afxjzs/solar-logger/logs/evidence/2026-09-25/ina228-purchase-listing.png

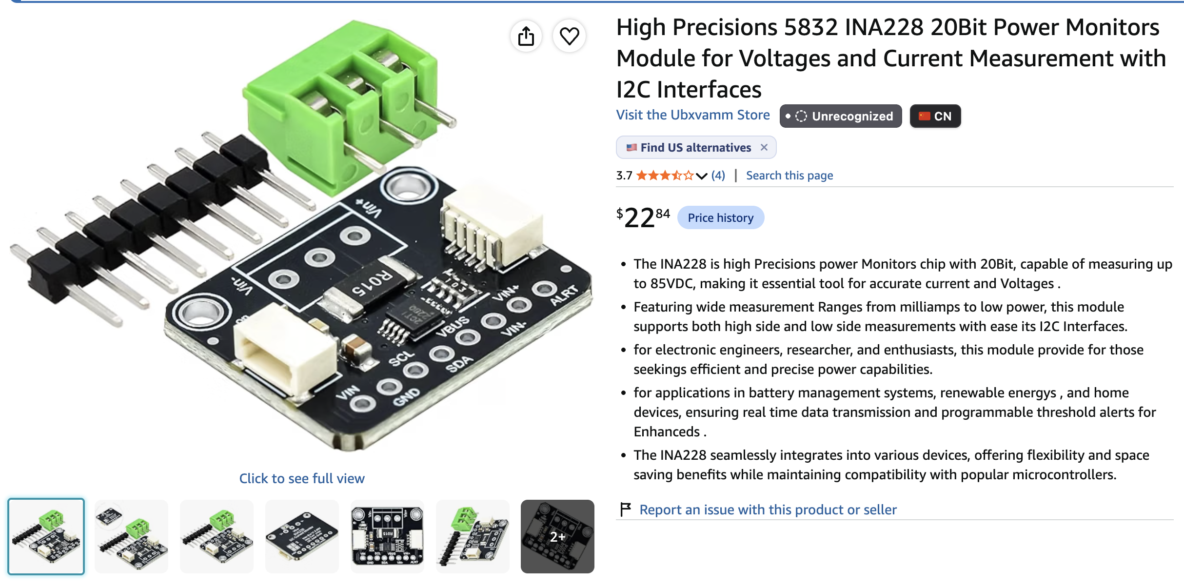
logs/evidence/2026-09-25/ina228-purchase-listing.png
