afxjzs/solar-logger/docs/DECISIONS.md

# Decisions

Entries retain the context and examples from when they were adopted. Later
amendments identify superseded behavior; current operating instructions and
firmware identity are in PROJECT, and dated hardware evidence is in LAB_NOTES.

## D-001: `data/` is live telemetry

The Python logger writes current telemetry to `data/samples.csv`, `data/intervals.csv`, and `data/events.csv`. `logs/` remains archive/legacy data. New code and documentation must use `data/` for live polling output.

## D-002: Upload owns Serial only after logger release

`tools/upload.sh` compiles before serial coordination. When the Python logger is running, the uploader uses `.upload-in-progress` with the content protocol `REQUESTED -> RELEASED`. The uploader must abort if the logger is detected but does not acknowledge release within five seconds. Uploading anyway would allow esptool and the logger to race for the same device.

When no logger process is running, the uploader skips the handshake because no logger can acknowledge it or own the port. It then discovers the current `/dev/cu.usbmodem*` device immediately before upload. The marker is cleaned on success, failure, Ctrl-C, and termination.

## D-003: Commands use a logger-owned handoff

`tools/send.sh` does not open Serial when `app/solar_logger.py` is running. It creates `.serial-command` without overwriting an existing file. The Python logger sends the newline-terminated command through its existing pyserial connection, flushes it, and removes the file.

If the logger is not running, `send.sh` may open the discovered modem directly. If `.upload-in-progress` exists, command sending is refused. These rules keep command sending, live logging, and firmware upload from creating competing Serial owners.

## D-004: Host timestamps supplement firmware time

The Python logger adds timezone-aware local Mac `captured_at` values to samples, intervals, and events. The timestamp approximates when the complete Serial line reached the host. Firmware elapsed time remains in the row because it is the experiment clock and supports relative analysis across an experiment.

## D-005: Existing CSV schemas fail closed

The logger compares an existing CSV header with the expected current header before appending. A mismatch produces an explicit error and stops startup. The logger does not silently place timestamped rows under an old header and does not automatically migrate, rewrite, or delete old data.

## D-006: Wi-Fi bench test state is separate from experiment state

`POWER TEST WIFI` stores its armed state in the separate NVS key `wifi_test_armed`. The test uses `millis()` to run explicit 30-second OFF, ON, and OFF phases without blocking the logger loop. It starts again after reboot when the flag is present.

The Wi-Fi test must not reset, increment, migrate, or rewrite the experiment checkpoint. `POWER TEST STOP` turns Wi-Fi off and clears only the Wi-Fi test flag.

Wi-Fi ON means station mode with no access-point association. That state is useful for measuring the radio subsystem without adding network credentials or network traffic.

## D-007: Host time is the plot coordinate

The live plot uses the timezone-aware host `captured_at` value rather than firmware-relative elapsed time. Firmware elapsed time can move backward after an ESP32 reboot or upload, which creates overlapping x-values. Host capture time remains monotonic across that reboot from the logger's point of view and gives useful local clock labels.

The plot uses fixed-point y-axis formatters with additive offset and scientific notation disabled. Instrumentation values must be visible directly instead of being split between tick labels and a hidden axis offset.

The logger loads only the latest experiment's recent samples at startup and keeps a 15-minute rolling display window during live operation. CSV remains the complete history; the plot window is display-only.

Startup history is loaded before Serial polling begins. Both `samples.csv` and `intervals.csv` are schema-validated, malformed rows are warned about and skipped, and the logger prints exact loaded counts and the time range. This makes a blank restart distinguishable from genuinely empty or invalid history.

## D-008: Plot interruptions are display metadata

A serial interruption inserts one guarded NaN marker into the in-memory live plot series. Matplotlib breaks its line at NaN, so the old and new segments do not receive a false connecting line. The marker is not written to any telemetry CSV.

This preserves a visible break across upload and Serial reconnect without fabricating telemetry. New experiment boundaries still clear the plot, while host logger restarts reload recent history instead of treating the restart as a new experiment.

## D-009: Cumulative charge uses interval accounting

The live plot's fourth chart uses `running_charge_mAh` from `CSV_DATA` rows and `data/intervals.csv`. It uses the host `captured_at` timestamp for its x-coordinate and updates only when a completed 60-second accounting interval arrives.

The host does not integrate the one-second sample stream again. The chart represents charge delivered through the INA228-measured solar path and is not battery state of charge. The current application does not display or claim to measure voltage-derived battery SOC. Future SOC work should consider BMW IBS integration and/or a rested-voltage model.

## D-010: Interactive plot view is user-controlled

The plot provides visible `Home`, `−`, `+`, and `Follow` buttons in addition to the native Matplotlib toolbar when available. `+` and `−` directly change the shared time window without changing Follow. Follow is an independent toggle: ON shifts the selected-width window to the newest data, while OFF preserves the inspected view. `f` toggles Follow; `h`, `z`, and `p` mirror Home, zoom in, and zoom out. Hover values use `mplcursors` and show local time plus the plotted measurement. Persistent line artists and cursors are updated in place instead of being recreated on every sample, and the redraw path does not block with a pause.

## D-011: Deep-sleep test state splits across NVS and RTC memory

`POWER TEST SLEEP` stores its armed flag in the NVS key `sleep_test_arm`, separate from both experiment state and the Wi-Fi test's `wifi_test_armed` key. That flag must survive complete power loss, because the whole point is arming the test over USB and then unplugging USB before applying AA battery power.

The per-cycle counter is stored in RTC-retained memory instead, not NVS. The test sleeps every 30 seconds, which is 2,880 write cycles per day; NVS is flash with finite erase endurance, and the counter has no meaning outside one continuous battery run. RTC slow memory has exactly the right lifetime: retained across deep sleep, lost on power loss.

RTC memory contents are undefined after a power-on reset, so a magic value guards them. Without the guard, a cold boot would read whatever bits happened to be in RAM and report a fabricated cycle number. When the firmware wakes from its own timer but finds the magic missing, it says so explicitly and restarts the counter at 0 rather than printing an invented value.

ESP32 NVS key names allow 15 usable characters. `wifi_test_armed` is exactly 15; `sleep_test_armed` would be 16 and would be rejected, which is why the key is `sleep_test_arm`.

## D-012: Interval accounting is suspended, not silently skipped, during the deep-sleep test

A 60-second accounting interval cannot stay semantically correct across repeated 30-second deep sleeps. `millis()` restarts at zero on every wake, `setup()` clears the INA228 accumulators on every boot, and the board is not awake during sleep. Emitting intervals anyway would produce wrong elapsed time, average current, and average power.

The firmware therefore gates interval accounting off explicitly through a single predicate, announces the suspension when the awake phase starts, and reports it in both `STATUS` and `POWER TEST STATUS`. Relying on the fact that a 30-second awake phase never reaches a 60-second timer would work by arithmetic accident, and nothing would say the logger had stopped accounting.

Experiment ID, interval number, running charge, and running energy are preserved unchanged throughout. `CSV_SAMPLE` and `CSV_DATA` output is suspended for the same reason: `elapsed_seconds` would sawtooth backwards on every wake under an unchanged `experiment_id`. `RESET YES` is refused while accounting is suspended, because a new experiment would be frozen from birth.

The suspension has two causes, both reported by name: the test is running, or a test ended and the INA228 accumulators could not be cleared. The second exists because "the test stopped" and "accounting is safe to resume" are different facts. On a failed accumulator reset the firmware keeps accounting suspended and preserves the cumulative state rather than folding an unaccounted window of unknown length into the next interval.

## D-013: Only one power test may be armed at a time

The Wi-Fi test and the deep-sleep test measure different things and cannot run together. Arming one while the other is armed is refused with an explicit message naming the remedy, rather than silently replacing the armed test and changing what the DMM is measuring.

The two flags live under two NVS keys, which makes one invalid combination representable: both armed. This firmware never creates that state, but if it is ever found at boot the firmware refuses to start either test, says why, and continues normal logging. Guessing which test the user meant would be worse than doing neither.

`POWER TEST STOP` is the single stop path for both tests. It clears whichever flags are set, ensures Wi-Fi is off, resumes interval accounting when it was suspended, and reports failure explicitly for each step that does not succeed.

## D-014: The deep-sleep test has two variants under one armed flag

`POWER TEST SLEEP` and `POWER TEST SLEEP INA OFF` are two variants of one test, not two independent tests. The armed flag lives in the NVS key `sleep_test_arm` and the variant selector in `sleep_ina_off`, which is only meaningful while the armed flag is true.

One armed flag plus one variant flag makes "both variants armed at once" unrepresentable. Two independent armed flags would have added a third invalid state to detect and report, on top of the Wi-Fi/sleep conflict already handled in D-013.

Both flags must be loaded at boot. A variant that silently defaulted after a power cycle would run the wrong experiment while `POWER TEST STATUS` reported the right one, and the DMM reading would be attributed to the wrong configuration. Arming one variant while the other is armed is refused rather than silently swapped, for the same reason D-013 refuses to swap tests: changing what the meter is measuring without saying so is worse than doing nothing.

## D-015: INA228 shutdown is verified against the device, never assumed

The INA-OFF variant enters shutdown through the MODE bits of `ADC_CONFIG`, per TI datasheet SLYS021A Table 7-6, which documents `0h` and `8h` as Shutdown and `Fh` as continuous bus voltage, shunt voltage and temperature. The firmware writes `0h` and accepts either encoding on readback, because the meaningful question is whether the device reports a documented shutdown mode rather than whether it echoes the chosen bit pattern.

Only the MODE field is written. The firmware verifies two conditions before sleeping: that the MODE bits read back as shutdown, and that the non-MODE bits are unchanged. A write that also disturbed VBUSCT, VSHCT, VTCT, or AVG would mean the next wake restored something other than the known-good configuration, and nothing downstream would notice.

If either check fails, the firmware prints an explicit error and does **not** enter deep sleep. A sleep-current reading taken with the INA228 in an unverified state would look exactly like a valid measurement, so the test stops instead.

Restoration is verified the same way. The normal wake path already reconfigures and reads back through `configureIna228()`; the INA-OFF path additionally re-reads `ADC_CONFIG` and confirms continuous mode from the device before printing that measurement was restored.

## D-016: Stale INA228 registers are never reported as measurements

The INA228 answers register reads while shut down, and returns values left over from before shutdown. Printing those next to an "ALL OK" would present stale data as a live measurement.

While shutdown is active, `STATUS` and the heartbeat both state that the INA228 is shut down and report no values at all, rather than reporting old ones. This is the same principle as D-005 and D-008: the system may lose data, but it must never present something plausible in place of something real.

The INA-OFF variant sacrifices solar measurement during every sleep phase by design. That loss is documented and announced when the test is armed and at the start of every awake phase; it is not inferred by the reader from missing rows.

## D-017: Experiment lifecycle is separate from storage lifecycle

An experiment is a logical measurement grouping identified by `experiment_id`. Storage is durable telemetry history ordered by a global sequence number. They are different things with different lifetimes.

`RESET YES` may increment `experiment_id` as it does today. It must never erase stored telemetry, reset the global record sequence, or reset synchronization acknowledgement state. Storage reclamation is a separate operation with its own trigger, and freeing space must never be reachable only by destroying experiment state.

The global sequence number must be monotonic across reboot and power loss. Where the two cannot both be guaranteed, **a gap is acceptable and a duplicate is not**: a gap is visible in the data and harmless, while a reused sequence number silently corrupts a host's record of what happened.

## D-018: Autonomous cadence comes from one authoritative setting

The wake, accounting, and storage cadence of the autonomous logger is governed by a single named setting, `autonomous_interval_seconds`, persisted in NVS. Sixty seconds is the development default because it makes bench testing easy. It is not an architectural commitment.

No second hard-coded cadence may exist in the autonomous path. The existing `MEASUREMENT_INTERVAL_MS` belongs to the host-tethered logger and must not be reused as the autonomous cadence.

Every durable record must store its interval duration rather than merely the configured cadence. Current duration uses commanded sleep plus measured awake time, so it inherits RTC drift and is not independent wall-clock evidence. The known overrun branch violates the intended accumulator/boundary alignment; see D-032 and the strict `xfail` in BACKLOG.

ESP32 wake cadence and INA228 conversion cadence are separate concepts. The INA228 continues converting and accumulating CHARGE and ENERGY in hardware while the ESP32 sleeps, so a longer wake interval costs temporal resolution of the voltage, current, power, and temperature snapshots without costing accuracy of integrated charge and energy.

## D-019: Wall-clock time is synchronizable state, never fabricated

The logger must always be able to create durable records using its global sequence number, whether or not absolute time is known. `seq` is the primary ordering key, it never depends on wall-clock time, and `experiment_id` is not a timestamp and must never be used as one.

Records carry an explicit **time-quality field** rather than a single valid bit, because "the clock was correct when this was written" and "the clock was set some time ago and has been drifting since" are different claims that a host must be able to tell apart:

- `UNKNOWN` — no clock has been set this session; `epoch_s` is 0
- `SYNCHRONIZED` — clock set this session, recently enough to trust
- `HOLDOVER` — clock was set this session, but long enough ago that drift is no longer bounded

When absolute time is known it is stored internally as Unix epoch seconds. `epoch_s` and the quality field always travel together, and a host must never read one without the other.

**Setting the clock is one logical operation, `SET_TIME <unix_epoch_seconds>`, with identical semantics on every transport** — USB serial from the Python logger, Wi-Fi via NTP, or a Bluetooth client. Transport may change; record semantics may not. The operation is idempotent and must never rewrite, reorder, or invalidate records already stored.

The build carries the system clock across deep-sleep wake through the RTC domain (`CONFIG_LIBC_TIME_SYSCALL_USE_RTC_HRT=y`). **Absolute time is not assumed to survive complete loss of board power**, and the design must not depend on it doing so.

A host may retrospectively anchor records written before a sync, using the session identifier and session-relative elapsed time each record carries. That is a host-side operation on the host's own store: **the device never rewrites its own records, and never writes a timestamp it did not have.** This is why there is no device-side `DERIVED` quality value — a derived timestamp and a synchronized one must stay distinguishable permanently. Anchoring works for the current power-on session only; a power cut ends the session and destroys the anchor.

Clock drift and periodic resynchronization are normal operating considerations, not failure modes. The RTC slow clock is the internal RC oscillator (`CONFIG_RTC_CLK_SRC_INT_RC=y`), calibrated at boot but not crystal-backed, and nothing in this project may describe it as precision wall-clock hardware. No absolute-time accuracy figure may be published in documentation, firmware output, or host tooling until drift on this board has been measured.

**Implementation status, 2026-09-23:** records currently use only `UNKNOWN` with `epoch_s = 0`. `SET_TIME`, clock-age tracking, synchronized/holdover transitions, and host anchoring are not implemented. The statements above define the intended contract. D-053 now selects the iPhone over BLE as the intended installed clock source; Wi-Fi/NTP remains optional and USB time-setting a possible bench aid.

No external RTC is required or added. One becomes worth considering only if a measured drift figure, or a real need for wall-clock continuity across power loss, justifies it.

## D-020: Accumulators are read before they are reset

The INA228 hardware CHARGE and ENERGY registers hold the integral of the entire period since they were last cleared, including any period during which the ESP32 was in deep sleep. Any code path that resets them without first reading them destroys that integral, and destroys it silently.

The pre-autonomous `setup()` did exactly this. Current cold-boot initialization still resets the accumulators, but a normal armed timer wake takes the early branch into `runAutonomousWakeCycle()` first: read, durable append, then reset. RTC-loss recovery deliberately discards an unknown-duration interval with diagnostics. The original hazard is not the normal autonomous wake path today.

An autonomous wake reads `DIAG_ALRT` first, then CHARGE and ENERGY, builds and durably stores the record, and only then resets the accumulators for the next interval. Reads come before writes; the 2026-09-23 extension below establishes the required order between those reads.

**Extended 2026-09-23, after those flags turned out to qualify nothing.** Reading an accumulator clears its own overflow flag. SLYS021A Table 7-16 states that ENERGYOF "Clears when the ENERGY register is read" and CHARGEOF "Clears when the CHARGE register is read". `runAutonomousWakeCycle()` read both accumulators and only then read `DIAG_ALRT`, so both bits were always zero by the time they were sampled and `AUTO_FLAG_INA_ACCUM_OF` was unreachable for a genuine overflow.

The decision this adds, and the reason it is recorded here rather than only as a fixed bug: **a flag that is destroyed by the read it qualifies must be sampled before that read, not merely in the same wake.** "Reads come before writes" was the right rule for the accumulators and is not sufficient for the flags, because a read is a write as far as these three bits are concerned. Any future code that reads CHARGE or ENERGY inherits this obligation.

`MATHOF` is exempt — a read does not clear it — and is cleared by the next conversion instead, so in continuous mode it qualifies approximately the latest conversion rather than the interval. That is an open question, not a settled part of this decision.

**Ordering fixed in source 2026-09-23 and hardware-smoke validated on `eba3b5d` (2026-09-24)**: DIAG_ALRT is read before CHARGE and ENERGY; flag logic is unchanged and regression tests pin the order. This is no longer an open ordering question. **No real accumulator overflow has been induced, and INA_ACCUM_OF has not been observed SET from one.** Pre-fix stored records are not retroactively qualified: their zero is not evidence of no overflow. `closeMeasurementInterval()` still performs no overflow check. MATHOF interval semantics and induced-overflow validation remain open in BACKLOG. See [LAB_NOTES.md](LAB_NOTES.md#2026-09-24-hardware-validation-addendum--clean-record-format-and-working-tree-recovery).

A wake must not reconfigure an INA228 that is already configured and already converting. Writing the `ADC_CONFIG` MODE bits interrupts and restarts a conversion in progress, discarding accumulation that had not yet been committed. Reconfiguration belongs on cold boot, where the device state is genuinely unknown.

## D-021: An armed autonomous logger must always offer a guaranteed management window

Measured on hardware 2026-09-11. An armed board could not be stopped over USB, because the Serial command parser runs only from `loop()` and an armed cold boot returned from `setup()` straight into deep sleep. The parser was never reached, so a correctly delivered `LOGGER TEST STOP` was never read. The only remaining recovery was reflashing.

A device that can arm itself into autonomous operation must always provide a bounded, guaranteed period in which management commands are parsed. The window may not depend on catching a short wake, on host timing, or on USB-presence detection.

On this firmware the window opens on a true cold boot, lasts `AUTONOMOUS_COLD_BOOT_MAINTENANCE_MS` (15 seconds during development), announces itself and counts down, and must be entered before any path that sleeps. Timer wakes do not open one, because awake time dominates the power budget and the recovery path already exists at every reset.

A stop that is requested but cannot be persisted must not be followed by deep sleep. Sleeping after an explicit stop request is the same failure this window exists to prevent, so the firmware refuses to sleep and states that the flag is still armed.

## D-022: A command is acknowledged only when the firmware says so

**Historical implementation below:** echo-based acknowledgement was replaced by
D-036 machine ACK/RESULT, D-041 completion semantics, and D-045 missing-ACK
handling. The logger-owned queue still cannot report device completion.

Writing bytes to a serial device proves that the host accepted them. It proves nothing about whether the firmware read, parsed, or executed them.

`tools/send.sh` previously printed `Sent` and `ALL OK` after a successful write. During the 2026-09-11 run it reported exactly that for a `LOGGER TEST STOP` the firmware never processed, and the operator had no way to tell the difference from a real success. A status line that reports intent rather than outcome converts a caught failure back into an uncaught one.

The direct-serial path now waits for the firmware's own `[COMMAND] Received: <COMMAND>` echo and reports `ALL OK` only when that echo is observed. Its exit status reflects the same fact, so a retry loop keeps retrying until the command actually lands. When no echo arrives it says the bytes were written, says the acknowledgement was not observed, and prints the firmware output it did see.

The logger-owned path still queues the command to a file and cannot observe the outcome, so it now says it queued the command and states plainly that it did not see an acknowledgement. It deliberately captures nothing: opening the port there as a second reader is the multi-owner problem the command file exists to avoid, and the logger's own console already shows the response.

Once acknowledged, the direct path keeps reading and printing firmware output, so a direct send behaves like a short one-shot serial monitor instead of proving a command ran and then hiding what it said. Capture ends when the port has been quiet for a configurable period, or at a hard cap, and **the stop reason is always printed**. A capture cut short by the cap says so on stderr and warns that output may be truncated, because output that merely stops looks identical to output that finished.

`ALL OK` continues to refer to the acknowledgement alone. It is printed when the echo is seen, and neither a truncated capture nor an empty one changes it or the exit status, since a reporting limit is not a failed command.

## D-023: The durable log is the sequence authority when it is provably intact

Sequence numbers are reserved from NVS in blocks of 64 so that a crash inside a block abandons the remainder, producing a visible gap instead of a silent reuse. That rule stands: gaps remain acceptable, duplicates remain forbidden.

The implementation applied it too aggressively. Every arm and every cold boot re-reserved unconditionally, and the next sequence was always taken as one past the NVS reservation, so each restart burned 65 numbers whether or not the previous block had been used. One eight-record run plus two cold boots moved the next sequence from 9 to 131.

Nothing but an append ever writes a record, so an intact log tail is also the authority on the highest sequence ever used, and a clean restart may continue directly from it. The NVS reservation is the floor in every other case, because then the tail cannot be trusted to show everything that was written: an empty log may have been cleared after records were synced, a partial or corrupt tail means records were lost, and out-of-order sequences mean a reuse already happened. A reservation is written only when the existing one does not already cover the sequence about to be used.

This holds only while records are never removed. Once pruning exists, a pruned log no longer carries the highest sequence ever used, and the NVS floor has to apply unconditionally again.

## D-024: A record field may only come from a source the writing path has actually initialized

The autonomous timer-wake branch runs at the top of `setup()`, before the ordinary cold-boot initialization, because the INA228 accumulators must be read before anything can reset them. That ordering is correct and stays.

The cost of it is that every global the normal path initializes later is still at its startup value on that path. `experiment_id` was read straight from the `experimentId` global, which `loadCheckpoint()` populates further down `setup()`, so 65 records were stored claiming experiment 0 while the board was running experiment 2. Nothing errored. The field was populated, well-formed, CRC-correct, and wrong.

Any field written on an optimized early path must come from a source that path has actually established: a constant, RTC-retained state guarded by its magic, a value read during that path, or a dedicated read-only load. Reusing a global because it happens to exist is not sufficient, and a field that looks populated is not evidence that it was.

Where a dedicated load is needed, it is a **small read-only helper**, not the full initialization routine. `loadCheckpoint()` cannot be reused here: it is loud enough to distort the wake timings the bench test exists to measure, and it writes four globals belonging to the host-tethered logger. A helper that duplicates part of another function's rules must say so, because the failure mode is the two disagreeing about the same board.

**No silent fallback.** When context cannot be loaded, the record is marked `EXPERIMENT_UNKNOWN`, `experiment_id` is written as `0xFFFFFFFF`, and the firmware prints an explicit error. It never writes a plausible default. The measurement itself stays valid and is still stored: only the attribution is unknown, and conflating the two would discard good data.

## D-025: Sleep policy asks whether any host is connected, never whether USB is

The autonomous state machine decides whether it may sleep by calling `anyHostConnected()`, backed by a transport bitmask of `CONNECTION_USB`, `CONNECTION_WIFI`, and `CONNECTION_BLE`. Only USB is implemented. The other two exist so a Wi-Fi or BLE client can hold the board awake later without the sleep logic learning anything new.

**Electrical presence is not a claim.** A transport becomes active only through an explicit software lease, never because a cable is plugged in. The 2026-09-11 audit settled this: `isPlugged()` is a start-of-frame watchdog whose own core source says it "is known to flap even on a healthy link", and `isConnected()` reads false whenever no terminal holds the port open even with USB attached. Neither can decide whether a board may sleep. Both are still printed as diagnostics, and nothing depends on them.

The lease is what makes this safe in both directions. It is a positive claim from software that is actually talking to the board, and it expires on its own, so a crashed host, a pulled cable, or a laptop suspending all resolve without the host's cooperation. `LOGGER SESSION RELEASE` is an optimization that returns the board immediately; it is never the only recovery path.

## D-026: A host session suspends autonomous sleep without disarming autonomous mode

`LOGGER TEST STOP` and `LOGGER SESSION HOLD` are different operations and conflating them would be expensive. STOP persistently disarms the autonomous test. HOLD keeps the board awake while a host is attached and leaves autonomous mode **armed**.

```text
autonomous armed = YES, host session held = YES
```

is a normal, valid state: a host is driving a board that resumes autonomous operation the moment the host lets go. `LOGGER SESSION RELEASE` ends the session and continues the already-armed autonomous operation.

While a session is held, interval accounting is **not** suspended. Suspension is now keyed to the autonomous state rather than to the armed flag, because a host session is ordinary awake tethered operation and the host connected in order to collect that telemetry. Autonomous records and tethered intervals still never run at the same time: records are written only on timer wakes, and a timer wake cannot happen while the board is awake.

**The transition back is the accounting-sensitive part.** When a session ends, the tethered interval that is open at that moment is closed cleanly before sleeping, recording its real elapsed length. Leaving it open would roll its charge into the first autonomous record, producing an interval made of tethered awake time plus deep-sleep time. Discarding it would be silent charge loss. Closing it is both honest and exactly the clean accumulator baseline the next autonomous interval needs. If the close fails, the firmware **refuses to sleep** and stays awake for diagnosis, because measurement integrity outranks minimizing awake time.

## D-027: Serial output may never block the state machine

`HWCDC` defaults to `tx_timeout_ms = 100` with `max_consec_timeouts = 20`, so a single blocked `Serial` write stalls for about two seconds once the 256-byte TX ring buffer fills and nothing drains it. `isPlugged()` keeps reporting true after a host closes the port, so the driver waits rather than giving up.

On 2026-09-11 that held `setup()` for roughly 74 seconds after a host claimed a rendezvous, which is why `loop()` was never reached and the 15-second host lease never expired. A logging side effect disabled a safety mechanism.

The firmware therefore sets `setTxBufferSize(4096)` before `begin()` and `setTxTimeoutMs(0)` immediately after. Output is dropped rather than waited on when nothing is draining the port.

This is a deliberate trade, not an oversight. Serial output is diagnostics, and diagnostics may never stall measurement, sleep decisions, or lease expiry. Dropping only happens when nothing is reading, which is when the text has no recipient. Unattended capture is the durable record log's job and never Serial's, so nothing that must survive depends on this path.

Any future code that must run on a deadline belongs outside a `Serial.print()` chain, and any long-running initialization must assume it can be preempted by a lease that expires while it runs.

## D-028: The tethered baseline is established when the host claims the board

A host session's measurement interval starts at `LOGGER SESSION HOLD`, not at the end of `setup()`. `HOLD` discards the rendezvous accumulation with an explicit statement, resets the INA228 accumulators once, and starts the interval timestamp. The ordinary initialization further down `setup()` then **skips** its own reset and says so.

The previous ordering reset the accumulators a second time, hundreds of lines and several seconds after the claim, discarding everything measured in between without a word. Combined with D-027 that silently lost about 74 seconds of charge and left `RELEASE` closing a 9 ms interval.

When a baseline cannot be established because the accumulator reset fails, the session is still claimed but the firmware states that the interval is **not** clean, so whatever it eventually closes is not read as a trustworthy measurement of the session.

A short final interval at release is not by itself evidence of loss: when an ordinary 60-second interval closes moments before release, the remainder legitimately is milliseconds. Release therefore reports the session length and how many ordinary intervals closed during it, so the two cases are distinguishable without inspecting the CSV.

## D-029: One host-side implementation of the device and session protocol

Three programs speak the sleeping-device protocol: `app/solar_logger.py`, `tools/send.sh`, and `tools/upload.sh`. They share one implementation in `app/device_session.py`, reached from the shell through `app/device_tool.py`. None of them may reimplement port discovery, rendezvous waiting, acknowledgement handling, or the session lease.

Protocol strings and host timing constants live in that module and nowhere else. Command text, the acknowledgement prefix, baud rate, port glob, ack timeout, keepalive cadence, and response capture windows are defined once. A magic string copied into a caller is how the three drift apart, and drift here means one tool believing it holds a session that another tool's firmware already released.

The module exposes two shapes because callers genuinely differ. `SerialDevice` owns a port for one-shot work and reads it directly. `SessionClient` owns nothing: it writes through a callback and is fed received lines by whoever does own the port. The logger needs the second, because it runs its own read loop and a second reader would steal the telemetry it exists to collect.

**The firmware remains authoritative for its own lease length.** The host mirrors 15 seconds only to reason about margin. If they ever disagree, the firmware wins and the host's keepalive cadence is what changes.

Host abstractions mirror the firmware's transport model rather than assuming USB. A session is a lease held over some transport, and USB is simply the only one implemented on either side today.

## D-030: A command echo proves parsing, not success

**Historical implementation below:** the distinction remains valid, but the
host now derives session outcomes from `CMD_RESULT`, not the listed human
lines. See D-036, D-041 and D-045.

The firmware prints `[COMMAND] Received: <COMMAND>` from `processCommand()` **before** dispatching, so it echoes a command it is about to refuse. `LOGGER SESSION HOLD` on a board that is not in autonomous mode is echoed and then rejected.

Treating the echo as success would leave the host convinced it holds a lease that was never granted, reporting a session the board does not have, and skipping the reconnect logic that should have run.

The host therefore tracks two different things. The echo means the command was **parsed**. A separate outcome line means it **succeeded or failed**: `[SESSION] Host session held: ALL OK`, `[SESSION] NOT ALL OK - HOLD refused.`, `: lease renewed for `, `[SESSION] NOT ALL OK - lease NOT renewed.`, `[SESSION] Released: ALL OK`, and `[SESSION] Host lease EXPIRED after`. Session state is keyed on the outcome, never on the echo alone.

A refused hold is not an error. It is how a board that is not in autonomous mode says no lease is needed, and the logger continues in ordinary tethered operation.

## D-031: Autonomous operation is a mode, not a test

Autonomous sleep/wake/store graduated from a bench test to the canonical operating mode on 2026-09-11, after the timer wake, USB rendezvous, host session, keepalive, and release paths were all confirmed on hardware. The commands say so:

```text
LOGGER AUTONOMOUS ON       enable it persistently
LOGGER AUTONOMOUS OFF      disable it persistently
LOGGER AUTONOMOUS STATUS   mode, cadence, storage, session state
```

`LOGGER TEST AUTONOMOUS`, `LOGGER TEST STOP`, and `LOGGER TEST STATUS` still work as aliases so existing scripts and written procedures keep running, and each prints a deprecation notice naming its replacement. A name that is quietly wrong is worse than one that complains, and silently breaking a recorded procedure is worse than both. Host code uses the canonical names only.

**`LOGGER AUTONOMOUS OFF` does not tear down a live host session.** Autonomous mode is the only thing the lease was gating: with it off the board stays awake either way, so dropping the session would break a connected host's keepalives and gain nothing. The session is kept and the new state is reported, so the host learns about it from `STATUS` rather than from its next keepalive suddenly failing. `KEEPALIVE` and `RELEASE` continue to work normally for that session.

Historical entries in [LAB_NOTES.md](LAB_NOTES.md) keep the command names that were actually typed at the time. Rewriting them to the new spelling would falsify the record of what was run.

## D-032: Autonomous cadence is a deadline, not sleep duration

`LOGGER INTERVAL <seconds>` defines the time from one autonomous interval
boundary to the next. The USB rendezvous and all other awake work are inside
that cadence, not added to it. Before deep sleep, firmware computes the target
as `interval_start + configured_interval` and sleeps only for the remaining
time. The remaining duration is measured from retained monotonic session time;
it is never a hardcoded subtraction for the rendezvous window.

If awake work reaches or passes the target, firmware prints an explicit
warning, starts the next interval at the current time, and sleeps one full
configured cadence. The record already being closed retains its actual
measured duration. This avoids both silent drift and an immediate-wake loop.

The accumulator read, durable append, and accumulator reset ordering remains
unchanged. A rendezvous claim still transitions to the ordinary host-session
path rather than changing the autonomous record cadence.

**Known exception, found 2026-09-18 and still open:** the overrun branch moves
the boundary without resetting the accumulators. The next record understates
the duration its charge covers; every unclaimed 10-second cadence reaches this
branch. The full-cadence fallback avoids an immediate-wake loop but does not
make that next record correct. BACKLOG and the strict schedule-test `xfail`
track the required correction; this decision is not proof it has been fixed.

## D-033: `session_elapsed_ms` is monotonic within `boot_id`

The stored field `session_elapsed_ms` means milliseconds since the cold boot
that established the autonomous session. It is monotonic within one
`boot_id`, subject to the normal uint32 rollover limit. A timer wake retains
the session clock in RTC state; a host session released from that wake must
continue that retained clock rather than rebasing it to `millis()`, which
starts near zero after every deep-sleep reboot.

If RTC session state is genuinely lost, firmware rebuilds from durable
storage, starts a new boot/session identity, and explicitly discards the
unknown-duration interval. It does not claim continuity it cannot verify.

**Amended by D-046 on 2026-09-18:** continuing the clock across a released
session now counts the session exactly once, and measures it with `millis()`.
The `micros()` form it used wrapped after 71.6 minutes, inside an ordinary
logger session.

## D-034: All autonomous handoffs use the shared deadline scheduler

Unclaimed rendezvous expiry, host `RELEASE`, host lease expiry, cold-boot
resume, explicit arm, and RTC-loss recovery all enter autonomous sleep through
`autonomousDeepSleepAgain()`. The scheduler uses the retained session clock for
timer-wake measurement and timer-wake host handoff paths, and `millis()` for
paths that start a new session on the current boot.

`RELEASE` and lease expiry close the open tethered interval and establish a new
autonomous interval boundary at that handoff. A full configured sleep from
that boundary is therefore intentional; the handoff overhead is before the
new boundary, not silently added to an existing autonomous interval. An
unclaimed rendezvous does not establish a new boundary and sleeps only until
the existing deadline.

**Amended by D-046 on 2026-09-18:** the code did not follow this rule for
either handoff. The scheduler added the awake time since `setup()` entry to a
clock the handoff had already advanced past it, so the first sleep after a
RELEASE or lease expiry was short by the time spent awake. The rule above is
unchanged, and the code now follows it.

## D-035: RELEASE acknowledges before autonomous teardown

`LOGGER SESSION RELEASE` intentionally destroys the USB transport it uses for
its own acknowledgement. The command therefore performs the accounting-safe
handoff preparation and prints its explicit success result, then marks sleep
pending. The main loop waits a bounded 250 ms grace period before entering
autonomous deep sleep.

The grace period is a hard deadline, not a serial timeout or an unbounded
flush. `Serial.setTxTimeoutMs(0)` remains in force, so a missing host cannot
stall lease expiry or the state machine. Lease expiry has no requesting
command to acknowledge and continues directly from safe accounting into the
shared autonomous scheduler.

## D-036: Machine command protocol is separate from diagnostics

The human-readable `[COMMAND] Received: ...` line is not a protocol
acknowledgement. With ESP32 HWCDC `setTxTimeoutMs(0)`, a write can return a
short count when the TX ring is full, and Arduino `Print` callers do not expose
that short write. The first diagnostic line can therefore be absent even when
the command was parsed and later output is visible.

Every parsed command now emits `CMD_ACK,<command>`, followed by
`CMD_RESULT,<command>,<status>` after dispatch. The firmware retries only these
small protocol lines with a 100 ms hard deadline. Ordinary diagnostics retain
the global zero TX timeout and may still be dropped; they cannot stall lease
expiry or measurement scheduling.

The host requires both machine stages for normal success. A transport loss
after a successful result is reported separately and is expected for RELEASE;
bytes-written, parsed, completed, and disconnected are never conflated.

**Amended by D-045 on 2026-09-18:** a RESULT whose ACK was lost is accepted as
the outcome, but always reported as not a clean exchange.

## D-037: Firmware build identity is source-controlled

The firmware prints `[FIRMWARE] Build: solar-logger-protocol-ack-v2` at boot
and through `STATUS`. This deterministic source-controlled identifier marks the
machine-ACK/RESULT protocol generation without depending on wall-clock compile
times or an unavailable Git repository during Arduino CLI compilation.

Superseded in scope by D-038, which keeps this identifier and adds the two
facts it was never meant to carry. The build ID still answers only "which
generation of the command protocol does this image speak".

## D-038: Firmware identity is three separate facts

"What is on this board?" is three questions, and one string cannot answer them.
`Arduino/solar-logger/firmware_version.h` holds all three and the firmware
prints them together at boot, inside `STATUS`, and on the new `VERSION`
command:

```text
[FIRMWARE] Version:  0.1.0-dev
[FIRMWARE] Revision: 063e048-dirty
[FIRMWARE] Build ID: solar-logger-protocol-ack-v2
```

- **Version** is intent, edited by hand and never derived from Git. A commit
  hash states what the source was; it cannot state what the change was for.
- **Revision** is fact: `git rev-parse --short HEAD`, with `-dirty` when the
  sketch directory differs from `HEAD`. Both a `git diff` against tracked files
  and a check for untracked files are needed, because a new `.h` in the sketch
  directory is compiled into the image and is invisible to the first.
- **Build ID** is protocol generation, deliberately coarse, unchanged from
  D-037.

The revision is injected only by `tools/upload.sh`, through
`--build-property compiler.cpp.extra_flags=-DFIRMWARE_GIT_REV="<rev>"`. That
property is empty in the ESP32 platform.txt, so setting it replaces nothing.

**Every other build leaves it undefined and the firmware says so**, printing
`UNKNOWN - not injected by this build`. IDE builds, plain `arduino-cli compile`
and the IntelliSense pass all keep working unchanged; none of them produces an
image that claims a revision it does not have. Both branches were verified in
the linked image on 2026-09-16.

**The compile timestamp is deliberately not part of this.** Two builds of one
source would carry different identities, and two builds of different source
could carry the same one, so it answers neither question correctly.

Version policy while pre-1.0 is in [PROJECT.md](PROJECT.md).

## D-039: The editor's view of the sketch is generated, and verified before it is used

An Arduino `.ino` is not a C++ translation unit. Arduino CLI concatenates the
sketch, prepends `#include <Arduino.h>`, synthesizes forward prototypes, and
compiles the generated `build/sketch/<name>.ino.cpp`. The compilation database
therefore describes a file nobody edits, and cpptools, which matches entries by
path, finds no configuration for the file that is open.

Three further facts were established on 2026-09-16 and each one alone produces
the reported symptom:

- **ESP-IDF include paths reach the compiler only through indirection.** The
  Arduino library paths arrive as plain `-I` flags; every ESP-IDF path arrives
  as `-iprefix <sdk>/include/` plus a GCC response file holding 325
  `-iwithprefixbefore` entries. That split is exactly the reported split:
  `Wire.h`, `Preferences.h`, `WiFi.h` and `LittleFS.h` resolved while
  `soc/soc_caps.h`, `freertos/FreeRTOS.h`, `esp_sleep.h` and `esp_rom_crc.h`
  did not.
- **cpptools excludes `**/.vscode` by default** (`C_Cpp.files.exclude`), and
  the database and the generated sketch mirror were both inside it.
- **cpptools defaults `C_Cpp.errorSquiggles` to `enabledIfIncludesResolve`,**
  which suppresses every other error while any include fails. A second class of
  error was therefore invisible for as long as the first one lasted.

The configuration is generated by `tools/intellisense.sh` and
`tools/intellisense.py`, which resolve all response-file and `-iprefix`
indirection into absolute `-I` flags, so the editor has nothing left to follow.
**No path under `~/Library/Arduino15` is written down anywhere**; every flag
comes from the database Arduino CLI just produced.

**The generator proves its output before it writes it.** It compiles the raw
`.ino` with `-fsyntax-only` using exactly the flags the editor is about to be
handed, and on failure prints the compiler's own diagnostics and leaves the
previous database in place. A configuration that has not been compiled is a
claim, not a fact.

The sketch's side of the bargain is that it declares its own forward
references. Eighteen functions were called above their definitions, which the
real build never noticed because Arduino CLI supplied the prototypes. They are
declared in the sketch now, so the file stands on its own as ordinary C++ and
the verification step catches the next one by name.

**Amended by D-048 on 2026-09-18:** every project module now gets an entry of
its own, found by discovery. And the database the editor reads is no longer
the file Arduino CLI writes: they were the same file, so a failed verification
left the editor with Arduino CLI's raw database while the script said the
previous one was still in place.

## D-040: Waiting for a rendezvous is the default; session-scoped commands never wait

The board's normal state is autonomous sleep, so a missing `/dev/cu.usbmodem*`
is an ordinary condition rather than a failure (D-025). `tools/send.sh` now
waits for the next USB rendezvous by default. `--no-wait` asks for immediate
failure; `--wait` still parses and is now the default.

**`LOGGER SESSION KEEPALIVE` and `LOGGER SESSION RELEASE` are excluded, and
this is the whole point of the rule.** They address a session that already
exists. A session is a lease held over one transport, so when that transport
disappears the session is over: the firmware's 15-second lease expires on its
own and the board resumes autonomous sleep with no host cooperation. Waiting
would deliver a stale command to a board that has since slept, woken, and
opened a *new* rendezvous — possibly one another process just claimed. The
firmware answers `NOT_HELD` when no session is held, so the harmless case is
covered; the harmful case is releasing somebody else's session, and it is not.

These two therefore never wait, and an explicit `--wait` on them is **refused
with exit status 2** rather than silently ignored. Silently ignoring a flag is
the deviation failure, not the safe option.

`LOGGER SESSION HOLD` is not excluded. It *creates* a session rather than
addressing one, so any rendezvous will do and waiting is exactly right.

The classification lives in `app/device_session.py` as
`requires_live_session()`, so all three host tools agree by construction
(D-029). `tools/upload.sh` passes `--no-wait` explicitly, because it runs
inside its own retry loop and owns the decision about a vanished port.

A stronger rule was considered and deliberately not built: recording the port
and time of each successful HOLD, and requiring KEEPALIVE and RELEASE to match
that record. It closes the remaining window — a command sent while a *different*
session is live on a present port — at the cost of host-side session state with
its own staleness problem. It is in [BACKLOG.md](BACKLOG.md) rather than here.

## D-041: `CMD_RESULT` reports completion, never recognition

`processCommand()` emitted `CMD_RESULT,<command>,OK` whenever the dispatcher
matched a branch. Only `SESSION HOLD`, `KEEPALIVE` and `RELEASE` reported a real
outcome. Every other command answered `OK` after refusing, after a failed NVS
write, after a failed format, and after a rejected argument.

`tools/send.sh LOGGER AUTONOMOUS OFF` therefore printed `ALL OK` and exited 0
for a board that was still armed, because `SerialDevice.send_command()` keys
completion on the literal `OK`. That is the 2026-09-11 failure D-022 was written
about, reproduced inside the machine protocol built to prevent it, and it
contradicted D-036's own "bytes-written, parsed, completed, and disconnected are
never conflated".

The contract is now explicit and the three stages stay distinct:

```text
CMD_ACK,<command>             parsed and ACCEPTED FOR EXECUTION
CMD_RESULT,<command>,OK       the command COMPLETED successfully
CMD_RESULT,<command>,ERROR    parsed, but did not complete successfully
```

The wire format is unchanged. `HOLD` keeps `REFUSED` and `RELEASE` keeps
`NOT_HELD`, because those carry information `ERROR` would discard; the host
treats anything other than `OK` as not-completed either way.

Every handler with a meaningful failure mode returns `bool` and that return
reaches the single emission site. Handlers that cannot fail stay `void`.
**A refusal counts as a failure**: a command that was declined did not do what
was asked, and a host retry loop needs to know the difference between "declined"
and "done".

Two cases are deliberately `OK` rather than `ERROR`, because they are idempotent
successes rather than no-ops: arming something already armed, and disarming
something already off. In both the requested end state holds and nothing failed.
`RESET` and `LOGGER STORAGE CLEAR` without their confirmation word are also
`OK` — explaining that confirmation is required is what those commands do.

An unrecognized command is `ERROR`, as before. It never ran, so it cannot have
completed.

The build ID moves to `solar-logger-protocol-ack-v3`, which is exactly what that
identifier exists for: a host can tell a board that reports completion from one
that reports recognition.

**`LOGGER AUTONOMOUS ON` was a second, opposite defect on the same contract.**
It ended in `esp_deep_sleep_start()`, which does not return, so on the path where
it SUCCEEDED no result was ever emitted and the host reported a failure for a
board that had armed correctly. It now uses the same bounded deferred-sleep
handshake D-035 built for `RELEASE`: emit the result, then sleep from `loop()`
after the grace period. The mechanism carries the sleep path with it rather than
assuming RELEASE.

## D-042: A record condition with no spare flag bit gets an impossible sentinel

`readSensor()` returns false without writing any field, and the autonomous wake
cycle built its record from an uninitialized `SensorReading`. A failed snapshot
therefore stored whatever was on the stack as `bus_uV`, `avg_current_uA`,
`avg_power_uW` and `temp_mC`, in a CRC-correct, correctly-sequenced record whose
flags said nothing was wrong. The interval charge and energy were read earlier
and separately and were unaffected.

The record is still stored. Discarding a valid interval integral to avoid
reporting a bad instantaneous sample would lose the more valuable half, and the
same reasoning as D-024 applies: the measurement stays valid, only part of its
context is unknown.

**All eight `flags` bits are assigned** (STORAGE_SYNC_DESIGN.md Section 5) and
the 72-byte layout is frozen, so there is no bit for a ninth condition. D-024's
pattern is flag-plus-sentinel; here only the sentinel is available.

The values are chosen to be physically impossible rather than plausible:

```text
bus_uV         UINT32_MAX = 4294.97 V   against an 85 V part maximum
avg_current_uA INT32_MIN  = -2147 A
avg_power_uW   INT32_MIN  = -2147 kW
temp_mC        INT32_MIN  = -2147483 C
```

A zero fallback was rejected for the reason D-016 gives: zero is a reading.
Reusing `ACCUM_SUSPECT` was rejected because it claims something untrue about
the accumulators, which were read successfully.

`LOGGER STORAGE DUMP` decodes the sentinel and prints `SNAPSHOT_UNREAD`, so the
condition is named rather than left as four strange numbers.

**The flag byte being full is now a constraint on the design, not an
accident.** The next condition that needs marking cannot reuse this trick — two
sentinel conventions would be worse than one schema change — so it forces a
record version bump, and that is a decision to take deliberately rather than
discover. No stored record can contain these values, so no existing record
changes meaning.

## D-043: Modularization is gated on a characterization layer that survives the move

Before any code moves out of `solar-logger.ino`, the monolith's current
behavior is frozen as tests, and every extraction stage must pass them before
its hardware check. One command runs the whole gate:

```text
tools/check.sh
```

It runs pytest, pyright, `py_compile`, a warning-free ESP32 compile, `bash -n`
on every script, and `git diff --check`, runs every step even after one fails,
and builds its summary from each step's real exit status.

Four rules came with it:

- **Source-level tests read the whole sketch, as tokens.** The firmware cannot
  run on the host yet, so policy, dispatch, accounting and record-layout rules
  are checked by reading the source. `tests/firmware_source.py` reads every file
  Arduino compiles and compares C++ tokens with comments removed. A test pinned
  to `solar-logger.ino`, or to whitespace, would fail on the very file move it
  exists to check. Verified on 2026-09-18 by moving five functions into a `.cpp`
  and reformatting every brace: the suite stayed green.
- **They prove shape, not behavior.** A source test shows the refusal comes
  before any state change; it does not show the board refusing. Hardware
  acceptance still covers behavior, and each extraction stage keeps its
  hardware check in [BACKLOG.md](BACKLOG.md).
- **No helper was extracted to make policy testable.** Extracting a helper is
  the first step of modularization, which this gate exists to precede.
  Behavioral tests of compiled firmware logic arrive with the modules.
- **A defect the gate finds is recorded as a strict `xfail`, never as expected
  behavior.** The test states the required property without choosing the fix.
  If a change makes it pass, strict mode fails the suite, so the marker comes
  off in the commit that fixes it. Freezing the defect as "current behavior"
  would make a correct fix look like a regression.

The compile uses `--clean`. Without it arduino-cli reuses cached objects for
unchanged source and prints nothing for them, so a warning fails the gate once
and then passes silently. Observed while building the script.

**Amended by D-046 on 2026-09-18:** three pure timing functions were extracted
inside `solar-logger.ino`, because the scheduler stint's brief asked for the
smallest pure helper that made the defect testable. They are compiled and run
on the host. No module boundary exists yet, and the "no helper" rule still
holds for policy code.

## D-044: RELEASE reports completion, and a pending autonomous sleep is exclusive

The characterization gate found that `LOGGER SESSION RELEASE` answered `OK`
whenever a session had been held, even when the handoff back to autonomous
sleep failed and the board stayed awake. That broke D-041. It also found that a
HOLD arriving inside the 250 ms deferred-sleep grace was granted and then slept
on.

**RELEASE completed** means all of this, and `OK` means nothing else:

1. a session was held, and it has been ended: lease dropped, USB transport
   released
2. if autonomous mode is armed, the accounting handoff was **prepared**: the
   open tethered interval closed, autonomous session state valid (rebuilt from
   the log if needed), and the next interval's baseline set
3. and the deferred sleep is **armed**, with its bounded grace (D-035)

Entering deep sleep is **not** part of it. That happens after the result, which
is the whole reason it is deferred. A host's only evidence that it happened is
the port disappearing, and a vanished port proves nothing on its own. If the
wake timer then fails to arm, the result has already been sent; the firmware
says so on the console, and the port does not disappear.

| Outcome | Answer |
| --- | --- |
| no session held | `NOT_HELD` |
| steps 1-3 done, or step 1 with autonomous mode off | `OK` |
| step 1 done, handoff not prepared | `ERROR` |

On `ERROR` the session is still over, but the board stays awake for diagnosis
with autonomous mode armed. The console names the failed stage: "closing the
open tethered interval" or "rebuilding autonomous state - storage unavailable".
Lease expiry uses the same handoff and names the stage too; it has no command,
so it answers nothing.

**A pending deferred sleep is exclusive.** `pendingAutonomousSleep` has three
writers and no others:

- `armPendingAutonomousSleep()`, used by RELEASE after a prepared handoff and by
  `LOGGER AUTONOMOUS ON` after arming
- `cancelPendingAutonomousSleep()`, used by an explicit stop and when
  autonomous mode turns out to be off
- `servicePendingAutonomousSleep()`, which enters the sleep once the grace
  expires

Arming sets `DEEP_SLEEP_PENDING`, so `autonomousOwnsBoard()` holds for the whole
grace, and tethered accounting, `POWER TEST STOP` and `RESET YES` all stand
down. RELEASE was already in that state. `LOGGER AUTONOMOUS ON` was not, which
left a 250 ms window in which a tethered interval could close over accumulators
the autonomous interval had just reset. It now enters the same state.

**HOLD during the grace is refused with `ERROR`.** `REFUSED` keeps its one
meaning, autonomous mode is off and no lease is needed, so a host does not
wrongly conclude the board is unarmed. Canceling the sleep and granting the
lease was the preferred option and was rejected. By the time the grace starts,
the RELEASE handoff has closed the tethered interval, reset the accumulators,
moved the retained session clock to the new autonomous boundary, and possibly
rebuilt RTC state and consumed a `boot_id`. Taking the board back would need all
of that undone. It would also run a second handoff in the same boot through the
scheduler defect recorded in [BACKLOG.md](BACKLOG.md) on 2026-09-18, which
double-counts awake time. A host that is refused claims the next rendezvous.

**An explicit stop cancels a pending sleep before its NVS write.** Before, the
grace only ended when the armed flag was clear, so a `LOGGER AUTONOMOUS OFF`
whose write failed let the board sleep anyway after the operator had asked for
a stop. That is D-021's failure reached through the deferred path. Arming now
also resets the tethered interval clock with the accumulators, so a canceled
arm resumes ordinary accounting from the real reset.

**Identity.** Version 0.3.0-dev: RELEASE now reports differently on a failure,
and HOLD behaves differently during the grace, which the version policy makes a
MINOR bump. The build ID stays `solar-logger-protocol-ack-v3`. The vocabulary
and its meaning are unchanged, since `ERROR` already meant "parsed, not
completed". No host needs to tell the two images apart to read a result
correctly, and no v3 image has run on hardware. This is a judgment call on the
build ID policy's wording, recorded so it is not silent.

## D-045: The machine RESULT is the host's only authority, and a missing ACK is never silent

Three rules for every host path: `tools/send.sh` through `SerialDevice`, and
`app/solar_logger.py` through `SessionClient`.

**The machine RESULT decides the outcome.** The firmware prints its human
outcome line (`[SESSION] Released: ALL OK`, `Host session held: ALL OK`, the
keepalive line) *before* its `CMD_RESULT`. In `SessionClient` that human line
used to clear the expected outcome, so the machine RESULT arriving after it was
ignored and the human line decided everything. The logger's shutdown then
printed `Board released: ALL OK` whenever the session stopped being held: after
a `NOT_HELD` answer, after a lease-expiry line, or after the human line alone.
Human lines are now display plus a session-state fallback for a dropped machine
line. They no longer consume the expectation, and no success is reported from
them.

The logger's release goes through `release_session()` in
`app/device_session.py`:

| What arrived | Reported |
| --- | --- |
| `CMD_RESULT,...,OK` with its ACK | `Board released: ALL OK` |
| `CMD_RESULT,...,OK` without its ACK | released, and "CMD_ACK was NOT observed" |
| `ERROR` | `NOT ALL OK`: session over, board stayed awake, stage in the firmware output |
| `NOT_HELD` | `NOT ALL OK`: no session was held, nothing released |
| port lost, or no result before the timeout | `NOT ALL OK`: outcome UNKNOWN |

**A RESULT whose ACK was lost is accepted, provisionally, and always flagged.**
The firmware emits a RESULT only after parsing and dispatching, so a RESULT
implies the parse. An ACK can be dropped under HWCDC backpressure (D-036). So:

- `tools/send.sh` exits by the RESULT: 0 for `OK`, 1 otherwise. For `OK` it
  prints `Firmware completed command, but CMD_ACK was NOT observed` instead of
  `... ALL OK`, plus a warning. Treating it as a failure was rejected: a retry
  loop would then re-send a command that had completed, and a completed
  `RESET YES` sent twice starts two experiments.
- `SessionClient` accepts it for session state, logs a warning, and counts it
  in `results_without_ack`.

**An ACK arriving after an accepted result proves that result stale.** The
firmware writes a command's ACK before its RESULT down one FIFO, so no ACK ever
follows its own RESULT. If this command's ACK follows a result already taken
for it, that result was left over from an earlier send of the same command, for
example one interrupted mid-response. It is discarded with a warning and the
command's own result is awaited. Before this rule, requiring the ACK first made
that case safe by construction; the rule keeps it safe while accepting lost
ACKs.

**Session commands get no stricter rule, deliberately.** The ACK line carries no
more identity than the RESULT line: both hold the same command text and no
session identifier, so a missing ACK makes session identity no more ambiguous.
What protects identity is D-040 (KEEPALIVE and RELEASE never wait for a new
rendezvous) and the port binding: a `SessionClient` lives on one open port, and
a port does not survive a sleep. Binding commands to a session id is the
unbuilt BACKLOG item, not something the ACK could supply.

## D-046: The scheduler adds only the time since the retained clock was exact

Found by reading on 2026-09-18 and fixed the same day. Compiled and tested on
the host. **At the end of that stint:** not uploaded or hardware verified.
Subsequent hardware transcripts show the corrected RELEASE sleep remainder of
59,750 ms, including clean `d017f7d`; the 2026-09-23 LAB_NOTES addendum records
that limited confirmation. Explicit lease-expiry timing remains unrecorded.

**The defect.** Two RTC-retained values carry autonomous time across deep
sleep. `rtcAutoSessionElapsedMs` is the session time at one known instant.
`rtcAutoIntervalStartMs` is the session time of the current interval's
boundary. The scheduler computed "now" as the retained value plus the time
since `setup()` entry. That is right on a timer wake, because the previous
sleep set the value for this wake's `setup()` entry. It was wrong after a host
handoff. `beginAutonomousSleepFromHostSession()` had already moved the value to
the handoff's own "now", which includes the awake time, and the scheduler then
added the awake time again.

The consequences below were computed by running the firmware's own arithmetic
on the host with the defect restored. None of those defective outcomes was observed on the board. At the time of
this source investigation, LAB_NOTES recorded no upload of the 2026-09-16
change that routed handoffs through the retained clock.

- A RELEASE 28 s after the wake's `setup()` entry commanded 31,750 ms of sleep
  instead of 59,750 ms. The next record still claimed 60,150 ms, although only
  about 32.5 s had passed.
- The session clock ran ahead of the time that really passed by the session
  length, for the rest of that `boot_id`.
- At one cadence or more, the doubled time passed the deadline. The scheduler
  printed a false overrun warning, moved the boundary, and slept a full cadence.
- Lease expiry took the same path. So did a handoff on a cold boot, such as a
  claim in the maintenance window, because `millis()` is itself the time since
  boot: a release 45 s after `setup()` entry slept 14,750 ms.

**The rule.** Session time now is the retained value plus the local time since
the instant that value was exact. Nothing else is added.

| Path | The retained value is exact at | Now |
| --- | --- | --- |
| `AUTO_SLEEP_TIMER_WAKE` | this wake's `setup()` entry | retained + time since `setup()` entry |
| `AUTO_SLEEP_HOST_RELEASE` | the handoff | retained + time since the handoff |
| `COLD_BOOT`, `ARM_COMMAND`, `RTC_LOST` | nothing retained; the session began on this boot | `millis()` |

The handoff records its instant in `hostHandoffAtMs`. That value is plain RAM,
written only by the handoff, from the same `millis()` reading it used for the
session time.

**The design is unchanged.** D-034 still holds: RELEASE and lease expiry set a
new boundary at the handoff and sleep the rest of one cadence from it. After
RELEASE that is the cadence minus the 250 ms grace, and after lease expiry the
cadence minus the handoff's own few milliseconds of output. Both go through the
same handoff and then the scheduler with `AUTO_SLEEP_HOST_RELEASE`, so they
share the corrected path. An unclaimed wake computes exactly what it did
before: `rtcAutoSessionElapsedMs + awakeMs`. The overrun branch (D-032) is
unchanged: a full cadence, never an underflow.

**Two more defects in the same expression, fixed with it.**

- The handoff measured the time since `setup()` entry with `micros()`. That is a
  32-bit count on this target (`__SIZEOF_LONG__` is 4, checked against the
  toolchain), so it wraps every 4,294.967 s, about 71.6 minutes. The logger's
  ordinary workflow holds a session for hours, and each wrap dropped
  4,294,967 ms from `session_elapsed_ms` for the rest of the boot. The handoff
  now uses `millis()`, which wraps after 49.7 days.
- Whether the handoff continues the retained clock was tested after the RTC
  rebuild had set the magic. On a timer wake whose RTC state was lost, that
  would have continued a clock the rebuild had just declared invalid, under a
  new `boot_id`. It is now decided before the rebuild. This was the BACKLOG item
  "`rtcAutoMagic` is set before the expression that tests it". No reachable case
  was known.

**Pure helpers, executed on the host.** The timing arithmetic is now three
pure functions inside `solar-logger.ino`: `autonomousHandoffElapsedMs()`,
`autonomousElapsedAtSleepMs()` and `planAutonomousSleep()`, with an
`AutoSleepPlan` result. They use fixed-width types only, because `unsigned long`
is 64 bits on the host and 32 on the ESP32-C3. `tests/test_autonomous_schedule.py`
extracts their source from the sketch and compiles it with the host's `c++`
(`-std=c++20` to match the core, `-Wall -Wextra -Werror`), then runs it. These
are the first tests in the project that execute firmware code. The composition,
meaning which clock readings the scheduler and the handoff pass in and what they
store, is still pinned by source tests. D-043 is amended to record the
exception.

**Identity at the time of this stint.** The version stayed `0.3.0-dev`. HEAD then recorded `0.2.0-dev`, and
`0.3.0-dev` exists only in the uncommitted working tree and has never been
uploaded, so this change joins it rather than bumping again. The build ID is
unchanged, because the protocol is untouched.

**Residuals, unchanged and unmeasured.** A record's `interval_ms` is shorter
than the time that really passed by a few pieces, all of which predate this
change:

- the bootloader, which session time has never included
- on the first record after a handoff, the part of `setup()` before the wake
  cycle starts its clock. On consecutive unclaimed wakes that part cancels.
- on the first record after a handoff, the work `closeMeasurementInterval()`
  does after its accumulator reset: a diagnostic read, output and the NVS
  checkpoint. A handoff that rebuilds RTC state also scans the log first.

The firmware prints the first two ("micros() at setup entry", "Wake cycle
entered at"), so the next hardware run can size them.

A defect in the overrun branch was found in the same code and **not** fixed. It
is recorded in [BACKLOG.md](BACKLOG.md) and as a strict `xfail`.

## D-047: A module exports what code outside it uses, and each stage is audited as a move

Set by the first modularization stage, the INA228 driver, on 2026-09-18.
Compiled and host-tested; **not validated on hardware** when this was written.
A hardware smoke test of that image was reported later the same day, and is
recorded, as reported, in [LAB_NOTES.md](LAB_NOTES.md). The rules apply to
every later stage in [BACKLOG.md](BACKLOG.md).

**The header is the boundary.** A module's header declares only what code
outside the module uses at the time of the move. Everything else is private:
helper functions are `static`, and constants stay in the `.cpp`, where a
namespace-scope `constexpr` already has internal linkage. `ina228.h` exports 12
functions, `SensorReading`, and the 15 constants the sketch still reads. The
other 11 functions and 18 constants are private. Nothing new can reach past the
driver into its register helpers.

**Mechanics move, policy stays.** The driver exposes read, reset, configure and
shutdown primitives. When they run stays in `solar-logger.ino`: when the
accumulators are reset, which interval owns their charge, and when a baseline is
taken (D-020, D-026, D-028). A function that judges a reading for one caller
stays with that caller, even when every line of it is a register read.
`validateInaForWake()` is that case. It prints `[AUTO]` verdicts about the
interval, and the plan puts it in `auto_orchestrator`.

**State goes with its writers.** A variable moves into a module only if that
module writes it. `inaShutdownActive` stayed in the sketch, although the plan
put it in `ina228`. The power test sets and clears it, STATUS and the heartbeat
read it, and the driver does neither. Moving it would have needed an `extern`
global or a setter, and either one would have put power-test state inside the
driver.

**What the `.ino` supplied implicitly is written down.** A `.cpp` does not get
the `#include <Arduino.h>` that Arduino CLI prepends to the sketch, so it
includes what it uses. A precondition the sketch always happened to meet is
stated in the header. For the driver, that is starting `Wire` before the first
register access.

**Each stage is audited as a move, in tokens.** Comments are stripped, so code
is compared and prose is not:

- The sketch's tokens equal the previous sketch's with runs deleted and
  `#include` lines inserted, and nothing else.
- No token of the previous sketch is missing from the new files. Every added
  token is scaffolding: `#pragma once`, includes, `static`, declarations.
- Each moved function has an identical body and parameter list. Each moved
  constant has an identical definition.

The first stage ran this as a scratch script over the tokenizer in
`tests/firmware_source.py`. No reusable version is in the repository yet.

**A size change is explained, not accepted.** Moving code across a
translation-unit boundary changes inlining, because this build has no LTO. The
stage compares per-symbol sizes of the two images and names where the bytes
went. A change that cannot be explained stops the stage.

## D-048: Every project module is configured for the editor by discovery

Decided 2026-09-18, when the first module turned out to have no editor
configuration: Arduino CLI's database names the build copy of `ina228.cpp`, and
the tooling added an entry for the `.ino` only. **Adding a module must never
require an edit to the IntelliSense tooling or to any editor setting.** The
rule applies to every later stage and every later module.

- **Discovered from the real build, cross-checked against the sketch.** The
  project's translation units are the entries Arduino CLI's database has for
  copies under `<build>/sketch/`, mapped back to the files a person edits. A
  separate scan of the sketch root and `src/`, which is where Arduino CLI looks,
  must find no C or C++ source that Arduino CLI did not compile. Nothing names
  a module.
- **One entry per file, naming the real file.** Each editor entry replaces the
  entry for the copy, with every response file and `-iprefix` resolved (D-039).
  A deleted module's entry cannot survive: Arduino CLI drops it, and an entry
  for a project file that no longer exists is refused.
- **Proven before it is written.** Every entry must resolve `Arduino.h` and the
  four ESP-IDF headers from D-039, and every project file is compiled
  `-fsyntax-only` with exactly its entry's flags. Any failure leaves the
  previous database untouched.
- **Arduino CLI never writes the file the editor reads.** It builds into
  `build/intellisense/arduino-cli/`, and the editor reads
  `build/intellisense/compile_commands.json`. Until this decision they were one
  file, so the "previous configuration is still in place" message was false.
  That was observed in a scratch copy on 2026-09-18.
- **The gate regenerates it.** `tools/check.sh` runs `tools/intellisense.sh` as
  a step rather than only checking staleness. Regeneration measured 2.6 s warm
  and 12.5 s on a new build path, and a stale database is exactly the thing
  nobody remembers to fix.

Assembler (`.S`) gets no editor entry. cpptools offers no IntelliSense for it,
so the tool prints a NOTE when it finds one rather than skipping it silently.
The sketch has none.

This decision covers the database, which is verified by compiling it. What
cpptools then displays is observed in VS Code, and was not observed when this
was decided.

## D-049: The connection module holds transport claims and nothing else

Set by the second modularization stage on 2026-09-18. Compiled and host-tested
at extraction; the supplied `8776ba0` hardware transcript later confirmed USB
claim, session status, keepalive and release. Recorded in the 2026-09-23
LAB_NOTES addendum; this is not a lease-expiry or multi-transport test.

`connection.h` / `connection.cpp` answer one question: which transport has a
host claimed? They hold the transport bitmask, claim and release, and
`anyHostConnected()`, and they print the `[CONNECTION]` lines. They do not know
what a lease is, how long it lasts, whether the board may sleep, or when
autonomous mode resumes. Session and autonomous code call down into the module,
and it calls nothing above it (D-025, D-034).

- **The bitmask is private.** `activeTransports` is `static` in
  `connection.cpp`, and only `connectionClaim()` and `connectionRelease()`
  write it. Nothing reads it from outside, so there is no `extern`. Callers ask
  `anyHostConnected()`.
- **The header exports what is used (D-047).** That is `CONNECTION_USB`,
  `anyHostConnected()`, `printActiveTransports()`, `connectionClaim()` and
  `connectionRelease()`. `CONNECTION_NONE`, `CONNECTION_WIFI` and
  `CONNECTION_BLE` stay in `connection.cpp` until something outside it uses
  one. No query or accessor nothing calls was added.
- **Presence is not connection state.** `printUsbPresence()` and the
  rendezvous's `USB plugged` and `CDC connected` lines stayed in the sketch.
  They report electrical presence, which D-025 says is never a claim, and
  keeping them out of this module keeps that line visible. This departs from
  the BACKLOG module table, which gave `connection` the "USB presence
  diagnostics"; the stage table's "1 global, 5 functions" is what was built.
- **Lease state stays with the lease.** `hostSessionHeld`, the deadlines,
  `hostClaimedRendezvous` and the deferred sleep stay for `host_session`. The
  module does not write any of them, so by D-047 they could not move with it.

`tests/test_characterization_connection.py` compiles the module's real source
on the host and runs it, and pins the call sites: HOLD is the only claim, every
way out of a session releases USB, and `LOGGER AUTONOMOUS OFF` releases it only
when no session is held (D-031).

## D-050: The NVS module owns how a value is stored, never when it changes

Set by the third modularization stage on 2026-09-23, which is stage 1 of the
order in [BACKLOG.md](BACKLOG.md). Compiled and host-tested at extraction;
checkpoint restore and write were subsequently smoke-tested on hardware
revision `d017f7d`, preserving Experiment 3. See the 2026-09-23 LAB_NOTES
addendum for observations and untested failure paths.

`nvs_persistence.h` / `.cpp` hold the single `Preferences` object, the
`solarlog` namespace, every key name, `NVS_SCHEMA_VERSION`, and the typed reads
and writes. They decide nothing about arming, disarming, closing an interval,
starting an experiment, or reserving a sequence block. Those decisions stay in
`solar-logger.ino` and call down (D-047).

**The name says NVS, not "persistence".** This board has three durable stores
and they keep different promises: NVS survives power loss, RTC-retained memory
survives deep sleep only, and the LittleFS log is the durable record history.
Only the first one moved, and the other two are later stages. A module called
`persistence` that owned one third of it would be the kind of quietly wrong name
this project treats as a defect rather than a cosmetic issue.

**A split is the right answer when one function held both.** Two did, and each
was cut at the line between the store and the decision:

- `loadAutonomousSettings()` read two keys and then checked the cadence against
  `AUTO_INTERVAL_SECONDS_MIN` and `_MAX`. The read is now
  `loadAutonomousConfig()`; the range check stayed with the constants, which are
  the cadence authority (D-018) and are also tested by the `LOGGER INTERVAL`
  handler. A persistence module does not get to decide which stored cadence is
  acceptable.
- `reserveSequenceBlock()` computed a new high-water mark, wrote it, and then
  advanced the RTC mirror. The write is now `saveSequenceHighWater()`.
  `AUTO_SEQ_BLOCK` and `rtcAutoSeqHighWater` stayed, and so did every part of
  D-023: which of the durable log tail and the NVS reservation is authoritative
  is not a question this module can see.

**The mirror still moves only after the write succeeds.** A reservation that was
not persisted must not raise the floor that makes a duplicate sequence number
impossible. That ordering survived the split and is pinned by a test.

**A hidden dependency becomes a parameter, not an `extern`.** Five functions
wrote sketch globals - the four experiment values and the three power-test
flags. They take an out parameter or a `LoggerCheckpoint` now. No global was
exported, and the experiment state itself did not move: it belongs to the
`experiment` stage, which owns when those values change.

`LoggerCheckpoint` is a plain struct of the four values, and deliberately does
**not** carry the schema. The schema belongs to the stored format, and only this
module may choose it.

**Failure keeps reaching the caller.** Every function that can fail returns
whether it did, the console keeps the same wording, and `saveCheckpoint()` still
attempts every key so that one failure does not hide the others. Two known
defects were **preserved rather than fixed**, because a behavior change must not
ride along inside a move: `loadAutonomousConfig()` reports success after a
failed open, and `loadSequenceHighWater()` returns 0 where a read failed. Both
are in [BACKLOG.md](BACKLOG.md), and both are now stated in the header where a
caller will see them.

**One semantic difference was found by the audit and guarded at compile time.**
The old early return on a failed open skipped the range check; it now returns to
the caller, which runs the check on the default. The two agree only while the
default cadence is in range, so a `static_assert` in the sketch fails the build
if it ever stops being. Everything else in the stage recomposes token for token
against `HEAD`.

## D-051: Telemetry owns how a line is spelled, never when it is emitted

Set by the fourth modularization stage on 2026-09-23, which is stage 5 of the
order in [BACKLOG.md](BACKLOG.md). Compiled and host-tested; telemetry has now
run in the smoke-validated `eba3b5d` image (2026-09-24). The supplied evidence
does not assert an exhaustive comparison of all CSV forms; see the LAB_NOTES
hardware addendum.

`telemetry.h` / `.cpp` hold the machine-readable CSV lines: `CSV_HEADER`,
`CSV_SAMPLE`, `CSV_DATA`, and the three `CSV_EVENT` shapes. They own the prefix,
the fields, their order, their precision, and the commas between them. They
decide nothing about what happened, when a line should be emitted, or which
values belong to it. Those stay in `solar-logger.ino` and call down (D-047).

The module does not know that an interval lasts sixty seconds, that a sample is
taken once a second, that a deep-sleep test suspends the sample row, or that an
experiment can be reset. It is handed finished numbers and prints them.

**The wire format is a contract, so it is pinned as bytes.** `app/solar_logger.py`
parses these lines by position and refuses a row whose field count is wrong.
`tests/test_characterization_telemetry.py` compiles the module's real source on
the host against a recording `Serial`, runs it, and asserts the exact lines —
then feeds those same lines to the host's own parsers. The golden strings were
captured from the monolith **before** the move and did not change during it.
That is the difference between a test that freezes behavior and one that
restates the new code.

**The module holds no mutable state, and that was measured rather than claimed.**
Everything printed arrives as a parameter. Global variables are unchanged at
36,332 bytes across the move, which is what "owns no state" looks like in the
link map.

**A hidden global becomes a parameter, as in D-050.** Four sketch globals were
read straight out of the sketch by the code that printed them: `printCsvRow()`
took `experimentId`, `runningCharge_mAh` and `runningEnergy_mWh`; all three
event printers took `experimentId`, and `printExperimentResumeEvent()` also took
`completedInterval`. Every one of them is passed in now. No global was exported,
and no `extern` was added.

**The row structs repeat the measurement fields instead of taking a
`SensorReading`.** Doing otherwise would make telemetry depend on the INA228
driver for four doubles it only prints, and the module table in
[BACKLOG.md](BACKLOG.md) puts `telemetry` on Arduino alone. `TelemetrySample`
and `TelemetryInterval` list their members in wire order, so the line and the
type that describes it cannot drift apart. Thirteen positional arguments, seven
of them `double`, was the alternative: a caller could transpose two and nothing
would say so.

**Three event functions rather than one `TelemetryEvent`.** The three lines are
genuinely different shapes and the host depends on that: it splits an event into
a type, an experiment id, and a tail it keeps whole. `EXPERIMENT_START` has no
tail, which is why the host's minimum is three fields. One struct with an
optional detail would have had to invent a way to say "no tail". This is the
case the brief for the stage called out: a broad abstraction is not an
improvement when the current arguments are simpler.

**`CSV_HEADER` moved with `CSV_DATA`,** because the header names the data row's
fields and the two are one fact. The blank line and the human-readable
`[CSV] Machine-readable interval logging enabled.` that have always preceded it
moved with it, so the emission at both call sites is unchanged byte for byte.

**`printLiveSample()` was split rather than moved,** the same cut D-050 made
twice. The suppression rule for the deep-sleep test (D-012), the `readSensor()`
call, and the derivation of `elapsed_seconds` from `completedInterval` and
`millis()` are all measurement policy and stayed in the sketch. Only the row
construction moved.

**The command protocol is not telemetry, and the boundary is now two files
rather than a convention.** `CMD_ACK` and `CMD_RESULT` go through the bounded
protocol writer with its own 100 ms deadline (D-036) and stay in
`solar-logger.ino`. Telemetry uses ordinary `Serial` output, which under
`Serial.setTxTimeoutMs(0)` is dropped rather than waited on when nothing is
draining the port (D-027). The two have different delivery guarantees on
purpose, and neither may acquire the other's. Nothing about either was changed
by this stage.

**Precision literals were left inline.** Naming them would have been a
readability change riding inside a move, and it would have broken the
token-for-token recomposition the audit depends on. The per-field precisions are
explained in a comment in `telemetry.cpp` and pinned by a test.

## D-052: V1 uses under-hood electrical points and a cabin enclosure; trunk topology remains open

Settled installation scope, 2026-09-23. **Planned, not installed or hardware
validated.** For the user's 2017 BMW M240i / F22, the first installed version
connects the solar/logger electrical path at the designated under-hood
charging/jump points. The logger itself initially lives in the glove box/cabin,
with wiring routed from the engine bay into the cabin.

V1 requires no IBS/LIN tap and adds no separate ignition/switched-12V wire
merely to detect vehicle-on. When IBS integration is undertaken, the logger is
expected to move to the trunk near the battery/IBS wiring. Vehicle-on/off might
then come from IBS/LIN or another signal discovered during that work; a
separate switched wire is not assumed. A convenient cabin IBS/LIN tap is not
established.

**Enclosure location is not electrical topology.** Moving to the trunk does not
settle where power, solar and measurement connections attach. Whether a
trunk-side connection can preserve the required BMW sensing/energy-management
path is an open research question, including potentially different positive
and negative connection rules. BACKLOG owns that research. Until authoritative
F22-specific evidence resolves it: V1 uses under-hood points; future trunk
wiring topology remains OPEN.

## D-053: BLE connects the logger to a phone that owns sync, clock and server bridging

Settled architecture direction, 2026-09-23; **not an implemented BLE/sync stack**.
BLE is the intended installed wireless transport. The car need never be near
home Wi-Fi. Wi-Fi and NTP are optional later capabilities, not prerequisites for
logging correctness, time synchronization or getting records to the server.

- The ESP measures, stores, maintains record sequence, exposes
  records/status/settings, accepts storage ACKs and time/configuration, and
  sleeps reliably. This is the intended responsibility boundary; ACK and time
  sync are not implemented yet.
- The native iPhone app discovers/connects over BLE, requests unsynced records,
  saves them durably, and **ACKs only after durable phone save**. It supplies
  wall-clock time, displays/graphs/configures the logger, and uploads using the
  phone's normal Internet connection.
- The self-hosted server provides long-term storage, a web UI/historical access,
  analysis, inference and higher-level processing. Server integration will
  likely be built alongside the native iOS app.

The phone is the bridge. The ESP does not know about or depend on the home
inference/web server. A device ACK attests to phone durability, not server
receipt; phone-to-server delivery is a separate responsibility. Storage
reclamation and full-storage policy remain undecided and unimplemented.

The phone is the intended wall-clock source. BLE sync can provide epoch/time
mapping through the D-019 contract, without Wi-Fi/NTP. The exact BLE encoding
and mapping are still design work. Existing UNKNOWN-time / epoch-0 records are
valid historical records and are not rewritten. USB time-setting remains a
possible bench aid, not a dependency of the installed system.

## D-054: Manual SYNC is permanent; vehicle-on wake is a future extension

Settled wake-access requirement, 2026-09-23; **planned except for the existing
autonomous timer wake**. Keep these conceptual wake reasons distinct:

1. TIMER: periodic autonomous measure/store.
2. MANUAL SYNC BUTTON: physical wake followed by BLE advertising/phone access.
   This remains permanently available as a fallback and explicit user-access
   path, even after other wake sources exist.
3. FUTURE VEHICLE-ON WAKE: investigate with IBS integration. The electrical
   signal, detection rules and any additional wiring are not chosen.

The first BLE version may use reset/manual-button-initiated awake windows. It
must not depend on remotely waking a fully sleeping Wi-Fi/BLE radio; no
“wake on LAN” mechanism is assumed. Button wiring and awake-window timing need
implementation and validation.

Vehicle-active logging—remaining awake, a higher sample cadence, richer
charging/alternator telemetry and BLE availability, then returning to parked
sleep—is a future idea only. This decision chooses no cadence or detection/
vehicle-off rule.

## D-055: Record format, storage, sequence authority, retained state and policy are separate boundaries

Planning correction, 2026-09-23. **No module extraction is performed by this
decision.** The old `auto_state` proposal grouped unrelated responsibilities
and is superseded as an implementation plan. Distinguish:

- record layout/version, units, flags, validation and CRC;
- LittleFS mount/read/append/scan/truncate mechanics and error reporting;
- sequence authority/reservation policy, using explicit log-recovery facts and
  NVS results under D-023;
- RTC-retained autonomous state, its validity and lifetime;
- autonomous scheduling/state-machine policy, measurement/storage ordering and
  sleep/awake transitions;
- session leases and transport claims, retaining the existing separation of
  `connection` bookkeeping from session and sleep policy.

Storage mechanics must report recovery outcomes; it must not silently choose
sequence authority or redefine corruption/reclamation policy during a move.
Retained state does not own files, record encoding or the scheduler. Scheduling
uses these lower-level results without making them own autonomous policy.
The planned interface direction must be checked against the code when each
extraction is scoped; the old call-graph counts are historical, not a proof of
the revised design. Exact future filenames/APIs and later extraction order
remain to be decided. At this decision's 2026-09-23 date, record format was
unextracted; D-056 below records its subsequent extraction and hardware validation.
Its 72-byte/version-1 contract and Experiment 3 golden record remain unchanged.

**Superseded in part by D-056 on 2026-09-24:** the `record_format` extraction is
now BUILT and hardware-validated on clean `eba3b5d`. The remaining boundaries
still await extraction; D-057 settles the recovery behavior to preserve.

**Superseded further by D-058, later the same day:** the LittleFS
mount/read/append/scan/truncate mechanics are now BUILT as `storage`, software
tested and not yet hardware validated. The list's second bullet is therefore
done and its third is explicitly not: sequence authority stayed in the sketch,
where `autoStorageRecover()` consumes the storage module's scan rather than the
module choosing a sequence. Retained state, scheduling, sessions and the command
protocol still await their own extractions.

**Superseded further by D-062 on 2026-10-01:** the D-023 decision is now its own
module, `sequence_authority`, committed as `16a299d` and hardware validated on
2026-10-02. Reservation and its RTC mirror stayed in the sketch for the
retained-state stage.

**Superseded further by D-063 on 2026-10-02:** the retained-state definitions
are now their own module, `autonomous_retained_state`, committed as `1801098`
and hardware validated the same day. It owns the definitions and their lifetime,
including the reservation mirror's, and no writer. Reservation policy,
scheduling, sessions and the command protocol still await their own extractions.

## D-056: Record format owns what a record is, never when one is written

Set by the fifth modularization stage on 2026-09-24, the first of the boundaries
D-055 separated. Compiled, host-tested and **HARDWARE-VALIDATED on clean
`eba3b5d`**, as recorded in the 2026-09-24 hardware addendum in LAB_NOTES. Old
records decoded and new records through 5942 validated; final dump 4,531 records,
invalid 0. The original extraction gate was 387 passed, 1 xfailed; the later
recovery gate is 429 passed, 1 xfailed.

`record_format.h` / `record_format.cpp` hold the deployed version-1 durable
record: the packed 72-byte `AutoRecord`, `AUTO_RECORD_MAGIC`,
`AUTO_RECORD_VERSION`, `AUTO_RECORD_SIZE`, the eight flag bit values, the
`AUTO_EXPERIMENT_UNKNOWN` and snapshot-unread sentinels, and `autoRecordCrc()`,
`autoRecordValid()` and `autoRecordSnapshotUnread()`. They answer WHAT a durable
record is and HOW its structural validity is checked, and nothing else.

**A bit's value is intrinsic; setting it is policy.** `AUTO_FLAG_INA_ACCUM_OF` is
`0x40` because every stored record says so, and that fact belongs in the module.
Whether a given record carries it is decided by the wake cycle, which reads
`DIAG_ALRT` and judges the interval. Every `flags |=` stayed in
`solar-logger.ino`, as did the time-quality state, and a test asserts the module
contains no `flags |=` at all. This is the line D-055 drew, applied.

**Nothing else followed the format in.** LittleFS mount, append, scan,
truncation and tail recovery; the `RTC_DATA_ATTR` retained state; sequence
reservation and the NVS high-water mark; the autonomous scheduler; host session
logic — all unchanged and still in the sketch at the time of this decision. The
LittleFS half of that list moved into `storage` later the same day under D-058,
which changed none of it; the rest is still in the sketch. The module names no `LittleFS`,
`Preferences`, `Serial`, `RTC_DATA_ATTR`, `millis` or log path, and a test
asserts each absence rather than trusting the review.

**`printAutoRecord()` deliberately did not move.** It interleaves flag
interpretation with `Serial` formatting and comma bookkeeping for the
`LOGGER STORAGE DUMP` transcript, which is an output format rather than the
record format. Moving it would have turned a structural extraction into a
formatting rewrite. It reads the moved constants through the header, which makes
it the one consumer that would notice a renumbered bit — so it is now pinned
against the real transcript line the board printed for `seq=4445`, which it had
no test at all before.

**The layout is a deployed binary contract, and the compile-time guard was
strengthened rather than moved.** `sizeof(AutoRecord) == 72` cannot see two
same-width fields swap places, a signed field turn unsigned, or a widened field
paid for by a narrowed neighbor; all three keep the size at 72 and all three make
Experiment 3's log unreadable. The header now asserts every field's `offsetof`,
width and signedness, and that `crc32` is last so the sealed range really is
bytes 0–67. Both additions were verified by construction: flipping
`avg_current_uA` to unsigned fails 3 assertions and swapping `boot_id` with
`session_elapsed_ms` fails 6, where the size assertion alone caught neither.

**Record version stays 1.** Moving code between files is not a semantic change.
No migration was written, no byte changed, and the firmware version and build ID
are unchanged.

**The module's real source is compiled and run on the host.**
`tests/test_characterization_record.py` compiles `record_format.cpp` itself, not
an extracted copy, and runs it against the deployed `seq=4445` record. One
substitution is unavoidable: `esp_rom_crc32_le()` lives in the ESP32 mask ROM.
It is supplied by the harness and asserted equal to the CRC the board actually
stored, so it cannot decay into a test of itself. The substitution leaves the
struct's layout on a real compiler, the covered range, the CRC offset, the magic
and version checks and every byte of the transcript line all genuinely executed.

**The move was audited as a mechanical one (D-047).** Deleting 132 lines from
`HEAD`'s sketch and inserting one `#include` reproduces the new sketch token for
token; all 292 tokens that left it are present in the two new files; and the
three moved definitions, the struct's members and its packed head are
token-identical to `HEAD`. One comment was edited, and is stated rather than
hidden by the token audit that cannot see comments: the note beside
`AutoLogScan` said it was declared "next to the record", which the move made
false.

**Flash fell by 2 bytes, and the 2 bytes are accounted for.** Every symbol in
the image is identical in size except `autoRecordValid()`, at 94 bytes instead of
96, and its instruction sequence is unchanged. The single difference is the call
to `autoRecordCrc()`: an 84-byte backward jump that the linker encoded as a
4-byte `jal` in the old layout and a 2-byte compressed `c.jal` in the new one.
The distance is the same in both, so this is a GNU ld RISC-V relaxation outcome
following the new section placement, not a code change. Global variables are
unchanged at 36,332 bytes, which is what "owns no state" looks like in the link
map.

## D-057: Only tail damage is repaired automatically; mid-file damage is reported and preserved

Accepted 2026-09-24. Implemented and host-tested; **normal-path hardware-smoke
validated on `eba3b5d-dirty`**, a working-tree build based on clean `eba3b5d`.
The healthy Experiment 3 log remained intact through sequence 6061, with 4,650
records read and invalid 0. Tail repairs, mid-file refusal and read-error refusal
remain host/synthetic tested only; no live corruption was injected. See [LAB_NOTES.md](LAB_NOTES.md#2026-09-24-hardware-validation-addendum--clean-record-format-and-working-tree-recovery).

Recovery distinguishes four cases (the shape of damage does not prove its physical cause):

- a **torn tail** — whole records followed by 1 to 71 leftover bytes, which is a
  write that did not finish;
- an **invalid tail** — an unbroken run of complete records at the end that fail
  magic, version or CRC, which is a write that landed wrong;
- **mid-file damage** — a bad record with valid records after it, which is not a
  trailing-write failure;
- a **read error** — the file cannot be read to its reported end, so the unread
  remainder is unknown and must not be discarded.

**Extended 2026-09-29: a scan that never happened must not be representable as
a scan that found nothing.** Fixed, committed as `44d8b27` and **hardware
validated on 2026-10-01**. A log that exists and will not open reported an error
and returned a zero-initialized scan with `readError` false, so its zeros were
read as measurements: boot recovery announced "Log tail is intact: ALL OK" and
`LOGGER STORAGE INFO` printed `Tail status: INTACT` and answered `OK`, for a log
not one byte of which had been read. The fourth case above now covers it.
`AutoLogScan.openFailed` marks it and `readError` is set with it, because
`readError` is what the refusals are keyed on and the case has to reach them;
`openFailed` carries what `readError` cannot, which is that a short read has
real partial counts and a failed open has none. Those counts are reported as
UNKNOWN rather than printed as zero, and INFO answers `ERROR` because the
command did not do what was asked (D-041). D-023 authority is unchanged: it
already required valid records, so an unopened log never was the authority.

The measured reason the refusal in `autoStorageTruncateToValid()` had to be the
thing that covered this, rather than its caller: driven directly against an
unopened log it printed "Rewriting the log to its valid prefix: 0 of 0 bytes"
and went ahead, and only its own source open failing stopped it. Had that fault
cleared in between it would have copied `keepBytes`, zero, into the temporary
file, removed the log and renamed the empty file over it. `autoStorageScanAndRepair()`
cannot reach that branch for an unopened log, which is exactly the argument
D-058 made for keeping the refusal compiled in the function rather than
inferring it from the call site.

Still unresolved on this outcome, and deliberately not changed inside a
diagnostic fix: `autoStorageRecover()` reseeds the RTC-retained running totals
from a scan that read nothing, so they silently restart at zero. Recorded in
[BACKLOG.md](BACKLOG.md).

For tail-only damage recognized on the 72-byte record grid, the trailing bad
run and partial remainder are discarded automatically. This does not solve
byte-misaligned mid-file damage; the limitation below remains open.

The third is different in kind, and the implementation used to treat it as the
same thing: `autoStorageScan()` stopped at the first record that failed
validation, called everything past it trailing, and `autoStorageRecover()`
rewrote the log to that prefix at boot. Measured on the host harness, a
four-record log damaged in its second slot went in at 288 bytes and came out at
72. The loss was counted and printed, so it was not silent — but it was
automatic, irreversible, and it happened before any human read the message.

**The rule.** When a valid record lies after an invalid one, the extent of the
damage is not known, and nothing is deleted. The firmware reports how many good
records are stranded, states plainly that nothing was discarded, and leaves the
log alone. The same applies when the log cannot be read to the end: an I/O fault
is not a torn tail. Repairing mid-file damage is an operator decision, and there
is deliberately no command for it yet — `LOGGER STORAGE CLEAR YES` erases
everything, which is not the same thing, and adding a repair command changes the
command protocol.

Detected mid-file corruption is retained until an operator can address it. `LOGGER STORAGE DUMP` already decodes every
record and names the invalid ones, so a host is never handed a corrupt record as
if it were good, and appending continues normally.

The check lives in `autoStorageTruncateToValid()` as well as in its caller,
because that function is the only code in the firmware that deletes stored
records. No amount of accurate reporting makes a deletion recoverable afterwards,
so the decision is enforced where the damage would be done rather than only
where it is decided.

**Sequence authority follows D-023.** `logIntact` now includes `!readError`.
Any invalid record anywhere also means the log is not provably intact, so the
NVS reservation floor still applies in either case. One thing improved: the log's own candidate is now one past the last
valid record in the whole file rather than the last one before the damage. The
old code returned 11 for the example above while deleting records 12 and 13;
preserving them and still issuing 11 would be the duplicate D-018 forbids.

**Not resolved.** Damage that is not a whole number of records throws every
later record out of frame, so nothing after it validates, no valid suffix is
detectable, and it is discarded as a torn tail. Recovering that needs an explicit
resynchronization policy, which is a design decision and not part of a
correctness fix. Recorded in [BACKLOG.md](BACKLOG.md).

The firmware's own scan and recovery functions are compiled and run against
synthetic damaged logs in `tests/test_characterization_storage_recovery.py`. Those synthetic tests never use the live Experiment 3 log. The separate
hardware smoke used only its healthy normal path; physical read-error testing
remains open.

## D-058: Storage owns the filesystem, never which sequence a record gets

**Fresh healthy-log storage hardware smoke passed, 2026-09-29, on clean
1980d94** (`0.3.0-dev`, `solar-logger-protocol-ack-v3`). Experiment 3 retained;
full pre/post dumps preserve all 10,659 preflight record lines exactly, and
post-upload boot 36 adds 3 records, 12073–12075. Final dump: 10,664 records,
1412–12075, board invalid 0; observed INFO scans have trailing 0 and INTACT tails
with no storage errors. [Raw evidence, checksums and limits](../logs/evidence/2026-09-29/storage-hardware/README.md).
Damaged-log branches remain host/synthetic tested only. No standalone reset,
storage clear, whole-flash erase or corruption injection was performed.

The following paragraphs retain the extraction-time software evidence.

Set by the sixth modularization stage on 2026-09-24, the second of the
boundaries D-055 separated. Compiled, host-tested and **NOT hardware validated**
at this writing: nothing was uploaded. The gate went from 429 passed / 1 xfailed
to 462 passed / 1 xfailed, the 33 new tests being the storage module boundary
and the re-homed harness.

`storage.h` / `storage.cpp` hold the durable-log mechanics: `AUTO_LOG_PATH`
(`/auto.bin`) and `AUTO_LOG_TMP_PATH` (`/auto.tmp`), the `autoStorageMounted`
flag, the three append sub-timings, `autoStorageMount()`,
`autoStorageFormat()`, `autoStorageScan()`, `autoStorageTruncateToValid()`,
`autoStorageScanAndRepair()`, `autoStorageAppend()`,
`autoStorageLogExists()`, `autoStorageOpenLogForRead()`,
`autoStorageLastAppendTiming()`, `autoStorageTotalBytes()` and
`autoStorageUsedBytes()`, plus `struct AutoLogScan` and `struct
AutoAppendTiming`. No file outside the module names `LittleFS` or either path,
and a test asserts that rather than trusting the review.

**The sequence decision did not follow the filesystem in.** `autoStorageRecover()`
was split at the seam D-055 draws. The file half — scan, report every damage
case by name, repair only a tail — is `autoStorageScanAndRepair()` in the
module, and it returns the scan. The sequence half keeps the name
`autoStorageRecover()` and stays in `solar-logger.ino`, because it reads the NVS
high-water mark, applies the D-023 reconciliation of an intact log tail against
the reservation floor, and reseeds `rtcAutoRunChargeUAh` and
`rtcAutoRunEnergyUWh`. Rejoining the two halves reproduces the pre-move function
token for token.

**D-057 is unchanged, and one linkage decision exists to keep it that way.**
`autoStorageTruncateToValid()` is declared in the header although
`autoStorageScanAndRepair()` is its only caller, which departs from D-047's
"export only what is used outside". The reason is measured. Given `static` and
that single call site, GCC inlined it, proved from the caller's `else if` chain
that `validAfterInvalidRecords > 0 || readError` could not hold there, and
deleted the refusal and its message from the image: the firmware stopped
containing a check the source says it contains. Comparing the two images'
message strings is what found it, not review. The refusal is a property of the
function under D-057, so it keeps external linkage, and
`test_the_rewrite_keeps_external_linkage_so_its_refusal_is_compiled` pins the
reason next to the code.

**Four commands deliberately stayed in the sketch.** `printStorageInfo()`,
`dumpStorage()`, `clearStorage()` and `printAutoRecord()` each mix
operator-facing formatting, or the autonomous test's own state, with the file
access they need: INFO projects capacity from `autonomousIntervalSeconds`, DUMP
formats every record through `printAutoRecord()`, and CLEAR refuses while the
test is armed and zeroes the RTC totals afterwards. Moving any of them would
have carried scheduler or presentation concerns into the module, so only the
file access moved, as `autoStorageTotalBytes()`, `autoStorageUsedBytes()`,
`autoStorageLogExists()`, `autoStorageOpenLogForRead()` and
`autoStorageFormat()`. Six filesystem-space call sites collapsed onto two
accessors; that is the only place where a token left the sketch without
reappearing in the module.

**State went with its writer, and the header exports none of it.** The three
append sub-timings were globals the sketch read and only the append wrote, so
they are now `static` in `storage.cpp` and the wake cycle reads them through
`autoStorageLastAppendTiming()`. `autoStorageMounted` is private outright.
`storage.h` declares no `extern`.

**No format, protocol or version changed.** Record version stays 1, the firmware
version stays `0.3.0-dev` and the build ID stays
`solar-logger-protocol-ack-v3`. Storage-full policy, `SYNC FROM`, storage ACKs
and reclamation remain unimplemented; none was invented to fill a gap in the
new module, and the unresolved non-record-sized resynchronization case in D-057
is unchanged.

**The move was audited as a mechanical one (D-047).** 1,585 tokens left the
sketch and 30 entered it, every one of the 30 being the new module's API names,
the `#include`, and one local for the timing struct. The four definitions moved
whole — `autoStorageMount()`, `autoStorageScan()`,
`autoStorageTruncateToValid()`, `autoStorageAppend()` — and `struct AutoLogScan`
are token-identical to `HEAD`, and all four compile to identical RISC-V
instruction sequences in the linked image. One comment was edited and is stated
rather than hidden by a token audit that cannot see comments: the note beside
`AutoLogScan` explained why it was declared early in the sketch, which the move
made false.

**Flash rose 318 bytes and every byte is accounted for.** `.flash.text` grew
134 bytes across 23 named symbols, the largest being the new
`autoStorageScanAndRepair()` at 610 against the 572 its body cost inside
`autoStorageRecover()`, and five previously-inlined filesystem calls becoming
real functions. `.eh_frame` grew 188 bytes for exactly 7 new FDEs, which is the
11 functions `storage.cpp` defines less the 4 that left the sketch.
`.flash.rodata` fell 4 bytes with all 4,053 of its text strings byte-identical
between the two images, so that is string-pool alignment and not a lost message.
Two symbols changed by 2 bytes each, `setup()` and the core's
`fs::LittleFSFS::begin()`, and both have identical instruction sequences: GNU ld
RISC-V relaxation following the new section placement, the same outcome recorded
in D-056. Global variables are unchanged at 36,332 bytes.

## D-059: A captured state and a timed transition are different evidence

Implemented 2026-09-28 in `tools/charger-transitions.py`, an offline
characterization tool, not firmware policy. Initial state and newly confirmed
state after missing capture cannot be presented as precisely observed edges.
Same-state observations on both sides of a gap do not establish continuity
inside it. The report names every segment boundary and resets both candidate
persistence and confirmed state across gaps, experiment changes and repeated or
backward host timestamps. It never sorts the evidence to conceal those breaks.

An `OBSERVED CONTIGUOUS TRANSITION` requires adjacent opposite-state runs,
each meeting the selected persistence criterion, within a single capture
segment. UNKNOWN/TRANSITION rows interrupt persistence. If an opposite state
confirms without that preceding evidence, report `STATE CHANGE WITH UNCERTAIN
EDGE`; do not invent a narrow transition bracket from stale confirmed state.
First supporting sample, confirmation time and host-sample bracket are distinct;
none is the exact physical controller switching instant.

Use **2 s inclusive maximum adjacent spacing** and **five classified samples**
as configurable, printed analysis defaults. The nominal sample period is 1 s;
the inspected September 28 CSV has median positive spacing 1.000138 s. Two
periods allow limited capture jitter, not proof of uninterrupted sensing.
Five samples do not necessarily span five seconds when serial receipt is bunched.
No new numeric production thresholds, smoothing, cause classifier or firmware
state inference is selected by this decision. Voltage/current thresholds remain
provisional and unchanged. Preserve offsets and file order; malformed input
fails explicitly, nonfinite sensor readings remain UNKNOWN, and empty or
unconfirmed captures say so.

The report includes capture endpoints and separate transition/state/gap counts,
with context clipped to a segment. Tests execute synthetic gaps, partial
persistence, same-state reacquisition, experiment/time-order boundaries,
ambiguous samples and contiguous ON/OFF edges. Full software gate: 486 passed,
1 existing xfailed, all steps green. No board command or upload was performed.

## D-060: Running totals are reseeded only from a log that was read to its end

Decided 2026-09-29 by the orchestrator; implemented, host-tested, reviewed and
committed as **`58a4e09`** the same day. **Not uploaded, not hardware
validated.** Evidence and gate scope: the newest [LAB_NOTES.md](LAB_NOTES.md)
entry.

`autoStorageRecover()` used to end by copying `scan.lastRunChargeUAh` and
`scan.lastRunEnergyUWh` into `rtcAutoRunChargeUAh` / `rtcAutoRunEnergyUWh`
unconditionally. After a failed open those fields are zero because nothing was
read. After a short read they hold whichever record the scan happened to reach
last, which is not provably the last one written. The retained totals took
either without a word, so the next record's `Qsum`/`Esum` continued from a
number nothing had established.

**The rule.** When `scan.openFailed || scan.readError`, the retained totals are
not assigned, and recovery prints that they could not be recovered, why, and
the exact values being carried instead. Both halves are required: refusing to
reseed without saying what is carried would trade one silent deviation for
another. Every other outcome reseeds exactly as before, including mid-file
damage and a repaired tail, where the whole file was read and the last valid
record is known.

**What "carried" means on each path.** All four call sites set `rtcAutoMagic`
immediately before recovery. `RTC_DATA_ATTR` places the totals in `.rtc.data`
(ESP32 core 3.3.11, `esp_attr.h`), and ESP-IDF's bootloader reloads RTC
segments from the image on every reset that is not a deep-sleep wake
(`should_load()` in `esp_image_format.c`). So after a power-on or other reset
the carried value is expected to be the initializer, zero, which D-011's
"undefined after power-on" states more conservatively than the bootloader is
believed to behave.

**The version behind that claim does not match the toolchain, and the gap is
not closed.** The `should_load()` source that was read is ESP-IDF **v5.4**. The
installed core 3.3.11 bundles **v5.5.5**, pinned on 2026-09-29 from
`~/Library/Arduino15/packages/esp32/tools/esp32c3-libs/3.3.11/include/esp_common/include/esp_idf_version.h`
(`ESP_IDF_VERSION_MAJOR 5`, `MINOR 5`, `PATCH 5`). Nobody has read v5.5.5's
`should_load()`; only headers and prebuilt libraries are installed locally, not
that source. Treat the zero-after-reset behavior as EXPECTED, not measured, on
the toolchain actually in use. It has never been observed on this board.

**This decision does not rest on that claim being right**, because the firmware
prints the carried value rather than asserting it was recovered. But the
related BACKLOG item on retained-state validity does bear on it: see "Recovery
cannot see whether the retained totals it carries were ever valid". After an in-session `LOGGER AUTONOMOUS OFF` (which sets the
magic to 0 and leaves the totals alone) followed by a re-arm, or on a timer wake
that finds the magic invalid, the carried value is whatever the previous
session left. The firmware cannot tell those apart inside `autoStorageRecover()`,
which is why it prints the value rather than characterizing it. The message
says the value was not checked against the log.

These are the test-local totals D-017 keeps separate from experiment state.
Stored records, the record format (version 1, 72 bytes), the CRC, D-023
sequence authority and the NVS reservation floor are unchanged. Software
failure injection in the host harness does not show what a physical LittleFS
read fault does.

**Superseded in part by D-061 (2026-10-01):** an unreadable log now carries the
retained totals only when the retained state was valid, and zeroes them
otherwise. The ESP-IDF expectation above no longer bears on any decision.

## D-061: Recovery carries the retained totals only when retained state was valid

Decided 2026-10-01 by the orchestrator; implemented and host-tested in the
working tree the same day. **Not committed, not uploaded, not hardware
validated.** Evidence and gate scope: the newest [LAB_NOTES.md](LAB_NOTES.md)
entry.

D-060 kept the retained running totals whenever the scan could not read the
log. Whether keeping them is right depends on whether they were valid, and
`rtcAutoMagic` is the firmware's own answer to that (D-011). Recovery could not
read it, because every call site sets the magic immediately before calling.

**The rule.** When `scan.openFailed || scan.readError`, recovery carries the
retained totals and says so if the retained state was valid **before the call
site set the magic**. Otherwise it sets them to zero and says so. Both halves
print, because a silent zero would trade one silent deviation for another. A
log that was read reseeds from its last record whatever the validity.

**The seam.** `autoStorageRecover(bool retainedStateValid)`. Each call site
captures `rtcAutoMagic == AUTO_RTC_MAGIC` into a local immediately before it
sets the magic, and passes that local. A parameter, rather than reordering the
assignment and reading the global inside recovery, makes every caller state the
fact and keeps the ordering in one visible line per site. A source test pins
capture, then set, then call, at all four sites.

**What it removes.** D-060's account of the carried value rested on the
bootloader reloading `.rtc.data` on every non-deep-sleep reset. That was read
from ESP-IDF v5.4 while the installed core bundles v5.5.5. The firmware now
asks its own guard instead, so that reading is not load-bearing. It is still
unverified for v5.5.5 and still has never been observed on this board.

**A consequence to know.** `LOGGER AUTONOMOUS OFF` clears the magic, so a
re-arm whose log cannot be read now starts the totals at zero. Under D-060 it
carried the previous session's values. The guard has declared those values
invalid, and this rule follows the guard.

Record format (version 1, 72 bytes), CRC, D-023 sequence authority and the NVS
floor are unchanged.

## D-062: Sequence authority decides the next sequence from facts it is handed

Set by the seventh modularization stage on 2026-10-01, the third of the
boundaries D-055 separated. The boundary was chosen by the user from the options
the CODE stage put to them. Committed as **`16a299d`** and **hardware validated
on 2026-10-02**.

**The decision has been observed on hardware making a choice that could have
gone wrong.** During the 2026-10-02 cadence change, `LOGGER AUTONOMOUS ON` ran
recovery with the port open and printed:

```text
[STORAGE] Next sequence from log: 16439, from NVS reservation: 16453, using: 16439
[STORAGE] Log tail is provably intact, so it is the authority and the NVS
          reservation floor was not applied.
```

The two inputs disagreed by 14. The module took the log, as D-023 requires for a
provably intact tail; applying the floor would have skipped to 16454 and burned
14 sequence numbers. The acceptance smoke earlier the same day could only show
that the sequence stayed contiguous across the upload's reset, which does not
reveal whether the floor was ever in contention. This does.

Arming prints the transcript because it runs recovery while tethered. The
cold-boot path runs the same code where no capture reaches it, which is why
`tools/check-totals-continuity.py` asserts the consequence at the reset boundary
rather than looking for these lines.

`sequence_authority.h` / `.cpp` hold one function,
`sequenceAuthorityNext(const AutoLogScan &scan, uint32_t reservedHighWater)`.
It is the D-023 reconciliation moved out of `autoStorageRecover()`: `logIntact`,
`fromLog`, `fromNvs` one past the reservation, the choice of `next`, and the
three `[STORAGE]` lines that say which one was used. It reads neither fact
itself. The scan comes from `storage`, and the reservation is passed by value.
The module names no NVS, LittleFS, `RTC_DATA_ATTR` or sketch global, calls
nothing but `Serial`, and declares no `extern`, so it adds no upward call and
not the project's first `extern`. A test pins each of those names out of it.

**`autoStorageRecover()` was split, not moved.** It did two jobs for two owners.
Sequence authority moved. Reseeding the RTC running totals (D-060, D-061) and
the `retainedStateValid` parameter belong to retained state and stayed, so all
four call sites and the test that pins "capture, then set, then call" are
unchanged. What remains in the sketch composes the stages: scan, read the
reservation into the mirror, decide, reseed.

**Reservation did not move, and that is a measured limit.**
`reserveSequenceBlock()` writes the RTC mirror `rtcAutoSeqHighWater` after the
NVS write succeeds, and `tests/test_characterization_nvs.py` pins that
assignment token for token. There were two ways to move it. The module could
own the mirror as a private `static RTC_DATA_ATTR`, which puts the first
retained variable in a module ahead of the stage that owns retained lifetime
(BACKLOG counts all ten `rtcAuto*` as retained state). Or it could take the
mirror by reference, which changes a characterization test. Each is a real
choice, and neither belonged inside a structural move. `AUTO_SEQ_BLOCK`,
`reserveSequenceBlock()`, `ensureSequenceReservation()`, the mirror and
`rtcAutoSeqHighWater = loadSequenceHighWater()` stay in the sketch until the
retained-state stage decides who owns the mirror. Calling
`ensureSequenceReservation()` after recovery stays the caller's job.

**Audited as a move (D-047).** The moved body matches the removed tokens except
for one rename: `rtcAutoSeqHighWater` became the parameter `reservedHighWater`
in `fromNvs`. `logIntact` and `fromLog` are now computed after
`loadSequenceHighWater()` instead of before it. Both are pure functions of the
local scan, and the load prints nothing, so the transcript order is unchanged.
Flash rose 78 bytes. Of that, 34 are `.flash.text`, which is the new function's
244 bytes less the 210 that left `autoStorageRecover()` (522 to 312); no other
symbol changed size. The other 44 are `.eh_frame`, which has exactly one new
FDE (6,356 to 6,357). The 1,757 human-readable rodata strings are identical
between the two images. Global variables are unchanged at 36,332 bytes.

**One existing test's title no longer described the code, and was corrected in
review.** `test_the_sequence_decision_stayed_in_the_sketch` still passed, because
its assertions are about the NVS read and the reseed, which did stay. But the
decision itself no longer lives in the sketch. The implementing stage left it
unedited as its brief required and reported it; the orchestrator then renamed it
to `test_recovery_composition_stayed_in_the_sketch` and rewrote its docstring.

**No assertion changed.** That distinction is the rule, not a technicality.
Editing what a characterization test ASSERTS so that a move passes destroys the
contract the move is supposed to be checked against. Correcting a test's NAME so
it stops misdescribing what it checks is required by the no-silent-deviation
rule, because a test whose title is false misleads every later reader who greps
for it. The same review corrected a comment in `storage.cpp` that attributed the
rewrite refusal to `autoStorageRecover()`; the refusal has always been
`autoStorageTruncateToValid()`'s own guard (D-057, D-058).

Record format (version 1, 72 bytes), CRC, D-023, D-057, D-060 and D-061
semantics, firmware identity and the command vocabulary are unchanged.

## D-063: Retained autonomous state owns one definition of each value, and no transition

Set by the eighth modularization stage on 2026-10-02, the fourth of the
boundaries D-055 separated. The boundary was chosen by the user from three
options the CODE stage put to them. Committed as **`1801098`** and **HARDWARE
VALIDATED 2026-10-02** on image `8faa0e3`. Evidence, criteria-before-result and
limits: [logs/evidence/2026-10-02/retained-state-1801098/](../logs/evidence/2026-10-02/retained-state-1801098/acceptance-result.md).

**Nine of the ten relocated variables are directly evidenced on hardware**, and
the sharpest is `rtcAutoCycleCount`: `FIRST_AFTER_BOOT` appears on exactly one
record out of six consecutive unclaimed wakes. That flag is set when the counter
reads 0, so a definition duplicated across translation units — the hazard this
module exists to make impossible — would have set it on every wake. One flag in
six is positive proof of a single retained definition surviving five deep
sleeps. `rtcAutoSeqHighWater` is evidenced in both directions: the reservation
floor was declined twice in favor of an intact log, and a new 64-block was later
persisted with the mirror advancing after the write succeeded.

**`rtcAutoCommandedSleepMs` is not directly evidenced, and cannot be by this
transport.** Its value is printed only in the wake report, emitted before the
rendezvous opens, when no USB device exists; `Serial.setTxTimeoutMs(0)` (D-027)
drops that output rather than buffering it. A host attaching at the rendezvous
is structurally too late, so neither `tools/send.sh` nor `app/solar_logger.py`
can receive the line. Its correctness is evidenced only indirectly, by the
commanded sleeps producing the right durations.

`autonomous_retained_state.h` / `.cpp` hold the ten `rtcAuto*` values and
`AUTO_RTC_MAGIC`. The `.cpp` holds the only definition of each, with
`RTC_DATA_ATTR` and its zero initializer. The header declares all ten `extern`
and defines the magic. The module defines no function.

**What it owns.** Exactly one definition per variable, in exactly one
translation unit. BACKLOG calls that the single highest-risk detail in the
whole modularization plan, and it was not testable while the definitions were
ordinary lines in the sketch. It is now pinned by a test. It is also the
precondition for every later stage: the scheduler extraction can include this
header instead of making the project's first upward reach into sketch globals.
A module with no behavior in it is justified by owning that invariant.

**What it does not own.** Any transition. Nine functions write these values,
and all of them stay in `solar-logger.ino`: the scheduler, arm and stop, the
host handoff, the wake cycle, `setup()`, boot recovery, `clearStorage()` and
`reserveSequenceBlock()`. Those are autonomous-scheduling, recovery and
reservation policy, and each has its own later stage. Power-test RTC state stays
out too: `rtcSleepTestMagic` and `rtcSleepTestCycle` are under their own magic
(D-011), and `stopAutonomousTest()` clearing `rtcAutoMagic` must never sit next
to them.

**Who owns `rtcAutoSeqHighWater`.** D-062 deferred this to this stage, and it is
answered here so the next stage inherits it. Retained state owns the mirror's
definition and lifetime: it is valid only under the magic, because every
recovery reloads it from NVS immediately after the magic is set. Reservation
policy owns its writes. `AUTO_SEQ_BLOCK`, `reserveSequenceBlock()` and
`ensureSequenceReservation()` stay in the sketch until a reservation stage.
That stage's module can include this header rather than needing an `extern` of
its own.

**The `extern` is a measured departure from D-047, and it is named.** The header
exports all ten because the sketch uses all ten, so D-047's "a header declares
only what code outside the module uses" is satisfied, not bent. D-047's other
rule, "a variable moves into a module only if that module writes it", is
broken, because this module writes none of them. This is the project's first
`extern`. D-049, D-058 and D-062 each avoided one, and the direction is what
separates their cases from this one:

- Those modules refused to reach **up** into the sketch's globals. Here the
  sketch reaches **down** into a module, the same direction as every function
  call it makes. No module gains an upward dependency.
- D-058 refused to export state a module **writes** when an accessor would do.
  An accessor would not do here. The invariants that matter are ordering rules
  across several variables at the call sites: capture the validity, then set
  the magic, then recover (D-061); set the magic only after the rest is valid;
  keep `session_elapsed_ms` monotonic within `boot_id` (D-033). A per-variable
  setter cannot enforce any of them. Accessors would also have rewritten 85
  references in 11 functions and ten pinned characterization tests, so the
  stage could not have been a move.

The cost is real. Anything that includes the header can now write retained
state. The compensating control is
`test_only_the_known_functions_write_retained_state`: one test that pins every
writer of all ten, counting assignment, compound assignment, increments and
taking the address. That follows D-058's precedent for
`autoStorageTruncateToValid()`, which kept external linkage against D-047 as a
stated, tested departure.

**That control is location-independent, and it was measured rather than
reasoned about.** It collects writers by function name across every file Arduino
compiles, so a later stage that relocates a writer under the same name does not
disturb it. Verified on 2026-10-02 by performing the move: in a scratch copy of
the sketch directory, `reserveSequenceBlock()` was cut out of
`solar-logger.ino` verbatim into a new `sequence_reservation.cpp` and the tree
re-read through `firmware_source`. The mirror's writer set stayed
`{autoStorageRecover, reserveSequenceBlock}` and the test passed. The same
experiment confirmed it still fails when a write genuinely changes hands: adding
a new writer reported the extra name, and renaming the writer reported the new
set. The orchestrator had asserted the opposite — that the reservation stage
would be forced to update this test — and the CODE stage's reading was correct.

The consequence for the reservation stage is in BACKLOG: **this test going red is
not available as evidence that that move happened**, so that stage needs its own
positive test, the way D-063's single-definition and `extern`-only-header tests
were its real red evidence.

**`AUTO_RTC_MAGIC` is in the header** because `printAutonomousStatus()` and the
four validity capture sites read it. A namespace-scope `constexpr` has internal
linkage, so each translation unit gets its own copy of a constant. That is
harmless, and it is not the hazard of a `static` variable in a header.

**Named for what it holds.** Every module name is a noun, and this one uses the
phrase D-055 and BACKLOG already use, "RTC-retained autonomous state". The
shorter `retained_state` was rejected for D-050's reason: power-test state is
retained too, and a module named for all of it that holds only part of it would
be a defect, not a cosmetic issue.

**Audited as a move (D-047).** The sketch is HEAD's sketch with one 66-token run
removed (the magic and the ten definitions) and one `#include` inserted, and
nothing else. The magic's definition is verbatim in the header, and the ten
definitions are verbatim and in order in the `.cpp`. Function bodies: zero
tokens changed. The linked image is identical. All ten allocated `PROGBITS`
sections keep their address and size, and across all of them **exactly four
bytes differ**: the core's compile-time stamp in its "Software Info" string
inside `.flash.rodata`. The two symbol tables are identical — sorted
`riscv32-esp-elf-nm -S` output diffs empty across all 9,927 entries, so every
symbol keeps its name, address, size and type. Flash stays 1,106,273 B, globals
stay 36,332 B, and no forward declaration was removed because none of the moved
items was a function.

**Compare ELFs, not `.bin` files, when auditing a move.** The two `.bin` images
differ in 69 bytes, not four, and the extra 65 are not code: esptool injects a
32-byte `app_elf_sha256` into the application descriptor and appends a 32-byte
image SHA-256 plus a checksum byte. Both are hashes *of* the ELF, so neither can
be in it, and both necessarily change when the build stamp does. A future audit
that diffs `.bin` files will see 69 bytes and should not go looking for 65 bytes
of code.

**RTC layout unchanged, and a reorder would not have mattered.** All twelve
project RTC symbols appear exactly once, in `.rtc.data`, at their old addresses
and sizes (`0x50000018`–`0x5000004F`, `rtcSleepTest*` last, the `int64_t` pair at
`…20` and `…28`). A reorder could not have created a new hazard. For stale RTC
memory to read as valid, the word at the magic's new address would have to
equal `0xA07011E5`, and the only word that ever holds it is the old magic. So a
false valid needs the new address to coincide with the old one, which is the
deployed layout. Any other reorder makes the magic read invalid, which is the
handled path D-061 relies on. The same holds for `rtcSleepTestMagic` under
D-011. Whether ESP-IDF v5.5.5's `should_load()` reloads `.rtc.data` on a
non-deep-sleep reset stays open (D-060). D-061 removed the firmware's dependence
on it, and this stage did not try to close it.

Record format (version 1, 72 bytes), CRC, D-023, D-057, D-060, D-061 and D-062
semantics, firmware identity and the command vocabulary are unchanged.

## Project practice

These documents are living engineering records. Record substantive changes, measurements, discovered bugs, mistakes and corrections, architecture decisions, and open questions here as part of the same work. Chat history is not the authoritative project record.
