afxjzs/solar-logger/docs/LAB_NOTES.md

# Lab Notes

## Bench setup

The measured system is on a desk, not in a car. A jump-and-carry jump pack's battery, removed from its case, stands in for the BMW 12 V battery. The solar panel is in a window.

Every measurement in this file was taken against that arrangement. Irradiance is whatever the window gave at that time of day, so absolute solar numbers are not comparable across sessions and are not a model of the panel on a car. Current draw measurements of the XIAO and INA228 themselves are unaffected by this.

## 2026-10-02: Retained-state extraction ACCEPTED on hardware (D-063)

Full acceptance of `1801098` on image `8faa0e3`, run by the orchestrator the same
day the module was built. **PASSED on every criterion.** Evidence, criteria
written before any result, and limits:
[logs/evidence/2026-10-02/retained-state-1801098/](../logs/evidence/2026-10-02/retained-state-1801098/acceptance-result.md).

Experiment 3 was not reset, cleared, erased or corrupted at any point.

| Fact | Value |
| --- | --- |
| Records, post | 15,106, sequences 1412–16517 |
| Sequence gaps | **none, across the whole history** |
| Board invalid | 0 |
| Preflight lines reproduced byte-identically | **15,091 of 15,091** |
| `validate-dump.py --compare` | exit 0 |
| `check-totals-continuity.py --compare` | exit 0, boundary **identified** from the preflight dump |
| Forbidden strings | all ten absent from all 20 captures |

**The sharpest result: `FIRST_AFTER_BOOT` on exactly one record out of six
consecutive unclaimed wakes.** That flag is set when `rtcAutoCycleCount` reads 0.
A retained definition duplicated across translation units — the hazard BACKLOG
calls the single highest-risk detail in the modularization plan — would have set
it on every wake. One in six is positive proof of a single definition surviving
five deep sleeps. Nine of the ten relocated variables are directly evidenced;
`rtcAutoCommandedSleepMs` cannot be, for the structural reason D-063 records.

**Two results beyond the stage under test:**

- **The project's first hardware lease-expiry trace**, outstanding since
  2026-09-11 in both PROJECT and this file: `Host lease EXPIRED after 15000 ms
  without keepalive`, the firmware releasing the USB transport itself, the open
  tethered interval closing (D-026), and a return to autonomous sleep.
- **D-046's handoff asymmetry, side by side for the first time.** `RELEASE` slept
  299,750 ms, one cadence minus the 250 ms result grace; lease expiry slept
  300,000 ms, a full cadence, having no result to deliver. At 60 seconds these
  were 59,750 and 60,000; the move to 300 made them unmistakable.

**Three findings the acceptance itself produced, all recorded in BACKLOG:**

- `tools/storage-smoke.py` hardcoded a 150-second wait timeout written for the
  60-second cadence. At 300 it would fail a stage roughly half the time, and a
  timed-out capture looks exactly like a board that did not answer. Raised to
  400 with the reasoning beside the constant.
- `send.sh`'s default 600 ms idle threshold ends a capture before a later event.
  The first lease-expiry capture **exited 0 having never observed the expiry** —
  exit status answered "did HOLD work", not "did we see it". Retried under a new
  label with `--idle-seconds 8`; the failed attempt is kept.
- The four acceptance tools are mode 644 while their own usage text shows bare
  invocation, which fails. They have no shebang, so the usage text was corrected
  to `uv run python` rather than the files being made executable.

**Step 4 of the 2026-09-17 sequence was deliberately not run.** `LOGGER INTERVAL
60` would have reverted the cadence decision and cut storage headroom from about
16 days to about 3. `LOGGER INTERVAL 5` was sent while armed instead: refused,
`ERROR`, exit 1, cadence unchanged at 300 at both ends of the run.

## 2026-10-02: RTC-retained autonomous state extracted as the eighth module (D-063) — the build and software gate

CODE stage, run against HEAD `65f55d1` plus the uncommitted capture-gap work.
Software only: no upload, no serial port and no device command. Experiment 3 was
not touched. The boundary was chosen by the user from three options: move the
ten definitions and the magic, export them by `extern`, and leave every writer
and all of reservation in the sketch. See D-063.

**Files.** New: `Arduino/solar-logger/autonomous_retained_state.h`, `.cpp` and
`tests/test_characterization_autonomous_retained_state.py`. Changed:
`solar-logger.ino` (the definitions replaced by an `#include`, and three
comments that named the old location) and a comment-only edit in
`sequence_authority.h`. **No existing test file changed.**

**Red, then green.** The new file has 34 tests. Before the module existed, 32
failed and 2 passed:

- Real red evidence came from a second run, with the module files in place and
  the sketch's definitions not yet deleted. Three tests then failed by name:
  `solar-logger.ino defines rtcAutoMagic a second time`, `solar-logger.ino
  defines AUTO_RTC_MAGIC a second time`, and the writer-set test's
  `rtcAutoMagic is written outside a function body other than at its
  definition`.
- The 30 parametrized boundary guards are absence guards. They failed first
  only because the files did not exist, and they would pass against an empty
  module.
- `test_the_module_defines_no_function` and
  `test_only_the_known_functions_write_retained_state` passed before the move.
  The second is the compensating control for the `extern`, not evidence that
  the move happened.

| Gate | Result |
| --- | --- |
| Baseline `tools/check.sh` at `65f55d1` plus the capture-gap work | `ALL OK`, exit 0, **529 passed / 1 xfailed**, flash 1,106,273 B, globals 36,332 B, IntelliSense 8/8 |
| After the move, same tree | `ALL OK`, exit 0, **563 passed / 1 xfailed**, flash **1,106,273 B (unchanged)**, globals 36,332 B (unchanged), IntelliSense **9/9** |

The 34 added passes are the new file. Both gates ran on the combined working
tree; no isolated gate was run. The strict short-cadence overrun `xfail` is
still xfailed.

**Token audit (D-047).** The new sketch equals HEAD's sketch with one 66-token
run removed and `# include "autonomous_retained_state.h"` inserted, checked by
reconstruction rather than by a diff. The run's magic definition is verbatim in
the header, and its ten definitions are verbatim and in order in the `.cpp`.
`sequence_authority.h` is token-identical to HEAD. Sketch: 6,680 lines before,
6,670 after.

**Image comparison.** Both images are `--clean` builds, without the uploader's
revision injection; ELF copies were kept in session scratchpads, not in the
repository. All ten allocated `PROGBITS` sections keep their address and size,
and **exactly four bytes differ across all of them**: the core's compile-time
stamp in its "Software Info" string inside `.flash.rodata`. The two symbol
tables are identical — sorted `riscv32-esp-elf-nm -S` output diffs empty across
all 9,927 entries. **Measured, not predicted:** before the move the CODE stage
predicted a few bytes of flash change from cross-unit address loads. That was
wrong; the change is zero.

Verified independently by the orchestrator on 2026-10-02 from its own pair of
`--clean` builds, whose stamps were `11:19:42` against `13:10:27`. The CODE
stage reported `11:05:36` against `13:01:12` from its own builds, and reported
the symbol count as 7,900, which does not reproduce from `nm -S` (9,927 entries)
or from a defined code/data filter (7,603). The conclusion reproduces exactly;
only that one count did not, and it is corrected above.

**Audit ELFs, not `.bin` files.** The two `.bin` images differ in 69 bytes, in
three clusters, and only four of them are the ELF difference above. The other
65 are esptool's: a 32-byte `app_elf_sha256` patched into the application
descriptor, and a 32-byte image SHA-256 plus a checksum byte appended at the
tail. Both are hashes of the ELF, so neither can be inside it, and both change
whenever the stamp does. Recorded because a future audit diffing `.bin` files
will see 69 and should not hunt for 65 bytes of code.

**RTC layout.** All twelve project RTC symbols appear exactly once, in
`.rtc.data` (section 3), at the same addresses and sizes before and after:
`0x50000018`–`0x5000004F`, `rtcSleepTest*` last, the `int64_t` totals at
`0x50000020` and `0x50000028`, both 8-byte aligned. The open ESP-IDF v5.5.5
`should_load()` question (D-060) was not pursued.

**Kickoff correction.** The kickoff's writer table missed two writers:
`runAutonomousWakeCycle()` also writes `rtcAutoNextSeq` and `rtcAutoCycleCount`
by `++`. The orchestrator verified the correction. There are still nine writer
functions in total.

**Two orchestrator claims corrected by the CODE stage, both checked.**

- The `nm` symbol count of 7,900 *is* reproducible; the fault was not naming the
  command. It is `riscv32-esp-elf-nm -S --size-sort | wc -l`, which lists only
  symbols carrying a size, against 9,927 for plain `nm -S`. Confirmed on both
  ELFs. The record above keeps the identical-symbol-tables form because it
  states its own command.
- **The writer-set test survives a relocation, and the orchestrator was wrong to
  say the reservation stage would have to update it.** Settled by experiment
  rather than by reading, on the CODE stage's own suggestion: in a scratch copy
  of the sketch directory, `reserveSequenceBlock()` was cut verbatim out of
  `solar-logger.ino` into a new `sequence_reservation.cpp`, and the tree was
  re-read through `firmware_source`. The function was found at its new location,
  the mirror's writer set stayed `{autoStorageRecover, reserveSequenceBlock}`,
  and the file-scope-write check held, so the test passes unedited. Two negative
  cases confirm it is still a guard rather than vacuous: adding
  `sneakyExtraWriter()` produced a three-name set, and renaming the writer to
  `reserveSequenceBlockV2` produced the renamed set. Both correctly fail. The
  consequence is recorded in BACKLOG — the reservation stage gets no red test
  from this and needs its own positive evidence.

**Not changed, deliberately.** `stopAutonomousTest()` still leaves the running
totals alone (BACKLOG). One test docstring is now out of date and was left for
the orchestrator: `tests/test_characterization_sequence_authority.py` says the
mirror `rtcAutoSeqHighWater` itself was left in the sketch. Its assertions are
still true; only the mirror's definition moved.

**Hardware acceptance needed, not performed.** Retained state needs the full
2026-09-17 acceptance sequence, not only the extraction smoke (BACKLOG). The
image is byte-identical apart from the build stamp, so this checks the build and
upload, not new code paths. The transcript lines that would show the move kept
retained state working:

- **Retained lifetime across the wake boundary.** Step 8: five consecutive
  unclaimed timer wakes with the same `boot_id`, `[AUTO] Cycle:` increasing by
  one per wake, and record sequences contiguous. A broken retained definition
  would show up as `[AUTO] WARNING: Timer wake with no valid RTC session
  state.` on every wake, a new `boot_id` each time, and cycle 0 every time.
- **Session-clock continuity.** Step 8: `session_elapsed_ms` never decreases
  while `boot_id` is unchanged (D-033), each `interval_ms` is near the 300 s
  cadence, and `[AUTO] Commanded sleep for that interval:` is consistent with
  that cadence. Step 6's RELEASE on a timer wake and step 7's lease expiry
  must each be followed by a record that continues `session_elapsed_ms` rather
  than restarting near zero.
- **Power-test RTC state separate.** Shown at build level, not by the sequence:
  `rtcSleepTestMagic` and `rtcSleepTestCycle` keep their addresses, stay in the
  sketch and are absent from the module, which a test pins. Step 10 (`POWER TEST
  STOP` refused during a rendezvous, next record unaffected) shows only that the
  power-test path still leaves autonomous state alone. Nothing in the sequence
  arms a deep-sleep power test. `LOGGER AUTONOMOUS STATUS` on a rendezvous
  should print `[AUTO] RTC state valid: YES` and a `Cycles this power-on:` count
  that kept rising since the upload's cold boot.
- **Refusals.** Steps 9 and 10, as written.

## 2026-10-01: Sequence authority extracted as the seventh module (D-062) — NOT committed, uploaded or hardware validated

CODE stage, run against HEAD `6192c2d`. Software only: no upload, no serial
port and no device command. Experiment 3 was not touched. The boundary was
chosen by the user: move only the D-023 decision, and leave reservation and the
RTC mirror in the sketch. See D-062 for the reasoning.

**Files.** New: `Arduino/solar-logger/sequence_authority.h`, `.cpp` and
`tests/test_characterization_sequence_authority.py`. Changed:
`solar-logger.ino` (the decision replaced by a call, plus the include and
comments), comment-only edits in `storage.h` and `storage.cpp` that named the
old location, and one harness line in
`tests/test_characterization_storage_recovery.py`. That line adds
`sequenceAuthorityNext` to `EXTRACTED`, so the host build of
`autoStorageRecover()` links it; the docstring's function list gained a line
too. No assertion in an existing test changed.

**Red, then green.** Before the code existed, the new test file failed 30 of 30.
Only two of those are real red evidence: the decision was "defined 0 times",
and it had no caller. The other 28 are absence guards, and they failed only
because the module files did not exist yet. They pass on an empty module too,
which is why the two positive tests exist.

| Gate | Result |
| --- | --- |
| Baseline `tools/check.sh` at `6192c2d` plus others' uncommitted work | `ALL OK`, **499 passed / 1 xfailed**, flash 1,106,195 B, globals 36,332 B, IntelliSense 7/7 |
| After the move, same tree | `ALL OK`, **529 passed / 1 xfailed**, flash **1,106,273 B (+78)**, globals 36,332 B (unchanged), IntelliSense **8/8** |

The 30 added passes are the new file. Both gates ran on the combined working
tree. No isolated gate (`6192c2d` plus only this stage's files) was run.

**Image comparison.** Both images were built with `--clean` into a scratch
directory, without the uploader's revision injection. `.flash.text` +34 B:
`sequenceAuthorityNext` 244 B is new, and `autoStorageRecover(bool)` went from
522 to 312 B. No other symbol changed size. `.eh_frame` +44 B, with exactly one
new FDE (6,356 to 6,357). The 1,757 human-readable rodata strings are identical.
The raw rodata bytes differ only in address-valued bytes and one time-of-build
string, 13:11:53 versus 13:14:45. That string does not come from the project
sources, which contain no `__TIME__`.

**Token audit (D-047).** Five runs, 163 tokens, left the sketch. What came in
is the `#include`, the function name and its arguments `scan ,
rtcAutoSeqHighWater`. The module body matches the removed tokens except that
`rtcAutoSeqHighWater + 1` became `reservedHighWater + 1`, plus `return next`.
`logIntact` and `fromLog` are now computed after the silent
`loadSequenceHighWater()` instead of before it, which cannot change their
values or the output.

**Sketch:** 6,735 lines before, 6,680 after.

**Hardware acceptance needed, not performed.** This stage needs the normal
smoke after an extraction (BACKLOG "Hardware smoke test after an extraction
group"). The INFO path does not run this code. The cold-boot and arm paths do,
so check the boot transcript's `[STORAGE] Next sequence from log: …, from NVS
reservation: …, using: …` and the provably-intact line, and confirm the next
record continues the log with no gap. Damaged-log branches stay host-tested
only.

## 2026-10-01: Recovery is told whether the retained totals were valid (D-061) — NOT committed, uploaded or hardware validated

CODE stage. Software only: no upload, no serial port, no reset, clear, erase or
corruption injection. Experiment 3 untouched. Two files changed in the working
tree: `solar-logger.ino` (`autoStorageRecover()` and its four call sites) and
`tests/test_characterization_storage_recovery.py`. The kickoff reports that the
board runs `58a4e09` after a passed healthy-log acceptance today. That
acceptance is not recorded in these docs yet; this stage did not check it.

### The change

`autoStorageRecover()` now takes `bool retainedStateValid`. Each call site
captures `rtcAutoMagic == AUTO_RTC_MAGIC` into a local immediately before it
sets the magic, and passes that local in. When the scan could not read the log
(`openFailed || readError`):

- valid: the totals are carried, as under D-060, and a new line says the
  retained state was valid
- not valid: the totals are set to 0, and two lines say the retained state was
  not valid and that the totals restart at zero

Every readable log reseeds from its last record exactly as before. Policy: D-061.

**Why a parameter.** The validity exists only at the call site, for one
statement, before the magic is set. A parameter makes each of the four callers
state it, and the compiler rejects a caller that does not. Moving the magic
assignment after the call and reading the global inside recovery would have
worked too, but it would hide an ordering rule in four places. BACKLOG calls
that kind of latent ordering dependency the worst thing to carry across a file
split. The harness also needs no model of `rtcAutoMagic`: it passes the bool
from a new eighth argument, which defaults to invalid, as after a power-on
reset. The return type is still `uint32_t`, so the slice-by-name assertion is
unchanged.

### Is the cold-boot resume reachable with valid retained state? Yes, in two ways

Read from the source, not observed. The resume site in `setup()` is the
`else` branch after `autonomousColdBootMaintenanceWindow()`.

1. **A reset that is not a deep-sleep wake**, if RTC memory survives it. That
   is exactly the ESP-IDF `should_load()` question D-060 could not close. The
   firmware no longer needs the answer: valid carries and says so, invalid
   zeroes and says so.
2. **A timer wake whose first NVS load reads "not armed"**. `setup()` loads the
   armed flag twice, once in the timer-wake branch and again during ordinary
   initialization. `loadAutonomousConfig()` turns a namespace that will not
   open into "not armed" with no signal (BACKLOG, "NVS load failures become
   plausible defaults with no signal"). If the first load fails and the second
   succeeds, the timer branch is skipped with the magic still valid, and the
   resume runs. That needs a transient NVS failure and has never been seen.

It is reached with **invalid** state by a timer wake that lost RTC state and
then failed its storage mount, which falls through on purpose.

A timer wake claimed by a host does **not** reach the resume. The claim sets the
USB transport bit, `anyHostConnected()` reads only that bit, and only
`connectionRelease()` clears it. Nothing between the rendezvous return and the
resume calls `connectionRelease()`, so the "host session is held" branch is
taken. A wake disarmed during its rendezvous does not reach it either, because
`autonomousTestArmed` is false. A failed sleep (`esp_sleep_enable_timer_wakeup`
or `esp_deep_sleep_start` returning) returns from `setup()` before the resume.

### Behavior that changes from 58a4e09

Only when the log cannot be read. A healthy, repaired-tail or mid-file-damaged
log reseeds as before, and no new line is printed.

- **Timer-wake RTC-loss rebuild and handoff rebuild:** both sit inside
  `rtcAutoMagic != AUTO_RTC_MAGIC`, so they now zero instead of carrying. This is
  the case the kickoff named.
- **Arm (`LOGGER AUTONOMOUS ON`):** the magic is ordinarily 0 here, because
  `stopAutonomousTest()` clears it and so does the image initializer. A re-arm
  after an in-session `LOGGER AUTONOMOUS OFF` used to carry the previous
  session's totals under D-060. It now zeroes them and says so. The values are
  still in RTC memory, but the firmware's own guard has declared them invalid,
  and this stage follows the guard.
- **Cold-boot resume:** follows whatever the magic was, as above.

Sequence selection, D-023 and the NVS floor are unaffected. The next sequence
was identical in each valid/invalid pair below.

### Tests first, and the red-check

Written before the firmware change. They replace D-060's two retained-totals
tests:

- `test_an_unread_log_carries_valid_retained_totals_and_says_so`,
  parametrized `open-failure` / `short-read`
- `test_an_unread_log_zeroes_invalid_retained_totals_and_says_so`, same
  parametrization
- `test_a_readable_log_still_replaces_whatever_the_totals_held`, now seeded
  VALID, so an implementation that preferred valid retained totals over a
  readable log would fail it
- `test_every_recovery_call_is_told_whether_retained_state_was_valid`, a source
  test. The harness runs recovery, not its callers, and validity read after the
  magic is set is always true. So it pins capture, then set, then call, at each
  of exactly four sites.

Red-check: the new driver calls `autoStorageRecover(retainedValid)`, which
`58a4e09` cannot compile, and erroring is not failing. Staged in a detached
worktree at `58a4e09`: the new test file copied in, and only the definition
widened to an **unnamed** `bool`. An unnamed parameter cannot be read, so the
body under test is exactly `58a4e09`'s. The call sites were left unchanged; the
harness does not compile them. The firmware itself was unedited at the time
(`git diff HEAD -- Arduino/` empty). Result: **5 failed, 1 passed**.

- invalid, both cases: `(5555, 6666) == (0, 0)` failed. The defect.
- valid, both cases: failed only on the new validity line. The values were
  already carried, which is D-060's half that stays.
- source-order test: failed, because no call passes validity.
- healthy log: passed, as it must.

After the fix the storage file runs **88 passed** (85, minus the 3 replaced,
plus 6). The script was a scratch copy of the September 29 `redcheck.sh`
technique. It is not preserved in `logs/evidence/`, which this stage did not
touch.

Serial from the fixed harness, disposable fixtures, retained seeded 5555/6666:

```text
[STORAGE] Running totals could NOT be recovered: the log could not be opened, so none of it was read.
[STORAGE] Retained RTC state was valid before recovery, so its totals are the best figure available.
[STORAGE] Carrying the retained totals instead: Qsum_uAh=5555 Esum_uWh=6666. These were NOT checked against the log.
```

```text
[STORAGE] Running totals could NOT be recovered: a short read stopped the scan before the end of the log.
[STORAGE] Retained RTC state was NOT valid before recovery, so there are no totals to carry.
[STORAGE] Restarting the running totals at Qsum_uAh=0 Esum_uWh=0. The next record does NOT continue the log's totals.
```

The other two combinations print the same lines with the other reason.

### Gate

`tools/check.sh`, each `ALL OK`, exit 0, all seven steps PASS:

| Scope | pytest | Flash / globals |
| --- | --- | --- |
| Isolated baseline: detached worktree at clean `58a4e09` | 472 passed, 1 xfailed | 1,105,707 B / 36,332 B |
| Isolated fix: that worktree plus only the two changed files | **475 passed, 1 xfailed** | **1,106,195 B** / 36,332 B |
| Combined working tree before the change | 496 passed, 1 xfailed | 1,105,707 B / 36,332 B |
| Combined working tree after the change, including other stages' uncommitted work | 499 passed, 1 xfailed | 1,106,195 B / 36,332 B |

Flash rose 488 bytes, which covers the new branch and its three strings. It was
not broken down by symbol. Globals are unchanged. Pyright 0/0/0, IntelliSense
7/7. The worktree was removed afterwards.

### Hardware acceptance still needed

A healthy-log smoke only. After upload, boot recovery must still reseed the
totals from the last record and print neither "could NOT be recovered" nor
"Retained RTC state". New records' Qsum/Esum must continue from the preceding
record. Both unreadable branches are host-injected only, which does not show
what a physical LittleFS open or read fault does. One must not be produced by
damaging the Experiment 3 log.

## 2026-09-29: D-060 reviewed and committed as 58a4e09 — one OPEN issue found, one citation corrected

Orchestrator review and close of the D-060 CODE stage recorded in the entry
below. No board was touched. The board still runs `1980d94` and has now not run
two commits, `44d8b27` and `58a4e09`.

### Gate re-run on the working tree

`tools/check.sh` exit 0, `ALL OK`, all seven steps PASS. pytest **496 passed,
1 xfailed** in 55.87 s; pyright 0/0/0; warning-free `--clean` compile;
IntelliSense 7/7. Flash **1,105,707 B** (84%), globals **36,332 B** (11%). Every
figure the CODE stage reported reproduces here, including the **+434** flash
delta over `44d8b27`.

### Verified against the source, not the report

- **`Print` really does take `long long`.** The new message casts the totals to
  `long long`, and a warning-free compile would not distinguish an integer
  overload from a silent promotion to `double`. Core 3.3.11's `Print.h` declares
  `size_t print(long long, int = DEC)` at line 91, so the integer overload is
  what binds. Checked in the installed header, not from memory.
- **The CODE stage's caveat about the cold-boot resume is correct.** Line 6337
  sets `rtcAutoMagic = AUTO_RTC_MAGIC` unconditionally and then calls recovery,
  with no prior test of the magic. The kickoff had asserted that all four sites
  setting the magic meant recovery only ran when retained state was invalid.
  That inference does not follow and was wrong in the kickoff; the CODE stage
  caught it.

### Citation corrected: the ESP-IDF version does not match the toolchain

D-060 cited `should_load()` "read from the v5.4 source". The installed core
3.3.11 bundles **ESP-IDF v5.5.5**, pinned from
`~/Library/Arduino15/packages/esp32/tools/esp32c3-libs/3.3.11/include/esp_common/include/esp_idf_version.h`
(MAJOR 5, MINOR 5, PATCH 5). Only headers and prebuilt libraries are installed
locally, so v5.5.5's `should_load()` has not been read by anyone. D-060 now
names the gap instead of implying the versions match. The zero-after-reset
behavior is EXPECTED, not measured, and has never been observed on this board.

### OPEN issue found in review

`rtcAutoMagic` is the firmware's own answer to "is retained state valid", which
D-011 introduced because RTC memory is undefined after a power-on reset.
Recovery cannot read it: all four call sites overwrite it immediately before
calling. Two of them reach recovery *because* it was invalid, and one says in
its own comment not to guess the running totals on that path — which is exactly
what `58a4e09` now carries there when the log is unreadable.

Bounded, not silent: the new message prints the carried value and says it was
not checked against the log. Filed as its own BACKLOG item rather than absorbed
into this stage, together with the unproven reachability of the line 6337 site.

### Commit

`58a4e09`, two files, +102/-4, on main, **not pushed**. Documentation remains
uncommitted, still interleaved with other stages' prose.

### Still outstanding

The healthy-log hardware smoke, now covering two unvalidated commits rather than
one.

## 2026-09-29: Running totals are no longer reseeded from an unread log (D-060) — NOT committed, uploaded or hardware validated

CODE stage. Software only: no upload, no serial port, no reset, clear, erase or
corruption injection. Experiment 3 untouched; the board still runs `1980d94`.
Two files changed in the working tree: `solar-logger.ino`
(`autoStorageRecover()` only) and `tests/test_characterization_storage_recovery.py`.

### The change

When `scan.openFailed || scan.readError`, `autoStorageRecover()` no longer
assigns `rtcAutoRunChargeUAh` / `rtcAutoRunEnergyUWh`. It prints why and what it
carries instead. Every other outcome reseeds as before. Policy: D-060.

### Tests first, and the red-check

Three tests, written before the firmware change. The harness gained one optional
argument pair that seeds the retained totals before recovery. Without it the
failed-open case cannot be tested on values, because "left alone" and
"overwritten with the scan's zero" both give 0/0 from a zero start. It also
gained a `print(long long)` overload on the recording Serial, matching the
sketch's `Serial.print(static_cast<long long>(...))` idiom.

- `test_an_unread_log_leaves_the_retained_running_totals_alone_and_says_so`,
  parametrized `open-failure` (`deny_log_open`) and `short-read`
  (`phantomBytes=72`); retained seeded to 5555/6666, log records 100/200 then
  300/400.
- `test_a_readable_log_still_replaces_whatever_the_totals_held`: the same log,
  read cleanly, still reseeds 300/400 over the seeded value and prints no
  recovery-failure line.

Red-check: no struct member was added, so the new tests compile against the
unmodified `44d8b27` sketch directly and no staging was needed. Run in the main
tree before the sketch was edited (`git diff HEAD -- Arduino/` empty): **both
failure-mode cases FAILED**, `(0, 0) == (5555, 6666)` for the failed open and
`(300, 400) == (5555, 6666)` for the short read, the stale last-reached record.
The healthy-log test and the two existing reseed tests
(`test_a_valid_log_reseeds_the_running_totals_from_its_last_record`,
`test_running_totals_are_reseeded_past_the_damage`) passed, and are unedited.
After the fix the storage file runs **85 passed** (82 before plus 3).

Serial from the fixed harness, disposable fixture:

```text
[STORAGE] Running totals could NOT be recovered: the log could not be opened, so none of it was read.
[STORAGE] Carrying the retained totals instead: Qsum_uAh=5555 Esum_uWh=6666. These were NOT checked against the log.
```

```text
[STORAGE] Running totals could NOT be recovered: a short read stopped the scan before the end of the log.
[STORAGE] Carrying the retained totals instead: Qsum_uAh=5555 Esum_uWh=6666. These were NOT checked against the log.
```

The healthy log's recovery serial has no new line.

### Which deployed paths actually change

All four call sites (`beginAutonomousSleepFromHostSession` rebuild, arm, the
timer-wake RTC-loss rebuild and the cold-boot resume) set `rtcAutoMagic`
immediately before calling recovery. The first and third are inside an explicit
`rtcAutoMagic != AUTO_RTC_MAGIC` test. The arm path runs with the magic 0 (set
by `stopAutonomousTest()` or the image initializer). **The cold-boot resume
does not test the magic.** A timer wake reaches it after an earlier error. I
did not prove it unreachable with valid retained state; if it is reachable, the
new behavior carries live totals there rather than overwriting them.

- Any reset that is not a deep-sleep wake: the totals are the image initializer,
  0. That is verified against the bootloader source (D-060). Open failure: the
  value is unchanged at 0, and the two lines are new. Short read: the value
  changes from the stale last-reached record to 0, plus the two lines.
- Re-arm after an in-session `LOGGER AUTONOMOUS OFF`, or a timer wake with an
  invalid magic: the previous session's totals are carried and printed, instead
  of 0 or a stale partial value.
- A healthy, repaired-tail or mid-file-damaged log: unchanged.

Nothing here reached the records' format, the CRC, D-023 sequence authority or
the NVS floor, and the firmware identity is unchanged.

### Gate

`tools/check.sh`, three scopes, each `ALL OK`, exit 0, every step green:

| Scope | pytest | Flash / globals |
| --- | --- | --- |
| Isolated baseline: detached worktree at clean `44d8b27` | 469 passed, 1 xfailed | 1,105,273 B / 36,332 B |
| Isolated fix: that worktree plus only the two changed files | **472 passed, 1 xfailed** | **1,105,707 B** / 36,332 B |
| Combined working tree after the change, including other stages' uncommitted work | 496 passed, 1 xfailed | 1,105,707 B / 36,332 B |

Flash rose 434 bytes. That covers the new branch and its three message strings;
it was not broken down by symbol. Globals are unchanged. IntelliSense 7/7,
pyright 0 errors, 0 warnings, 0 informations. A working-tree gate also ran
before the change and exited 0 with pytest 493 passed / 1 xfailed. Its later
steps overlapped the start of these edits, so only its pytest count is a clean
pre-change figure, and the isolated baseline above is the clean one. Both
worktrees were removed afterwards.

### Hardware acceptance still needed

A healthy-log smoke only: after upload, boot recovery must still reseed the
totals from the last record and print no "could NOT be recovered" line, and new
records' Qsum/Esum must continue from the preceding record. The failure branches
are host-injected only. That does not show what a physical LittleFS open or
read fault does, and one must not be produced by damaging the Experiment 3 log.

## 2026-09-29: Scan-open fix reviewed, red-checked and committed as 44d8b27 — still NOT hardware validated

Orchestrator close of the CODE stage recorded in the entry below. No board was
touched: no upload, no serial port, no reset or storage clear. Experiment 3 is
untouched, and the uploaded image is still `1980d94`, which HAS the defect.

### Gate re-run on the working tree

`tools/check.sh` exit 0, `ALL OK`. pytest **493 passed, 1 xfailed** in 51.58 s;
pyright 0 errors, 0 warnings, 0 informations; py_compile; warning-free `--clean`
compile; IntelliSense **7/7**; shell syntax; whitespace. Flash **1,105,273 B**
(84%), globals **36,332 B** (11%). Every figure reproduces the CODE session's,
so what that report listed as predicted is now observed.

The IntelliSense step printed two stale-directory notices, for
`.vscode/arduino-build` and the old-layout contents of `build/intellisense`.
Both are dead, neither is a failure, and no cleanup was performed.

### Red-check — the CODE report's form of it does not reproduce

That report claimed 5 of the 7 new tests fail against pre-fix code, without
saying how it was staged. **Run directly, it does not compile**: `reportScan()`
reads `scan.openFailed`, which `1980d94`'s `AutoLogScan` has no member for, so
all seven ERROR at fixture setup instead of failing.

Staged instead in a detached worktree at `1980d94` with the new test file copied
in and **only the `openFailed` field declared** in `storage.h` and never set, so
the behavior under test stays pre-fix. `AutoLogScan scan = {}` value-initializes
it to false, so the staging is deterministic. Result: **5 failed, 2 passed**.
The 2 that pass are the conservative half the entry below already recorded —
the file is untouched and the NVS floor is applied.

The second defect reproduced verbatim on that pre-fix tree, which is the
measured form of the argument made in the entry below:

```text
[STORAGE] ERROR: Could not open the log for scanning.
[STORAGE] Rewriting the log to its valid prefix: 0 of 0 bytes.
[STORAGE] ERROR: Could not open the log for recovery.
```

`autoStorageTruncateToValid()` announced the rewrite and proceeded; only its own
source open failing, for the same reason the scan's had, stopped it.

The worktree was removed afterwards and the working tree verified unchanged.

### Review

Every consumer of `readError` was enumerated, because setting it on an open
failure changes each one. The rewrite's own guard in `storage.cpp`
(`scan.validAfterInvalidRecords > 0 || scan.readError`) now refuses; `logIntact`
in `autoStorageRecover()` drops to the NVS floor, which the `nextSeq == 5001`
test pins; `autoStorageScanAndRepair()`'s `else if (scan.readError)` is ordered
behind the new `openFailed` branch; and `printStorageInfo()`'s `readError`
branch is unreachable for this case because of the early return above it. Those
are all of them in the firmware.

### Commit

`44d8b27`, four files, +296/-17, on main, **not pushed**. The documentation
describing the fix was deliberately left out, because it is interleaved with the
capture-gap stage's prose in the same files, and it remains uncommitted.

### Still outstanding

The healthy-log hardware smoke, which is the only check that matters for this
change: it must not have moved the path it does not touch. The open-failure
branch needs a real filesystem fault and must not be obtained by damaging the
Experiment 3 log.

## 2026-09-29: An unread log no longer reports an intact tail — NOT hardware validated

A bounded correctness fix to the open-for-scan diagnostic recorded in BACKLOG
on September 29. Nothing was uploaded, no serial port was opened and no board
was touched. Experiment 3 was not reset, cleared or read. Every failure in this
work is staged in a pytest temporary directory.

**This is not a hardware result.** The image was compiled and the host tests
were run. A physical open failure has never been observed on this board, and
the harness produces one by refusing the read-open while leaving the file
untouched — software failure injection, which does not establish what a real
LittleFS fault does.

### The defect, as the code had it

`autoStorageScan()` printed `[STORAGE] ERROR: Could not open the log for
scanning.` and returned the zero-initialized `AutoLogScan` with `readError`
still false. Every count in it was zero because nothing had been read, and both
callers read those zeros as measurements:

| Caller | What it said about a log it had never opened |
| --- | --- |
| `autoStorageScanAndRepair()` | `File bytes: 0`, `Valid records: 0`, then `Log tail is intact: ALL OK` |
| `printStorageInfo()` | `Log bytes: 0`, `Valid records: 0`, `Trailing bytes: 0`, `Tail status: INTACT`, and `CMD_RESULT,LOGGER STORAGE INFO,OK` |

A readable empty log produces exactly those numbers and that tail status, and
truthfully. The two were indistinguishable to a caller and to an operator.

The conservative half was real and is unchanged: `logIntact` already required
`validRecords > 0`, so the NVS reservation floor applied, and `trailingBytes`
being zero meant `autoStorageScanAndRepair()` never entered its repair branch.
No log bytes were at risk through the normal path.

### A second defect, found by the regression test rather than by reading

Driven **directly** against an unopened log — which is what the `force-truncate`
harness command exists to do — `autoStorageTruncateToValid()` printed

```text
[STORAGE] Rewriting the log to its valid prefix: 0 of 0 bytes.
[STORAGE] ERROR: Could not open the log for recovery.
```

It announced the rewrite and proceeded. The only thing that stopped it was its
own source open failing for the same reason the scan's had. Had the fault
cleared in between, it would have copied `keepBytes` — zero — into the temporary
file, removed the log and renamed the empty file over it, destroying every
record on the strength of a scan that read nothing.

`autoStorageScanAndRepair()` cannot reach that branch for an unopened log,
because `else if (scan.trailingBytes > 0)` is false. That is the caller's
`else if` chain, not this function's own guarantee, and it is precisely the
argument D-058 made for keeping the refusal compiled in the function instead of
letting the compiler infer it from the one call site.

### What changed

`AutoLogScan` gains one field, `openFailed`, and a failed read-open sets it
together with `readError`.

- **`readError` is what carries the case into the existing refusals.** The
  rewrite's guard is `validAfterInvalidRecords > 0 || scan.readError`, and
  `logIntact` includes `!readError`. Setting it is what makes those cover an
  unopened log without either of them learning a new condition.
- **`openFailed` carries what `readError` cannot.** A short read has real
  partial counts; a failed open has none. The distinction decides whether a
  number may be printed at all.
- `autoStorageScanAndRepair()` reports the size, record count and sequence range
  as UNKNOWN rather than zero, and names the tail **UNREAD** — neither intact
  nor damaged — before the read-error branch, whose "could not be read to the
  end" understates this and whose advice to run `LOGGER STORAGE DUMP` would open
  the same file and fail the same way.
- `printStorageInfo()` prints `Tail status: UNREADABLE`, prints no figure it did
  not measure, and **returns false**, so the command answers
  `CMD_RESULT,...,ERROR`. Under D-041 a command that did not do what was asked
  does not report `OK`, and the mount failure directly above it already reported
  itself that way.
- D-023 authority, the healthy-log path and the record format are untouched.

What an operator now sees for a log that will not open:

```text
[STORAGE] ERROR: Could not open the log for scanning. The log exists and none of it was read, so nothing is known about its contents and nothing will be repaired automatically.
[STORAGE] Scanning durable log...
[STORAGE] The log exists but could not be opened. Its size, record count and sequence range are UNKNOWN, not zero.
[STORAGE] The log was never read, so its tail is neither intact nor damaged: it is UNREAD. NOTHING WAS DISCARDED, and nothing will be repaired automatically while this persists.
[STORAGE] Appending continues normally, and the NVS reservation floor decides the next sequence because the log proved nothing.
[STORAGE] Next sequence from log: 1, from NVS reservation: 5001, using: 5001
[STORAGE] Log tail is NOT provably intact, so the NVS reservation floor applies.
```

### Tests

Seven added to `tests/test_characterization_storage_recovery.py`, all executing
the firmware's own compiled functions. **No existing test was changed**; the
harness gained one staging control beside the existing phantom-bytes one, which
fails read-opens of the log and leaves the file alone, so a test can prove the
bytes were never touched.

**Five of the seven fail against the code they replace**, and the two that pass
are the conservative half above — the log is left alone, and the NVS floor
applies — which is exactly what the BACKLOG finding said was already true and is
worth pinning so a later change cannot quietly lose it.

| Test | Pre-fix |
| --- | --- |
| the scan reports it unreadable, not scanned | FAIL |
| it is never called intact | FAIL |
| it is left exactly as it was | pass |
| it keeps the NVS reservation floor | pass |
| INFO reports UNREADABLE and answers ERROR | FAIL |
| absent, empty and unopenable are three answers | FAIL |
| the rewrite refuses it even when called directly | FAIL |

### Gates

Both run in full, with their scopes stated rather than mixed:

| Gate | Scope | Result |
| --- | --- | --- |
| Before, working tree | the tree as found, including the uncommitted host capture-gap work | `ALL OK` — **486 passed, 1 xfailed** |
| After, working tree | the same tree plus this change | `ALL OK` — **493 passed, 1 xfailed** |
| After, isolated snapshot | `1980d94` plus only the four files this change touches, with the host tool, its tests and the pandas dependency excluded | `ALL OK` — **469 passed, 1 xfailed** |

469 is 462 plus these seven, against the September 29 isolated storage baseline.
493 is 486 plus the same seven. pyright, py_compile, the warning-free clean
Arduino compile, IntelliSense 7/7, shell syntax and tracked whitespace passed in
both. The strict `xfail` is the unrelated short-cadence autonomous overrun
defect; it was not touched. No dependency or tooling change was made.

### Flash, accounted for rather than accepted (D-047)

Program storage **1,104,313 → 1,105,273 bytes, +960**. Global variables
**36,332, unchanged**. Both images were rebuilt clean into separate output
directories and the baseline reproduced `HEAD` exactly.

| Section | Before | After | Delta | What it is |
| --- | ---: | ---: | ---: | --- |
| `.flash.text` | 826,966 | 827,082 | **+116** | three symbols, and only three |
| `.flash.rodata` | 168,508 | 169,348 | **+840** | the new messages |
| `.eh_frame` | 30,316 | 30,320 | **+4** | one existing FDE |
| | | | **+960** | |

Every other section is byte-identical, including all four `.dram0`/`.noinit`
sections that make up the globals figure.

**The 116 code bytes are the three functions this change edits, and nothing
else.** A per-symbol comparison of the two ELFs finds exactly three that changed
size: `printStorageInfo()` +58, `autoStorageScanAndRepair()` +52,
`autoStorageScan()` +6. No symbol was added or removed, which the identical FDE
count of **6,356** confirms independently, so the `.eh_frame` +4 is one existing
FDE whose CFI grew with the body it describes.

`autoStorageTruncateToValid()` is **0x266 = 614 bytes and type `T` in both
images**, the same figure D-058 recorded. Its refusal is still compiled, which
is measured here rather than reviewed, as D-058 requires.

**The 840 rodata bytes are message text.** Comparing the two images'
NUL-terminated string tables as multisets: 908 bytes of strings arrived, 74 left,
net **834**. The remaining 6 are packing in the merged string pool. Of the
arrivals, 9 bytes are the core's build timestamp and not this change's. One
departure needs saying: the bare `"UNREADABLE"` literal disappears from the
table because the linker now stores it as the suffix of
`"[STORAGE] Tail status:      UNREADABLE"`. It still occurs exactly once as
`UNREADABLE\0` in both images, so the short-read branch that prints it did not
lose its string.

### Found and not fixed

`autoStorageRecover()` still ends with
`rtcAutoRunChargeUAh = scan.lastRunChargeUAh` and its energy equivalent. On this
outcome those are zero, so the RTC-retained running totals silently restart at
zero for a log nothing read, and nothing says so. It is a silent deviation
rather than a false report, and the same thing happens on the pre-existing
short-read path where at least a prefix was read. Changing it alters deployed,
characterized accounting behavior on both paths, so it is recorded in BACKLOG as
its own stage rather than carried inside a diagnostic fix. These are the
test-local totals D-017 keeps separate from experiment state; no stored record
is affected.

Two smaller observations, neither changed: `autoStorageScan()`'s error line
prints **before** `autoStorageScanAndRepair()`'s "Scanning durable log..."
banner, because the scan runs before the banner; and `dumpStorage()` still
returns true after breaking on a short read mid-dump, having printed the error.
The first is cosmetic ordering, the second is a separate completion-semantics
question from the one fixed here.

### Ownership and what was left alone

Firmware, tests and the four files above are this stage's. The uncommitted host
capture-gap work (`tools/charger-transitions.py`,
`tests/test_charger_transitions.py`) and the pandas dependency changes were not
touched, and the isolated gate deliberately excludes them so the firmware figure
is not a mixed snapshot. The sealed September 29 hardware evidence was not
altered. Nothing was committed, staged or pushed. Firmware identity is unchanged
at `0.3.0-dev` / `solar-logger-protocol-ack-v3`; the record format stays version
1 at 72 bytes.

**Hardware acceptance, PENDING — nothing below has been run.** The healthy-log
path is the check this change most needs, because it is the path it must not
have moved: upload, then confirm `LOGGER STORAGE INFO` still reports the
Experiment 3 log with `Tail status: INTACT`, zero trailing bytes and at least as
many records as before, and that `LOGGER STORAGE DUMP` still decodes them with
invalid 0. The open-failure branch cannot be exercised without a real filesystem
fault, and **must not** be exercised by damaging the Experiment 3 log. If an
unexpected `UNREADABLE` or any storage error appears during that smoke, stop
acceptance and diagnose rather than continuing.

## 2026-09-29: Storage 1980d94 passes healthy-log hardware smoke

This session performed the deliberate hardware stage, following the startup
handoff and canonical docs. Git stayed on main at **1980d94**, empty index,
clean firmware/tools; source hashes remained unchanged. Existing host analysis,
dependencies and older docs/evidence remain uncommitted. App inventory found no
other active BMW chat, but process inspection found two Claude Code processes
with this repo as cwd; the user explicitly confirmed those CODE sessions idle.
No host logger or pending serial/upload marker was present. Initial sandboxed
process inspection was denied; the permitted escalated read established ownership.

**Fresh healthy-log storage hardware smoke passed, 2026-09-29, on clean
1980d94** (`0.3.0-dev`, `solar-logger-protocol-ack-v3`). Experiment 3 retained;
full pre/post dumps preserve all 10,659 preflight record lines exactly, and
post-upload boot 36 adds 3 records, 12073–12075. Final dump: 10,664 records,
1412–12075, board invalid 0; observed INFO scans have trailing 0 and INTACT tails
with no storage errors. [Raw evidence, checksums and limits](../logs/evidence/2026-09-29/storage-hardware/README.md).
Damaged-log branches remain host/synthetic tested only. No standalone reset,
storage clear, whole-flash erase or corruption injection was performed.

### Preflight and upload

Read-only VERSION reported **eba3b5d-dirty / 0.3.0-dev /
solar-logger-protocol-ack-v3**. NVS-backed autonomous status reported Experiment 3,
boot 35, armed YES, cadence 60 s. INFO at 09:00 PDT: 10,650 valid records,
766,800 bytes, 1412–12061, record size 72, trailing 0, INTACT. The complete
09:09 dump held 10,659 records through 12070; all exp=3, consecutive, invalid 0.
All 5,756 September 25 record lines matched exactly. BEGIN/END, count summary,
ACK and matching RESULT OK were verified before upload. The port disappeared
only after completion and normal unclaimed-rendezvous sleep. The sender's generic
“expected for RELEASE” stop text also appears for this DUMP; no RELEASE was sent
in preflight. Decoded output is preserved byte-for-byte, not a binary flash image.

Canonical `tools/upload.sh` ran only after that evidence was sealed. It compiled
clean revision 1980d94 and uploaded successfully on attempt 1 at 09:11 PDT.
Post-upload VERSION independently reported **1980d94**, with the unchanged version
and build ID. The injected build used 1,104,265 flash bytes and 36,332 global
bytes; this is distinct from the prior uninjected check build's 1,104,313 bytes.
Uploader performed its normal bootloader reset, targeted firmware-region erase/
program and restart; no separate reset, NVS/LittleFS erase or whole-flash erase
was requested. The upload log records all programmed addresses.

### Retention, session handoff and autonomous growth

| Observation | Valid/read count | Newest sequence | Notes |
| --- | ---: | ---: | --- |
| Preflight dump | 10,659 | 12070 | all exp=3, invalid 0 |
| Post-upload INFO | 10,661 | 12072 | 767,592 B; 72-byte records; trailing 0; INTACT |
| After session RELEASE, next autonomous wake INFO | 10,663 | 12074 | 767,736 B; trailing 0; INTACT |
| Final complete dump | 10,664 | 12075 | all exp=3; invalid 0; exact preflight prefix |

The old image added 12071/12072 before upload. New boot **36** starts at
**12073**, flags **0x4 FIRST_AFTER_BOOT**, then advances through **12075** with
flags **0x0**. All 3 new-boot records have interval_ms 60004. Counts describe
successive captures, not loss or contradictory summaries. Sequence numbers are
unique/consecutive here; this does not remove D-023's permitted reservation gaps.
Record version 1/72-byte contract is unchanged in the clean source; hardware INFO
reports 72 and DUMP validates records. Binary CRCs were not recomputed from rounded
text; invalid 0 is the board validator's report.

HOLD, KEEPALIVE, STATUS, SESSION STATUS and RELEASE each returned matching ACK and
RESULT OK. HOLD restored **Experiment 3, interval 479**, charge 86.901199 mAh,
energy 1248.362325 mWh; held STATUS agreed. RELEASE closed a **3.788 s** tethered
interval, saved checkpoint **480**, and resumed armed autonomous sleep with
**59,750 ms** remaining. New autonomous records appeared after that release.
The final dump ended after RESULT OK and the normal autonomous return to sleep.
No Python logger was started; no held lease remains from this test.

### Diagnostics and evidence limits

- **General STATUS during an unclaimed timer wake reported zeros**, including
  Experiment ID 0. Source confirms `printStatus()` reads experiment globals before
  the later `loadCheckpoint()` path restores them; NVS-backed AUTONOMOUS STATUS
  and every record say exp=3. Held STATUS correctly reports 3. This is a pre-existing
  diagnostic defect, not lost experiment state or an extraction regression; track
  a separate correction in BACKLOG. Do not rely on generic STATUS at that phase.
- Immediate post-upload AUTONOMOUS STATUS ran in the cold-boot maintenance window:
  armed YES but running NO, boot/next seq 0, RTC invalid. Later boot-36 records
  establish initialization and actual autonomous progress; those early zeros do
  not identify a failed recovery.
- HOLD and RELEASE each printed accumulator-reset readback **ENERGY=0 CHARGE=-1**.
  The existing sensor code warns on nonzero readback and returns success after
  readable registers; continuous conversion is a possible explanation, not a
  measured cause. These are retained sensor observations, not storage errors or
  induced-overflow/accumulator-reset proof.
- No storage error, invalid record, tail repair or corruption was observed.
  Torn/invalid-tail repair, mid-file/read-error refusal, the known open-for-scan
  diagnostic defect, storage-full behavior and crash/lease-expiry paths were
  not exercised by this healthy-log smoke. No physical fault was injected.
- All dumped epochs remain 0/time UNKNOWN. Retained elapsed values are not exact
  wall-clock coverage. The canonical sender normalizes serial lines and may
  discard pre-ACK chatter; this is not a complete raw serial/boot recording.

No firmware/source/test/dependency edit, commit or push was made. Documentation
and dated evidence were updated; no unnecessary unit tests/full software gate
were rerun for prose. Prior isolated 462/1 and combined 486/1 gates remain valid
within their recorded scopes. Fresh checks here: hardware protocol/completeness,
full decoded-prefix comparison, source hashes, checksum manifests and whitespace.

## 2026-09-29: Storage extraction reviewed and committed separately — hardware pending

The storage-only change was reviewed against **43c3baf** and committed separately
from capture-gap analysis, its pandas dependency changes, and older documentation/
evidence work. No firmware behavior was edited during this review. D-058 records
the boundary; this entry and D-058 accompany the four storage source/test files
in the commit. The other working-tree changes remain uncommitted and unpushed.

**Fresh move audit:** the bodies of autoStorageMount, autoStorageScan,
autoStorageTruncateToValid and autoStorageAppend, and the AutoLogScan layout, are
token-identical to the parent. Recombining autoStorageScanAndRepair with the
remaining autoStorageRecover body reproduces the original recovery logic exactly.
All 72 other old function bodies outside the five adapted callers are unchanged
(including moved functions). Expanding the new filesystem/timing accessors in
INFO, DUMP, CLEAR and the wake cycle also reproduces their original bodies.
Sequence authority, RTC state, scheduler, record bytes/CRC and command policy
remain in their prior owners. No newly introduced behavioral regression was found.

**Fresh isolated gate:** a temporary snapshot of parent 43c3baf plus only the
four storage source/test files ran the complete tools/check.sh: **exit 0, ALL OK;
462 passed, 1 xfailed**, pyright/py_compile clean, warning-free clean firmware
compile, IntelliSense **7/7**, shell syntax and whitespace passing. Flash is
**1,104,313 bytes**, globals **36,332 bytes**. The snapshot excludes the 24 host
analysis tests and pandas additions, so 462/1 is the isolated storage result;
486/1 remains the September 28 combined-working-tree gate. Its code bytes were
checked against the staged candidate. The known short-cadence overrun xfail
remains open. No extra tests or dependency changes were introduced in this review.

**Pre-existing diagnostic finding, not an extraction regression:** when the log
exists but open-for-scan fails, autoStorageScan prints an error and returns
without setting readError. Zero-initialized trailingBytes then lets recovery/
INFO print an INTACT tail despite the failed scan. The same body exists in
43c3baf. Sequence recovery still applies the NVS floor because validRecords is
zero, and no automatic tail repair runs on this outcome. Track explicit unreadable
scan status and an open-failure fixture as a separate correctness stage; do not
interpret an INTACT line as sufficient if any storage error was printed.

[Move audit and isolated gate](../logs/evidence/2026-09-29/README.md). No upload or serial
command was run. Experiment 3 was not reset or cleared. Storage hardware smoke
is deliberately the next session's bounded task: capture current VERSION and
healthy storage/experiment evidence before upload, use canonical tools/upload.sh,
and verify historical decoding plus new autonomous records afterward. Do not
inject corruption or begin another firmware extraction during that smoke.

## 2026-09-28: Capture-gap and initial-state reporting completed — host only

The user authorized continuation after the pending CODE-agent ownership question.
Fresh Git/source checks still showed main at **43c3baf**, nothing staged, and the
original positional-index fix only. Source/docs matched the September 25 baseline
apart from this task's checkpoint addendum; telemetry had grown. The previously
tested scratch draft was reviewed, applied to `tools/charger-transitions.py`
and tested in the canonical repo with `tests/test_charger_transitions.py`.
Storage/firmware/dependencies were preserved byte-for-byte against that baseline.
Nothing was committed, uploaded, reset or cleared; no serial command was issued.

The tool now reports initial state, post-gap state and contiguous edges separately
(D-059). Every capture segment is printed; gaps, experiment changes and repeated/
backward host timestamps restart persistence. Five classified samples per state
and a configurable 2 s inclusive maximum spacing are provisional analysis defaults.
Ambiguous rows break persistence; stale confirmed state cannot qualify a timed
edge. First supporting sample and fifth-sample confirmation are reported
separately, as is the adjacent host-sample bracket for a contiguous edge.
Input errors fail explicitly; context is clipped to the capture segment.

**Fresh CSV analysis:** 26,674 rows, all exp=3, from September 16
10:07:44.231779 to September 27 22:21:22.306909 (UTC-07:00). At defaults:
**81 segments / 80 gaps**, **2 contiguous transitions**, and **39 state
observations without a timed edge** (one initial, 38 after gaps). There are
46 UNKNOWN and 1,131 TRANSITION samples. Positive timestamp-spacing median is
1.000138 s. These counts describe captured evidence under the selected rule,
not physical charging-state truth or uninterrupted measurement coverage.

| Edge | Last preceding host sample | First supporting host sample | Confirmed at |
| --- | --- | --- | --- |
| ON-like | Sep 24 14:09:49.468777, -0.628 mA | 14:09:50.468071, +178.692 mA | 14:09:54.468872 |
| OFF-like | Sep 24 14:48:16.097899, +62.708 mA | 14:48:17.099301, -0.624 mA | 14:48:21.103139 |

These preserve the previously documented two contiguous edges; they do not add
LED correlation or identify causes. The old five-entry report conflated one
initial and two post-gap observations with those two edges. The corrected
report also exposes capture gaps where the observed state did not change.

**New capture since the earlier audit:** 77 morning rows on September 25,
08:27:12.636615–08:28:28.636627, follow a 49,337.521779 s gap. A further 165
rows on September 27, 22:18:38.306874–22:21:22.306909, follow a 222,609.670247 s
gap. Later capture does not establish overnight/weekend continuity or alter the
user's earlier statement that the host logger was stopped overnight.

**Validation actually run:** fresh `tools/check.sh` exit 0, **ALL OK** —
**486 passed, 1 xfailed**, pyright and py_compile clean, warning-free clean
Arduino compile, IntelliSense **7/7**, shell syntax and tracked whitespace pass.
The 24 new tests cover the reporting behavior with synthetic data and no device.
The existing short-cadence overrun is still the strict xfail. Flash is
**1,104,313 bytes**, globals **36,332 bytes**; storage is still unuploaded and
not hardware validated. The clean compile is not new board evidence.

Failures were not omitted: the first gate could not find `uv`/`uvx` on this
session's PATH (three Python steps exited 127; other steps passed). The installed
`/Users/afxjzs/.local/bin` was added for the rerun. A targeted type check then
found a nullable candidate-state annotation and an invariant list annotation in
the new test helper; using the current classified string and a read-only Sequence
resolved both before the final full gate. No dependency/tooling changes were made.

[Preserved report, final gate and input fingerprint](../logs/evidence/2026-09-28/README.md).
Next bounded stage: review/commit the existing storage extraction separately
from this host-analysis change, then a deliberate preservation-safe hardware
smoke. Exact board VERSION must be established then; Experiment 3 remains active.

## 2026-09-25: Full dump preserved; hardware identity and session continuity repaired

The user supplied the completed storage dump and the INA228 purchase-listing
screenshot. Originals are now preserved under
[evidence/2026-09-25/](../logs/evidence/2026-09-25/README.md), with SHA-256 checksums.
Temporary attachment paths are no longer the only source. This was documentation
and offline text validation only: no upload, serial command, code change, reset,
storage clear or physical hardware modification was performed by this session.

**Dump completeness:** 5,756 decoded record lines; indices 0–5755; sequences
**1412–7167**, consecutive and unique; **all Experiment 3**. The board reports
**Records read: 5756, invalid: 0**, followed by machine RESULT OK and a complete
END DUMP marker. Capture ended on quiet, not the 120-second cap. The observed
count is 156 more than the earlier morning INFO (5,600 / 7011), and 1,106 more
than the previous historical dump (4,650 / 6061). These are successive captures.
CRC validity is board-reported; this audit did not recompute binary CRCs from
rounded printed measurements. The text contains no firmware VERSION identity.

**Latest boot, 34:** 1,101 records, sequences **6067–7167**, all exp=3,
interval_ms=60004, epoch=0/time=UNKNOWN. Current snapshots range
**−0.671 to −0.559 mA**, voltage **13.071289–13.220507 V**, and every stored
interval charge is **−10 µAh**. FIRST_AFTER_BOOT is set for 6067 and clear for
the following 1,100 records, whose flags are zero. None of those snapshots
shows positive charging current. These observations do not prove why the
controller was off or that no brief charging occurred between snapshots.

Boot 34's first/last elapsed_ms are 78,678 / 78,441,614, a reported span of
about 21.77 hours. That is not an independently measured wall-clock duration
or uninterrupted autonomous coverage: the largest adjacent elapsed jump is
10,553,359 ms between sequences 6113 and 6114. Session/timing history must be
examined before interpreting gaps. Boot 34 also postdates the recorded boot-33
recovery smoke; no new firmware identity is inferred from the boot number.

**Hardware identity omission corrected:** the screenshot identifies the
**Ubxvamm storefront** and title containing **“5832 INA228.”** It does not
establish the actual PCB manufacturer or revision, and “5832” must not be
promoted to a revision. HARDWARE_WIRING now has a sourced hardware identity
register that distinguishes these facts. Existing Adafruit links are examples,
not verified documentation for the purchased board. The nominal R015 shunt in
the listing remains distinct from the project's 15.62 mΩ calibration.

**Session continuity:** root AGENTS.md now records operating rules and requires
maintenance of docs/CURRENT_STATE.md. INDEX links that compact current checkpoint;
the checkpoint links detailed canonical history and raw evidence. At every
meaningful handoff, record completed work, next action, ownership, validation
scope, unresolved questions and exact evidence paths. Refresh live Git state at
startup; do not treat the checkpoint's dated snapshot as a permanent fact.
The handoff does not waive the user's canonical-document read order.

## 2026-09-25: Supplied morning storage INFO — log advanced and tail intact

The user supplied a `tools/send.sh --wait LOGGER STORAGE INFO` transcript,
with terminal time approximately 08:28. The Python logger was not running.
The sender waited through at least 45 seconds of absent USB, caught
`/dev/cu.usbmodem1101`, and observed both machine ACK and RESULT OK. The
response completed on the 600 ms quiet threshold, not the capture cap.

| Reported field | Value |
| --- | ---: |
| Filesystem total | 1,441,792 bytes |
| Used / free | 413,696 / 1,028,096 bytes |
| Record size / log bytes | 72 / 403,200 bytes |
| Valid records | 5,600 |
| Oldest / newest sequence | 1412 / 7011 |
| Trailing bytes | 0 |
| Tail status | INTACT |
| Reported arithmetic capacity estimate | 14,279 more records / 9 days at 60 s |

The count and newest sequence are both **950 greater** than the last documented
4,650-record dump through sequence 6061. This establishes that the durable log
advanced while host CSV was absent for part of the elapsed time. INFO alone does
not identify every overnight record's experiment, duration, flags or readings,
or establish exact wall-clock coverage; a decoded dump is the next inspection.
The count equals 7011 − 1412 + 1, consistent with the reported sequence span.
The capacity estimate is filesystem free-space arithmetic, not a tested fill
limit. Reclamation/storage-full policy remains unimplemented.

The board was in its autonomous rendezvous and reported no host claim. The
transcript does not include VERSION, so no new firmware identity or validation
of the unuploaded storage extraction is inferred. No upload, reset, storage
clear or new hardware modification was performed in this documentation work.

## 2026-09-25: Transition report audit — overnight CSV coverage missing

The user reports leaving the setup running overnight and supplied a five-entry
`charger-transitions.py` report. Read-only inspection of the canonical repo's
CSV found **26,432 samples**, ending **2026-09-24 18:44:55.114836 −07:00**.
There are **no September 25 samples** in this file at this inspection. The
report lists state changes, not the capture end, so the report alone cannot
establish overnight coverage. **User clarification:** only the board stayed powered overnight; the Python
logger did not stay running. The missing overnight host CSV is therefore
expected, not evidence of a capture-tool failure. If autonomous mode remained
armed and writes succeeded, LittleFS records may cover time absent from host
CSV; no board query was made, so that coverage is not claimed. Experiment 3 was
not reset or cleared.

The five printed entries have different evidence:

| Reported time (UTC−07:00) | Evidence category |
| --- | --- |
| Sep 16 10:14:47 | First confirmed state in the tool's run; no confirmed preceding opposite state |
| Sep 23 09:55:29 | State after a capture gap from Sep 16; transition instant unknown |
| Sep 23 12:21:10 | State after a capture gap from 09:56:44; transition instant unknown |
| Sep 24 14:09:50 | Contiguous ON-like current edge, previously recorded |
| Sep 24 14:48:17 | Contiguous OFF-like current edge, previously recorded |

After the September 24 OFF-like edge, the inspected CSV contains **9,445
samples**, all Experiment 3, through 18:44:55. Current ranges from **−0.684 to
−0.552 mA**, voltage from **13.109375 to 13.312891 V**. The largest adjacent
capture gap in this suffix is **1,640.236589 seconds** (about 27 minutes).
These describe the observed samples, not uninterrupted coverage or a proof that
no intervening state changes occurred. Capture-gap handling remains absent
from the analysis script despite the earlier green software gate.

**Cause hypotheses, proposed by the user:** panel disconnected, insufficient
sunlight, or battery full/controller charge completion. These are useful
candidates, not an exhaustive diagnosis or identified causes of these edges.
Keep measured output state separate from an inferred reason, with explicit
UNKNOWN/ambiguous results. Time of day can inform a hypothesis; it does not
measure light at this window, establish that a cable is connected, or prove
battery state of charge. Several limiting conditions can coexist. The reason
for the 14:48 OFF-like edge remains unverified.

For later characterization, correlate continuous INA samples with timestamped
LED observations, panel/connection observations and known changes. The exact
SUNER model should be established before using its LED codes as labels.
SUNER's [BC-20W product documentation](https://sunerpower.com/products/bc-20w-poly-solar-battery-charger)
distinguishes charging, full, error and no-output indications; that is a model
example, not confirmation of the installed unit or its state.

**Additional user observations, September 25:** the panel remained connected
throughout the overnight run. It is currently cloudy and the user reports no
charging; no precise LED color/state or time was supplied. Disconnection is not
a supported explanation for this reported overnight setup. The user proposes
that a mostly topped-up battery may not trigger charging under cloudy conditions
when a lower battery would. This is a plausible interaction between available
panel power and controller restart/charge-demand behavior, not a measured rule.
The exact controller model, restart threshold/hysteresis and panel-side power
remain unverified. Time of day and cloud observations must not be promoted to
measured input-power availability or battery-full proof.

Next: inspect durable storage for overnight records before another upload,
correct gap/initial-state reporting, then close the existing storage
review/commit/hardware-smoke stage before adding firmware inference. Current
autonomous records use epoch 0 / UNKNOWN time; sequence and session-relative
fields do not by themselves give exact night/dawn wall-clock event times, and
wake snapshots cannot resolve a transition between wakes to one second.
No firmware or Python source was changed in this audit.

## 2026-09-24: Continuation audit — current tree and continuous OFF-like transition

Read-only source/git/CSV inspection, followed by documentation corrections. No
firmware or analysis code was edited, no gate was rerun, and no upload or serial
command was issued. Experiment 3 was not reset or cleared.

**Repository snapshot:** `main` at `43c3baf` (`Fix durable log recovery and
reconcile project docs`), with nothing staged. Recovery is now committed;
`eba3b5d-dirty` remains the identity of the previously supplied hardware smoke,
not a claim that clean `43c3baf` was uploaded. Storage extraction remains in the
working tree: `storage.h`/`storage.cpp` are untracked, with sketch and recovery
harness changes. Concurrent SUNER work includes `tools/charger-transitions.py`,
`pyproject.toml`/`uv.lock` changes adding pandas, and documentation changes.
The latest reported extraction result is 462 passed / 1 xfailed, 7/7 translation
units, with its full gate red on the concurrently introduced pyright error.
The CODE agent owns the Python correction and capture-gap handling; this audit
does not certify their completion or a new gate result.

**Subsequent coding-agent addendum, supplied by the user:** the pyright failure
is resolved by enumerating row positions and using `.iloc` consistently instead
of mixing index labels and positions. The agent reports byte-identical output
against its pre-fix sample capture (5 transitions, 85 lines), and a complete
`tools/check.sh` pass: exit 0, ALL OK; 462 passed / 1 xfailed; pyright,
py_compile, warning-free clean firmware compile, IntelliSense 7/7, shell syntax
and whitespace all pass. Reported flash is 1,104,313 bytes and globals 36,332
bytes. This supersedes the red-gate snapshot above. These are supplied test
results, not another gate run by this audit.

Source inspection confirms the positional fix. **Capture-gap handling remains
unimplemented:** the loop does not check timestamp spacing or experiment
boundaries before carrying candidate/confirmed state forward, and initial
state acquisition is still printed as a transition. The all-green gate does not
establish continuity-aware analysis. Storage extraction remains uncommitted and
not uploaded; its hardware smoke is still owed.

**CSV evidence, independently read from `data/samples.csv`:** all rows below
belong to Experiment 3. Times are host capture times on 2026-09-24, UTC−07:00;
they bracket observed changes at roughly one-second resolution, not exact
controller switching instants.

| Host time | Current (mA) | Voltage (V) | Observation |
| --- | ---: | ---: | --- |
| 14:09:49.468777 | -0.628 | 12.989648 | Before ON-like step |
| 14:09:50.468071 | +178.692 | 12.994336 | First positive sample |
| 14:09:51.469187 | +262.236 | 12.998047 | Positive charging current continues |
| 14:48:15.098515 | +68.748 | 13.318555 | Before OFF-like step |
| 14:48:16.097899 | +62.708 | 13.318555 | Last positive sample in inspected capture |
| 14:48:17.099301 | -0.624 | 13.312891 | First near-zero/reverse sample |
| 14:48:18.099522 | -0.644 | 13.311719 | Near-zero/reverse current continues |
| 14:48:19.103015 | -0.636 | 13.310547 | Near-zero/reverse current continues |

The OFF-like step spans **1.001402 seconds** between adjacent captured samples,
so it is not a before/after comparison across a capture gap. The inspected
suffix contains **1,728 samples through 15:17:04.967150**, ranging from
**−0.684 to −0.564 mA**. This supersedes the kickoff's latest-known statement
that charging continued and no continuous OFF transition had been captured.
It establishes a sustained current change, not its cause or the controller's
internal cutoff rule. A matching LED observation has not yet been supplied.

The user additionally reports approximately **3.5 minutes** from connecting the
series resistor load to charging resuming. This refines the earlier "few
minutes" report; the load-attachment timestamp and resistor temperature were
not independently measured here. The resistor heat observation remains
qualitative. Production charger-output detection is intended to operate directly
on INA readings in firmware; CSV analysis is characterization only. Thresholds,
persistence and sleep/sampling integration remain undecided.

**Documentation drift corrected:** PROJECT's next-stage paragraph still placed
LittleFS in the sketch; BACKLOG's recovery entry still put scan/truncation there;
STORAGE_SYNC_DESIGN called 429/1 the latest gate and its lifecycle diagram still
put DIAG_ALRT after CHARGE/ENERGY. The diagram now matches the implemented order.
Older dated lab entries retain their at-the-time status and are superseded by
D-058/current module inventory for storage extraction. No new hardware validation
is claimed.

## 2026-09-24: SUNER addendum — first contiguous charger-ON transition

**OBSERVED, as supplied by the user:** this adds timing and sample-analysis
results to the earlier resistor-load experiment below. The analysis run and
physical observations were supplied; this documentation stint did not rerun the
tool, perform a new hardware test, upload or access serial. Source inspection
confirms the analysis tool's current behavior and its capture-gap limitation.

### Load timing and heat — approximately 3.5 minutes

The two **6 Ω / 50 W aluminum resistors in series** formed a nominal **12 Ω**
load. At 12.9–13.2 V, the calculated load remains **1.075–1.100 A**, about
**14 W total / 7 W each**, as detailed in the earlier entry; these are nominal
calculations, not measured resistor-branch current.

After only **about 3.5 minutes**, the resistors were **SCALDING / VERY HOT in
free air**, and the battery had been pulled down enough for the SUNER to resume
its **blinking red charging indication**. The load was disconnected early for
both reasons: the desired transition had occurred and the resistors were
extremely hot. The original plan was up to 15 minutes, not the observed duration.

No resistor case temperature was measured. A 50 W aluminum-resistor rating does
not mean it stays cool at approximately 7 W in free air; chassis/heatsink
assumptions matter. No precise temperature or free-air power limit is inferred.

### First directly observed NOT_CHARGING → CHARGING transition

The logger was running continuously before the load was connected. The supplied
`samples.csv` analysis identified this contiguous transition on **2026-09-24**:

| Timestamp as supplied | Voltage (V) | Current (mA) | Power (mW) | Analysis state |
| --- | ---: | ---: | ---: | --- |
| 2026-09-24 14:09:47.468 | 12.998438 | −0.608 | 7.9104 | NOT_CHARGING |
| 2026-09-24 14:09:48.468 | 12.994141 | −0.624 | 8.1024 | NOT_CHARGING |
| 2026-09-24 14:09:49.469 | 12.989648 | −0.628 | 8.1792 | NOT_CHARGING |
| 2026-09-24 14:09:50.468 | 12.994336 | +178.692 | 2322.8032 | CHARGING |
| 2026-09-24 14:09:51.469 | 12.998047 | +262.236 | 3408.5504 | CHARGING |
| 2026-09-24 14:09:52.467 | 12.996289 | +261.340 | 3396.4544 | CHARGING |

The excerpt supplies no UTC offset; these timestamps are reproduced without
conversion. The first positive charging sample is **14:09:50.468**, following
−0.628 mA at 14:09:49.469, then +262.236 mA one sample later. The change is
observed between adjacent approximately one-second samples; the exact physical
switching instant within that interval is not established. Analysis-state labels
are not new firmware telemetry fields.

The SUNER **blinking red LED was observed during the charging regime**, strongly
correlating positive INA current with controller output. No precisely timestamped
LED edge was supplied. This is direct evidence for an INA-based **CHARGER_OUTPUT**
state (`CHARGING`, `NOT_CHARGING`, `UNKNOWN / TRANSITION`), not proof of
**SOLAR_AVAILABLE**. Near-zero output can still mean full-battery/controller
cutoff, nighttime, panel disconnection or controller fault.

**At the supplied observation cutoff the SUNER was STILL CHARGING.** Today's
continuous CHARGING → NOT_CHARGING transition had not yet been captured. Capture
that OFF edge and correlate it with the LED before claiming both directions are
characterized. This is a dated observation, not a live board-status assertion.

**Later evidence, preserved separately:** the concurrent continuation audit above
records an OFF-like current step at **14:48:17.099301 −07:00**. A read-only CSV
spot-check in this stint confirms +62.708 mA at 14:48:16.097899 followed by
−0.624 mA, with 1,728 near-zero/reverse samples through 15:17:04.967150
(−0.684 to −0.564 mA). This supersedes the brief's missing-current-edge status,
not its missing LED correlation. The cause/controller state is still unverified
by a matching LED observation; both directions are not fully characterized.

### Characterization tool, capture gaps and future firmware

[tools/charger-transitions.py](../tools/charger-transitions.py) now exists and
the supplied run found the ON transition above. It analyzes `data/samples.csv`
with provisional current/voltage classification and consecutive-row persistence,
then prints state changes and surrounding samples. These are **characterization
tools**, not the intended production dependency. Future firmware would infer
charger output directly from INA228 readings on the ESP32, after characterizing
ON/OFF shapes, thresholds, hysteresis, persistence/debounce, noise and ambiguous
regions. No firmware thresholds or final algorithm have been decided.

**OPEN tool issue: consecutive rows need not be contiguous in time.** Source
inspection shows no elapsed-time gap check or separate initial-state category.
Historical capture included CHARGING around **2026-09-23 09:56**, then no samples
until roughly **12:21**, when the first later samples were NOT_CHARGING. A state
change occurred somewhere in the gap; its exact time is **UNKNOWN**. Neither
the first post-gap sample nor the first state in a file is a precisely observed
transition. Add distinct `INITIAL STATE`, `STATE AFTER CAPTURE GAP` and
`OBSERVED CONTIGUOUS TRANSITION` reports, requiring sufficiently contiguous
evidence on both sides of an observed edge. Gap and persistence criteria remain
to be characterized; no numeric maximum gap is chosen here.

While the ESP32 is **awake**, successive INA readings can support high-resolution
transition detection. In normal autonomous **deep sleep**, the INA keeps operating
but the ESP is not continuously evaluating samples. Without a future hardware
alert/wake mechanism, state can only be assessed at normal wake/sample points;
the wake snapshot does not establish second-level timing of a change during
sleep. INA228 alert-pin wake is a possible later investigation, **not implemented
or decided**. The INA-OFF power-test variant is a separate mode that deliberately
stops INA measurement.

Placement remains **INFERRED, NOT YET PHYSICALLY TRACED**: the nominal ~1.07 A
load did not appear as an approximately −1 A INA shift, while positive controller
charge current was observed. This suggests controller charging-path current,
not total battery net current; no terminal/polarity map is established. Wiring
is unchanged. See [HARDWARE_WIRING.md](HARDWARE_WIRING.md) and the
[characterization backlog](BACKLOG.md#characterize-suner-charger-state-inference-from-samplescsv).

## 2026-09-24: SUNER controller restart under a temporary resistor load

**OBSERVED, as reported by the user:** this records an already completed bench
experiment and the supplied telemetry excerpts. No new hardware test or CSV
analysis was performed by this documentation stint. Exact event timestamps,
restart/cutoff thresholds and a complete OFF transition are not established by
these excerpts. Existing firmware-validation history remains separate.

### Purpose and temporary load

The battery had been near the SUNER controller's full/cutoff-like state:
approximately **13.1 V, −0.6 mA**, and **8 mW magnitude** at the INA228. A
temporary resistive load was applied to lower battery voltage and observe the
controller restarting charge. The logger was already running before the load
was applied, so continuous telemetry captured the transition.

Two newly arrived **6 Ω, 50 W aluminum-housed power resistors** were connected
**in series**, giving a nominal **12 Ω** load. Exact attachment points and
high-current routing were not supplied as a physical trace.

**CALCULATED, not measured load current or temperature:** for 12.9–13.2 V across
the nominal 12 Ω series pair, `I = V/R` and `P = V²/R` give:

| Quantity | At 12.9 V | At 13.2 V |
| --- | ---: | ---: |
| Load current | 1.075 A | 1.100 A |
| Total dissipation | 13.8675 W | 14.5200 W |
| Dissipation per equal 6 Ω resistor | 6.93375 W | 7.2600 W |

Thus the expected load was roughly **1.07–1.10 A**, **14 W total**, or **7 W per
resistor**. These estimates use nominal resistance; they are not INA readings
of the resistor branch.

**THERMAL OBSERVATION:** the resistors became **VERY HOT in free air**. No case
temperature was measured. The practical lesson is that a 50 W headline rating
does not mean a resistor stays cool at lower power: aluminum power resistors
can become very hot without substantial heat sinking/chassis mounting. This
experiment does not establish the particular parts' permitted free-air power.

The SUNER returned to its **blinking red charging indication within a few
minutes**. The resistors were then disconnected; the intended transition had
occurred, so there was no need to continue the planned 15-minute load.

### Charging telemetry and behavior after removing the load

Blinking red was visually observed as the controller's charging indication,
correlated with approximately **12.883 V, +154–160 mA and 1.99–2.05 W**.
A representative interval excerpt was:

```text
CSV_DATA,3,273,60.000,12.884375,154.916000,1995.993600,...
```

The ellipsis denotes omitted fields; this is not a complete CSV row.

After load removal the controller remained blinking red. Voltage rose from
roughly **13.2154 V to 13.2205 V**, while current remained **+163–167 mA** and
power **2.16–2.21 W**. Representative supplied samples:

| Voltage (V) | Current (mA) | Power (mW) |
| ---: | ---: | ---: |
| 13.215430 | 164.432 | 2173.0304 |
| 13.216211 | 163.880 | 2165.8752 |
| 13.218945 | 166.128 | 2196.0192 |
| 13.220117 | 166.932 | 2206.8352 |
| 13.220508 | 166.316 | 2198.7840 |

Charging persisted while voltage rose after the temporary load was removed,
consistent with the controller remaining latched in active charging. This does
not determine its internal control logic or numeric restart/cutoff hysteresis.
The live chart showed the major load/controller transition and a later narrow
dip associated in time with physically checking the LED. **The narrow dip's
cause is unknown**; temporal association is not a causal explanation.

### OBSERVED INFERENCE FROM TELEMETRY — current-path interpretation

The nominal resistor load was approximately 1.07 A. If the INA228 measured
total net battery current including that load, connecting it would be expected
to produce an approximately −1 A shift, other contributions being comparable.
Instead, reported current during charging was approximately **+150–170 mA**.

This strongly indicates that the present INA228 placement measures the
**SUNER/controller charging path rather than total net battery current including
the temporary resistor branch**. It is an **observed inference from telemetry**,
not a fully traced wiring fact. Exact controller/shunt/battery polarity and
routing remain OPEN pending physical setup/photo/wiring trace. See
[HARDWARE_WIRING.md](HARDWARE_WIRING.md#current--high-current-measurement-path).

### Charger-output inference — promising, not implemented or fully characterized

The observed full/cutoff-like regime near **−0.6 mA** and active charging near
**+155–167 mA** differ by more than two orders of magnitude in current magnitude.
The simultaneous blinking-red indication strongly correlates with the positive
charging regime. A future classifier could describe **CHARGER_OUTPUT** as
`CHARGING`, `NOT_CHARGING`, or `UNKNOWN / TRANSITION`.

Do not call that result **SOLAR_AVAILABLE**. Near-zero controller-output current
could mean a full battery/controller cutoff in bright sun, nighttime, a
disconnected panel, or controller fault. This current alone cannot distinguish
those causes. The narrower question is: **is the SUNER currently delivering
charging current?** It is not a battery state-of-charge measurement either.

**No production thresholds are decided.** Illustrative future logic could use
hysteresis and persistence: sustained current well above zero suggests charging;
near-zero/slight reverse current suggests not charging; intermediate/noisy
values could mean transition or retention of the prior state. This is a proposal,
not an implemented detector or a chosen threshold policy.

Next, analyze `data/samples.csv` for sustained current step changes, using a
rolling median or similar smoothing and a configurable delta threshold. Report
timestamps and before/after current, voltage and power, with surrounding samples
for inspection. The OFF transition is **not yet fully captured/correlated**:
compare the LED transition to not-charging with the matching INA-current step
before declaring an INA-only classifier fully characterized. The work is tracked
in [BACKLOG.md](BACKLOG.md#characterize-suner-charger-state-inference-from-samplescsv).
No formal architecture decision or firmware/UI feature was added.

## 2026-09-24: Hardware validation addendum — clean record format and working-tree recovery

**OBSERVED, as supplied by the user:** the results below record two completed
board runs. This documentation reconciliation inspected current source/tests;
it did not build, upload, access serial, rerun `tools/check.sh`, or perform a new
hardware test. Older entries retain their status at the time of each stint;
this addendum supersedes their pending-hardware status, within the limits below.

### Clean record-format image — eba3b5d

`tools/upload.sh` successfully built and uploaded clean revision **`eba3b5d`**.
Firmware reported version **`0.3.0-dev`**, revision **`eba3b5d`**, and build ID
**`solar-logger-protocol-ack-v3`**. Experiment 3 survived. Historical records
decoded and new autonomous records appended with valid CRCs. AutoRecord stayed
**72 bytes, version 1**, with no format change or migration.

The earlier extraction gate was **387 passed, 1 xfailed**. Its deployed golden
Experiment 3 fixture (`seq=4445`, CRC `0xFB25DA73`) establishes CRC coverage of
bytes 0–67, CRC at offset 68, and the `esp_rom_crc32_le(0, ...)` / IEEE-zlib
convention. That host fixture and the post-upload records are separate evidence.

Storage progressed from **4,528 valid records / newest sequence 5939** to
**4,530 / 5941** after two autonomous wakes. The subsequent dump included:

| Sequence | Boot | Experiment | Interval (ms) | Flags | CRC |
| ---: | ---: | ---: | ---: | --- | --- |
| 5940 | 32 | 3 | 60004 | `0x4[FIRST_AFTER_BOOT]` | `0x57D6B79C` |
| 5941 | 32 | 3 | 60004 | `0x0[none]` | `0x8E93D0A2` |
| 5942 | 32 | 3 | 60004 | `0x0[none]` | `0x1E771662` |

Final dump: **Records read: 4531; invalid: 0**. Trailing bytes were **0** and
tail status **INTACT**. These successive snapshots are not conflicting totals:
another record was appended before the final dump.

**Record format is IMPLEMENTED, SOFTWARE-TESTED and HARDWARE-VALIDATED.** The
smoke covers old-record compatibility, ESP32 CRC/validation, new record creation
and append, sequence progression, FIRST_AFTER_BOOT set then cleared, and
Experiment 3/log integrity. Telemetry also ran in this smoke-validated image;
the supplied evidence does not claim an exhaustive comparison of all CSV forms.

### Storage-recovery working-tree image — eba3b5d-dirty

The subsequent upload contained the uncommitted recovery fix and reported
**`eba3b5d-dirty`**. This is a **storage-recovery working-tree build based on
`eba3b5d`**, not a clean commit containing that fix. Version and build ID remain
`0.3.0-dev` / `solar-logger-protocol-ack-v3`.

| Observation | Record size | Valid records | Oldest sequence | Newest sequence | Trailing bytes | Tail status |
| --- | ---: | ---: | ---: | ---: | ---: | --- |
| Immediately after upload | 72 bytes | 4644 | 1412 | 6055 | 0 | INTACT |
| After additional autonomous wakes | 72 bytes | 4649 | — | 6060 | 0 | INTACT |

Final dump included **6057, 6058, 6059, 6060 and 6061**, all with **boot=33,
exp=3, interval_ms=60004**, valid CRCs and normal flags. Its summary was
**Records read: 4650; invalid: 0**. Existing records continued decoding, new
records continued appending, Experiment 3 remained intact, and the tail stayed
INTACT. No corruption was injected into the live log.

**Recovery is corrected, software-tested and NORMAL-PATH HARDWARE-SMOKE
VALIDATED.** The smoke exercised a healthy log only. Torn-tail repair,
complete-invalid-tail repair, mid-file corruption refusal and read-error
refusal remain **host/synthetic tested, not exercised on physical hardware**.
Any later destructive/recovery hardware test requires a disposable/test log;
do not inject corruption into Experiment 3.

### Latest reported software gate and remaining boundaries

The latest coding-agent gate after recovery, **not rerun by this doc stint**:

| Check | Reported result |
| --- | --- |
| pytest | **429 passed, 1 xfailed** |
| pyright | clean |
| py_compile | pass |
| Arduino clean compile, `--warnings all` | pass |
| IntelliSense | **6/6 project translation units** |
| Shell syntax | pass |
| `git diff --check` | pass |

The six units are `connection.cpp`, `ina228.cpp`, `nvs_persistence.cpp`,
`record_format.cpp`, `telemetry.cpp`, and `solar-logger.ino`. Discovery remains
automatic. The one xfail is the existing **OPEN short-cadence autonomous overrun
defect**, not a regression or a fix.

Recovery added **42 tests**, without changing pre-existing tests, executing the
firmware scan/recover/truncate/info functions against a file-backed LittleFS
harness and linking real `record_format.cpp`. The coding agent reported mutation
failures of **12** tests for restoring the first-invalid `break`, **8** for
removing destructive-repair refusal, and **3** for removing read-error handling.
Reported flash: **1,102,453 → 1,103,995 bytes (+1,542)**; globals **36,332 bytes,
unchanged**. These are that gate's build figures, not new measurements here.

DIAG_ALRT ordering is fixed, source/regression-tested and hardware-smoke
validated: validate INA → DIAG_ALRT → CHARGE → ENERGY. **A real accumulator
overflow has not been induced; INA_ACCUM_OF has not been observed SET from one.**
The hardware smoke does not validate that overflow branch. Pre-fix records are
not retroactively qualified; tethered overflow qualification and MATHOF interval
semantics remain open.

There is still no operator mid-file repair/quarantine command, no resync after
non-record-sized mid-file insertion (such as `[10][8 junk bytes][11]`), and no
physical read-error observation. CURRENT/CHARGE remain signed; POWER/ENERGY are
unsigned magnitudes, so running energy is not a signed/net energy balance.

The previous correctness blocker before LittleFS extraction is resolved within
the stated limits. **Next structural candidate: extract LittleFS/durable-storage
mechanics**, preserving D-057 and its remaining edge cases. It has not been
extracted. Sync/ACK/reclamation, storage-full policy, time sync, BLE/iOS/server,
manual SYNC circuitry and IBS integration remain unimplemented; current wiring,
future regulator design and open BMW trunk topology are unchanged.

## 2026-09-24: One corrupt record no longer discards the valid records after it - NOT hardware validated

A correctness fix to durable-log boot recovery. Nothing was uploaded, no serial
port was opened, and no board was touched. The live Experiment 3 log was never
read, written or used as a test fixture: every damaged log in this work is
synthetic and lives in a pytest temporary directory.

**This is not a hardware result.** The image was compiled and the host tests were
run. The DIAG_ALRT reorder from 2026-09-23 and the record-format extraction from
earlier on 2026-09-24 still owe their own hardware checks, and this stint does
not supply them or establish a newer board state.

### The defect, measured rather than inferred

`autoStorageScan()` walked the log forward and stopped at the first record that
failed validation. `scan.trailingBytes` then became every byte from there to end
of file, and `autoStorageRecover()` handed that to `autoStorageTruncateToValid()`
at every cold boot and every RTC-loss wake.

For a torn tail that is correct, which is why it never showed on hardware. For a
bit flip in the middle of the log it deletes every good record after the damage.

A host harness was built that compiles the firmware's own
`autoStorageMount/Scan/TruncateToValid/Recover` and `printStorageInfo` out of the
sketch and runs them against a LittleFS made of real files, linking the real
`record_format.cpp` so `autoRecordValid()` is the actual validator. Run against
the **pre-fix** code:

| Log laid down | Bytes in | Bytes out | Sequences surviving |
| --- | ---: | ---: | --- |
| `[seq 10][seq 11][seq 12]` | 216 | 216 | 10, 11, 12 |
| `[seq 10][seq 11][40 loose bytes]` | 184 | 144 | 10, 11 |
| `[seq 10][seq 11][bad seq 12]` | 216 | 144 | 10, 11 |
| **`[seq 10][bad seq 11][seq 12][seq 13]`** | **288** | **72** | **10** |
| **`[seq 10][bad seq 11][seq 12][bad seq 13]`** | **288** | **72** | **10** |

The first three rows are the intended behavior. The last two are the defect:
sequences 12 and 13 were complete, CRC-correct records, and boot recovery deleted
them. `LOGGER STORAGE INFO` on the same log reported **1** valid record when
three existed, and `Tail status: INVALID RECORD DETECTED`, so an operator
deciding what to do was told less good data was at stake than actually was.

The loss was counted and printed. It was still automatic, irreversible, and it
happened before anyone read the message.

### What changed

Recovery now distinguishes four damage cases instead of collapsing them, and
`printStorageInfo()` reports them separately. The rule and its reasoning are
D-057; Section 11 of STORAGE_SYNC_DESIGN.md has been reconciled with the code.

- `autoStorageScan()` scans the whole file, counting every invalid record, the
  first one's offset, and how many valid records are stranded past it.
- `trailingBytes` now means what an automatic repair would discard — the unbroken
  run of invalid records at the end, plus a partial remainder — and `keepBytes`
  what it would keep.
- A valid record after an invalid one means nothing is discarded. The refusal is
  enforced inside `autoStorageTruncateToValid()` as well as in its caller.
- A short read while scanning sets `readError` and repairs nothing. An I/O fault
  is not a torn tail, and it is the one case where what is damaged is not even
  known. It is staged in the tests by telling the firmware the log is 72 bytes
  longer than it is, which is the only way to make a real file read short.

Re-run after the fix, the same five logs:

| Log laid down | Bytes in | Bytes out | Sequences surviving |
| --- | ---: | ---: | --- |
| `[seq 10][seq 11][seq 12]` | 216 | 216 | 10, 11, 12 |
| `[seq 10][seq 11][40 loose bytes]` | 184 | 144 | 10, 11 |
| `[seq 10][seq 11][bad seq 12]` | 216 | 144 | 10, 11 |
| `[seq 10][bad seq 11][seq 12][seq 13]` | 288 | **288** | 10, 11, 12, 13 |
| `[seq 10][bad seq 11][seq 12][bad seq 13]` | 288 | **288** | 10, 11, 12, 13 |

The first three are byte-identical to before. The last two discard nothing and
say so.

### Sequence authority

`logIntact` already required `invalidRecords == 0`, so a preserved mid-file
corruption keeps the NVS reservation floor in force, unchanged from D-023. The
log's own candidate is now one past the last valid record in the whole file: for
the fourth row above it is 14, where the pre-fix code returned 11 while deleting
the records that had used 12 and 13.

### Evidence and its limits

`tests/test_characterization_storage_recovery.py`, 42 tests, all executing the
firmware's own compiled functions. The gate is green:
**429 passed, 1 xfailed** (387 + 1 before this work; the xfail is the unrelated
short-cadence autonomous overrun defect). Flash went from 1,102,453 to 1,103,995
bytes, **+1,542**, both 84% of `app0`. Global variables are unchanged at 36,332
bytes: `AutoLogScan` is a stack local, and the five fields added to it cost no
static memory.

The tests were confirmed to fail against the behavior they replace. Restoring the
scan's `break` at the first invalid record turns **12** of them red; keeping the
full scan but removing the refusal and the trailing-run arithmetic turns **8**
red. They are load-bearing in both directions.

**What this does not show.** No board has run this code. The only hardware
evidence about recovery remains the 2026-09-23 `d017f7d` snapshot of an
*undamaged* log, and no corrupt record has ever been observed on this hardware.
When hardware validation is requested it should confirm normal valid-log
behavior only — an intact Experiment 3 log scanning, decoding and appending as
before — unless a separate disposable log or isolated storage is created first.
Corruption must not be injected into the live log.

### Left unsolved, deliberately

Damage that is not a whole number of records throws every later record off the
72-byte grid, so nothing after it validates, no valid suffix is detectable, and
it is discarded as a torn tail. `[seq 10][8 junk bytes][seq 11]` goes in at 152
bytes and comes out at 72, before and after this fix alike. Recovering it needs a
resynchronization policy this project does not have; it is recorded in BACKLOG.md
and pinned as-is by a test that says so.

There is also no operator command to repair mid-file damage once it is reported.
Adding one changes the command protocol and its build ID, so it was kept out of a
correctness fix.

## 2026-09-24: Record format extracted into a module - NOT hardware validated

Structural extraction only. The deployed 72-byte durable record and its CRC
helpers moved out of `solar-logger.ino` into `record_format.h` and
`record_format.cpp`. No behavior change was intended and none was found. Nothing
was uploaded, no serial port was opened, and no board was touched.

**This is not a hardware result.** The image was compiled and the host tests
were run. The DIAG_ALRT reorder from 2026-09-23 still owes its own hardware check
of the overflow path, and this stint does not supply it or establish a newer
board state.

### What moved

Into `record_format.h`: `AUTO_RECORD_MAGIC`, `AUTO_RECORD_VERSION`, the eight
record flag bit values and the time-quality mask, `AUTO_EXPERIMENT_UNKNOWN`, the
two snapshot-unread sentinels, the packed `AutoRecord` struct, its
`static_assert(sizeof(AutoRecord) == 72)` and `AUTO_RECORD_SIZE`.

Into `record_format.cpp`: `autoRecordCrc()`, `autoRecordValid()` and
`autoRecordSnapshotUnread()`, with `#include "esp_rom_crc.h"`, which the sketch
no longer needs because `autoRecordCrc()` was its only user.

### What deliberately did not move

`printAutoRecord()` and `autoTimeQualityName()`. They interleave flag
interpretation with `Serial` formatting and comma bookkeeping for the
`LOGGER STORAGE DUMP` transcript, which is an output format rather than the
record format; moving them would have made this a formatting rewrite. Both are
token-identical to `HEAD` and still in the sketch.

Also unmoved, and verified as such: LittleFS mount, append, scan, truncation and
tail recovery; the twelve `RTC_DATA_ATTR` declarations; `reserveSequenceBlock()`
and the NVS sequence high-water mark; `AUTO_SEQ_BLOCK`; `AUTO_LOG_PATH`; the
autonomous scheduler and wake cycle; host session logic. A test asserts the
module names no `LittleFS`, `Preferences`, `Serial`, `RTC_DATA_ATTR`, `millis`,
`esp_sleep`, `AUTO_SEQ_BLOCK` or `AUTO_LOG_PATH`, and contains no `flags |=`.

### The move audit (D-047)

Run as a scratch script over the tokenizer in `tests/firmware_source.py`, the
same way earlier stages did. Three claims, each checked:

- **Reconstruction.** Deleting 132 lines from `HEAD`'s sketch and inserting one
  `#include "record_format.h"` reproduces the new sketch **token for token**:
  18,371 tokens to 18,080, and 7,088 lines to 6,963.
- **Nothing lost.** All 292 tokens that left the sketch are present in the two
  new files, counted as a multiset.
- **Nothing rewritten.** The three moved function definitions, the struct's
  members and its packed head are token-identical to `HEAD`. So are the two
  functions that stayed.

The moved regions were also diffed as raw bytes against the originals, and are
byte-identical including indentation and comments.

**One comment was edited, stated here because the token audit strips comments and
cannot see it.** The note beside `AutoLogScan` said it was declared "next to the
record", which the move made false. The substantive half of that comment — that
the Arduino preprocessor emits generated prototypes ahead of the first function
definition, so a type named in a prototype must exist by then — is unchanged.

### What was strengthened, and why that is not scope creep

`sizeof(AutoRecord) == 72` moved unchanged, but on its own it cannot see two
same-width fields swap places, a signed field turn unsigned, or a widened field
paid for by a narrowed neighbor. All three keep the size at 72, and all three
make Experiment 3's log unreadable. A file move is exactly when those mistakes
happen, so the header now asserts every field's `offsetof`, width and signedness,
and that `crc32` is the last field so the sealed range really is bytes 0–67.

Both additions were verified by construction rather than assumed:

| Injected fault | `sizeof == 72` | New assertions |
| --- | --- | --- |
| `int32_t avg_current_uA` to `uint32_t` | passes | 3 failures |
| `boot_id` swapped with `session_elapsed_ms` | passes | 6 failures |

### Tests

54 added, all in `tests/test_characterization_record.py`. **No existing test was
changed.** `firmware_source.py` reads every sketch file as one, so the 86 record
tests written before the move kept passing across it without an edit, which is
what that design is for.

The new tests fall in three groups:

- **The boundary.** The helpers are defined in `record_format.cpp` and nowhere
  else; the struct and every frozen constant are in `record_format.h` and not in
  the sketch; each frozen constant is defined **exactly once** across all sketch
  files; the printing helpers stayed in the sketch; the module holds no policy,
  state or I/O; every field's compile-time offset and signedness assertion is
  present in source.
- **The module's own code, compiled and run.** `record_format.cpp` itself — not
  an extracted copy — is compiled on the host and run against the real
  Experiment 3 record. It reproduces `0xFB25DA73`, accepts that record, rejects a
  wrong magic and a wrong version **even after the CRC is recomputed over the
  corrupted bytes** (so the checks are proved individually rather than hidden
  behind a failing checksum), rejects all 72 single-byte corruptions, and
  recognizes the snapshot-unread sentinels.
- **`printAutoRecord()`, which had no test at all before.** It now reproduces the
  verbatim `LOGGER STORAGE DUMP` tail the board printed for `seq=4445`, decodes
  all six flag names with their comma bookkeeping, names each of the four
  time-quality values including the unassigned `RESERVED`, and names an unread
  snapshot instead of printing 4294.967295 V.

**One substitution, stated rather than buried.** `esp_rom_crc32_le()` lives in
the ESP32 mask ROM and cannot be linked on the host, so the harness supplies its
own. On its own that would prove nothing. It is asserted equal to the CRC the
**board** stored for `seq=4445`, so the chain is stub = zlib = what the ROM did on
hardware. What the substitution does not weaken: the struct's layout on a real
compiler, the 68-byte covered range, the CRC offset, the magic and version
checks, and every byte of the transcript line.

### Gate

`tools/check.sh`, before and after.

| | Before | After |
| --- | --- | --- |
| pytest | 333 passed, 1 xfailed | **387 passed, 1 xfailed** |
| pyright | 0 errors | 0 errors |
| py_compile | pass | pass |
| ESP32 compile, `--clean --warnings all` | pass, no warnings | pass, no warnings |
| IntelliSense translation units | 5 | **6** |
| shell syntax | pass | pass |
| whitespace | pass | pass |
| | `ALL OK` | `ALL OK` |

The xfail is the same one: the short-cadence autonomous overrun defect. It was
not touched, suppressed or converted.

`record_format.cpp` needed **no** change to `tools/` or `.vscode/`. The gate
discovered it and verified its editor entry by compiling it with exactly those
flags (D-048), which is the third module in a row for which that held.

### Flash and globals, with the 2 bytes accounted for

| | Before | After |
| --- | ---: | ---: |
| Program storage | 1,102,455 | 1,102,453 |
| Global variables | 36,332 | 36,332 |

Both images were rebuilt from clean into separate build paths, and the before
figure reproduced `HEAD`'s exactly. A per-symbol comparison of the two ELFs finds
**one** symbol changed size: `autoRecordValid()`, 96 bytes to 94.

Its instruction sequence is identical. The single difference is the call to
`autoRecordCrc()`, an 84-byte backward jump in both images, encoded as a 4-byte
`jal` in the old layout and a 2-byte compressed `c.jal` in the new one. The
distance did not change, so this is GNU ld's RISC-V relaxation reaching a
different fixed point after the new section placement, not a code change. The
other two call sites of `autoRecordCrc()` are far away and stayed 4-byte `jal` in
both.

Globals unchanged is the measurement that matters for the boundary: the module
owns no state.

### Recommended hardware smoke test

Unchanged behavior means the check is that nothing regressed, and the sharpest
available evidence is that the existing log stays readable:

1. `tools/upload.sh`
2. During the 15-second cold-boot maintenance window: `LOGGER STORAGE STATUS`.
   Expect Experiment 3 preserved, the same record count as before the upload plus
   any new autonomous records, `0` invalid records, trailing bytes `0` and tail
   status `INTACT`.
3. `LOGGER STORAGE DUMP`. Every pre-existing record must still validate and print
   as before; a layout or CRC regression would show as invalid records rather
   than as a crash.
4. Let one autonomous wake complete and confirm a new record appends and
   validates, with `seq` continuing to advance.

A real INA accumulator overflow is still not induced by this, so
`INA_ACCUM_OF` remains unobserved on hardware.

## 2026-09-24: Current bench wiring documented — no new hardware measurement

[HARDWARE_WIRING.md](HARDWARE_WIRING.md) now owns the user-reported current
logic wiring and Mermaid diagram. USB powers the XIAO; its 3V3 powers INA228
logic. The loose VUSB jumper has no connected far end and should be removed.
Source inspection confirms D4/SDA, D5/SCL and 400 kHz, not physical routing.

No existing canonical diagram was found. Exact SUNER/shunt/battery polarity
routing remains OPEN pending physical setup/photo capture, so no complete
measurement-path schematic or SVG was added. Earlier AA/VUSB power tests
retain their dated conditions; PROJECT now labels their reproduction
procedure explicitly as historical. Future regulator design and BMW trunk
topology remain unresolved. This stint changed documentation only, with no
build, upload, serial access or new hardware validation.

## 2026-09-23: Installed architecture decisions and modularization-plan correction — documentation only

Recorded from the user's architecture brief, not from a hardware experiment.
No firmware, tests or tooling were edited by this documentation stint; no build,
upload or serial operation was performed, and no commit was made. Existing
coding-agent changes and results remain separate from these decisions.

D-052 settles V1 electrical attachment at the designated under-hood charging/
jump points with the logger in the glove box/cabin, with neither an IBS/LIN tap
nor a separate ignition wire for vehicle-on detection. The later IBS phase
expects a trunk enclosure, but trunk electrical topology and F22 signal access
remain open research; no authoritative BMW answer was found in the repository.

D-053 selects BLE/iPhone as the installed path: phone durable save before ACK,
phone-supplied time and phone-to-server upload. The ESP has no home-server or
home-Wi-Fi dependency. D-054 retains manual physical SYNC permanently; exact
vehicle-on wake and a possible vehicle-active mode remain future design work.
None of these installed features is claimed built or measured.

D-055 replaces the broad proposed `auto_state` grouping with separate record/
CRC, LittleFS mechanics, sequence-authority, retained-state and scheduling/
session concepts. Exact future filenames/APIs remain undecided. The old graph
analysis is labeled historical rather than presented as proof of this plan.

The coding-agent entry below remains the authority for its source tests and
gate result. The DIAG_ALRT fix was source-tested, gate green, not uploaded and
not hardware validated at that report. Record format/version did not change:
version 1, 72 bytes, CRC covers 0–67 and is stored at 68, with the real
Experiment 3 record matching IEEE/zlib CRC-32. That deployed-record evidence is
not hardware validation of the reorder. `record_format` remains unextracted.
The tethered overflow gap, MATHOF interval limits, signed-charge versus unsigned
magnitude-energy/net-energy question, corrupt-tail behavior, overrun xfail and
unimplemented sync/ACK/reclamation/full-storage policy remain open.

Documentation drift corrected here: the obsolete telemetry-in-progress
paragraph, USB-first installed clock priority, optional-only manual access,
and the combined `auto_state` plan. BMW wiring questions were added without
answering them. Historical measurements and the coding-agent report below are
preserved.

## 2026-09-23: DIAG_ALRT read order confirmed WRONG and FIXED; golden Experiment 3 record proves the 72-byte layout - record-format extraction NOT started

**No hardware was touched.** Nothing was uploaded or committed, Experiment 3 was
not reset, storage was not cleared, and no serial port was opened. **No overflow
was induced on hardware, so the fixed path has never been seen to set the flag.**

One runtime behavior change was made, after it was authorized explicitly: the
`DIAG_ALRT` read order fix described below. The `record_format` extraction was
NOT started.

### What this stint was for, and why it stopped

The stint was to extract the 72-byte durable record format and its CRC into a
`record_format` module, after first resolving the "overflow-read ordering"
question raised by the 2026-09-23 documentation audit. Its contract said that a
real correctness defect stops the extraction and gets reported on its own,
because a behavior fix must not ride inside a file move.

The question turned out to be a real defect, so the extraction stopped and was
reported. **The extraction was not started** — no `record_format.h` / `.cpp`
exists. The ordering fix itself was then authorized explicitly, as its own change,
and applied; the file move was not.

### The defect

`runAutonomousWakeCycle()` read the accumulators and then read the flag that
qualifies them. The read destroys the flag.

Order in the pre-fix source, at commit `79519df`, by in-function offset rather
than line number so the reference survives the fix that follows:

| Order | What happened |
| ---: | --- |
| 1 | `readAccumulatedCharge_mAh()` → reads CHARGE (0Ah), **clears CHARGEOF** |
| 2 | `readAccumulatedEnergy_mWh()` → reads ENERGY (09h), **clears ENERGYOF** |
| 3 | `readRegister16(REG_DIAG_ALRT, diag)` → reads 0Bh, **too late, always 0** |
| 4 | sets `AUTO_FLAG_INA_ACCUM_OF`, which could never be reached |

Current line numbers after the fix: `DIAG_ALRT` at
[solar-logger.ino:3977](../Arduino/solar-logger/solar-logger.ino#L3977), the flag
at [:3989](../Arduino/solar-logger/solar-logger.ino#L3989), CHARGE and ENERGY at
[:4006](../Arduino/solar-logger/solar-logger.ino#L4006)-4007.

### The evidence

The in-repo evidence was circular: the only statement of the clear-on-read
behavior was the comment in `ina228.h` whose correctness was the question, and it
cited "Table 7-9", which is a different register. The datasheet was therefore
fetched and read directly: TI INA228 SLYS021A, January 2021, revised May 2022,
§7.6.1.12, Table 7-16, "DIAG_ALRT Register Field Descriptions". Quoted verbatim:

| Bit | Field | Clear condition |
| --- | --- | --- |
| 11 | ENERGYOF | "Clears when the ENERGY register is read." |
| 10 | CHARGEOF | "Clears when the CHARGE register is read." |
| 9 | MATHOF | "Must be manually cleared by triggering another conversion or by clearing the accumulators with the RSTACC bit." |

Register addresses were checked against the same document's register map
(`ina228.cpp:30-31`, `ina228.h:75`): ENERGY = 9h, CHARGE = Ah, DIAG_ALRT = Bh.
All three match.

### Consequence

Every autonomous record written by the pre-fix firmware reports "no accumulator
overflow", with a correct CRC over that claim, whether or not an overflow
occurred. Nothing errored and nothing was logged — the flag read as clean because
the evidence was cleared microseconds earlier. This is a wrong belief, not a
crash, which is the class that is found at the worst possible time.

Experiment 3's 3,272 stored records are all affected in this respect. Their
charge and energy values are unaffected: the accumulators themselves are read
correctly and before any reset (D-020), and the 40-bit registers are nowhere near
overflow at roughly 1.5 mAh per minute. The defect is that the record cannot
*attest* to that, not that the data is known to be wrong.

`MATHOF` is genuinely reachable — a read does not clear it. Separately, the
datasheet says MATHOF clears on "triggering another conversion", and this
firmware runs the INA228 continuously, so `AUTO_FLAG_INA_MATHOF` qualifies
approximately the latest conversion rather than the whole interval. That is a
measurement-semantics question, it is newly recorded, and the reorder does not
address it.

### A second finding

`readRegister16(REG_DIAG_ALRT, ...)` at :3990 is the **only** `DIAG_ALRT` read in
the firmware. `closeMeasurementInterval()`
[:2786](../Arduino/solar-logger/solar-logger.ino#L2786) — every tethered interval
close — never reads it, so `CSV_DATA` rows in `data/intervals.csv` carry no
overflow qualification at all. A gap rather than a false claim, since the CSV
schema has no overflow column.

### The fix

`readRegister16(REG_DIAG_ALRT, diag)` moved above `readAccumulatedCharge_mAh()`
and `readAccumulatedEnergy_mWh()` in `runAutonomousWakeCycle()`. One call moved.
The flag-setting logic is byte-for-byte the same, the record format is untouched,
and no version was bumped.

Nothing is lost by reading it earlier, and this was checked rather than assumed:
reading `DIAG_ALRT` clears none of the three bits (Table 7-16 lists clear
conditions only for the threshold bits and CNVRF, and only when ALATCH = 1), the
firmware never writes `DIAG_ALRT` so ALATCH stays at its reset value 0
(Transparent), and a grep found no reader of CNVRF or any threshold bit anywhere
in the firmware.

**Two side effects, recorded rather than absorbed:**

1. If both the `DIAG_ALRT` read and the accumulator reads fail in one wake, the
   two error lines now print in the opposite order. Cosmetic, in a double-failure
   path.
2. The `[TIMING]` breakdown bucket `INA validate+accum read` is now
   `INA validate+diag+accum`. The `DIAG_ALRT` read used to fall in the *snapshot*
   bucket, because `tAccumRead` was sampled before it. So that pair of timing
   numbers is **not comparable across this change**, and the label was updated to
   say what it now covers rather than left to mean something other than it says.

**What the fix does not do.** It does not make the flag trustworthy. It makes it
reachable. An overflow has never been induced on this board, so `INA_ACCUM_OF` has
never been observed set, before or after. And stored Experiment 3 records keep
their `INA_ACCUM_OF = 0` from the broken path, where **zero means "not measured",
not "no overflow"**.

### Tests added for the ordering

`test_characterization_record.py` now pins, inside `runAutonomousWakeCycle()`,
that `DIAG_ALRT` is read before both accumulators; that the two flag-setting
bodies are unchanged; and that D-020's read-before-reset still holds.

The order is the correctness, so it is asserted rather than commented. **The guard
was verified to have teeth:** run against the pre-fix committed source, the
`DIAG_ALRT` call sits at in-function offset 2450 against CHARGE at 1905 and ENERGY
at 1969, so both new assertions fail on it. A guard that passes on the bug it
describes is worse than none.

### What changed here

- `solar-logger.ino` — the reorder, the timing label, and comments. The comment at
  the read site used to say the ordering was safe; it now says the order is the
  correctness and points at the test.
- `ina228.h` — corrected "Table 7-9" to Table 7-16, quoted the real clear
  conditions, and stated the obligation any future accumulator reader inherits.
- `tests/test_characterization_record.py` — golden record fixture, binary
  compatibility tests, ordering guards.
- `STORAGE_SYNC_DESIGN.md` §4 wake ordering and §5 record table and flag table,
  `DECISIONS.md` D-020, `BACKLOG.md`, `PROJECT.md`, `INDEX.md`.

### Gate result

`tools/check.sh`: **ALL OK** at every stage — baseline, after the docs/comment
pass, and after the fix.

| | baseline | after docs+comments | after the fix |
| --- | --- | --- | --- |
| pytest | 249 passed, 1 xfailed | 249 passed, 1 xfailed | **333 passed, 1 xfailed** |
| flash | 1,102,455 (84%) | 1,102,455 | 1,102,455 |
| globals | 36,332 (11%) | 36,332 | 36,332 |

The one `xfail` throughout is the known short-cadence autonomous overrun, unrelated.
84 tests were added, all host-only.

**On the flash figure.** The docs+comments pass could not change the image, because
comments do not reach the code generator; identical size there confirms it was a
comment-only edit. The fix stage is different: code moved and a string literal grew
by one character, so **the image is certainly not identical even though its size
is** — the size is quantized by alignment padding, which absorbed the difference.
Equal size is not equal bytes, and this row should not be read as though it were.

### Not done

The `record_format` extraction was **not started**; no `record_format.h` / `.cpp`
exists. `closeMeasurementInterval()` still reads no overflow flag at all. MATHOF's
continuous-conversion semantics and the charge/energy sign asymmetry are both
recorded in BACKLOG and unaddressed. Nothing was uploaded, so the board is still
running the pre-fix image.

### What the record-format extraction will need — established while scoping it

Recorded so the next stint does not rediscover it. All four were read out of the
source, not assumed.

**The characterization tests survive the move without edits.**
`tests/firmware_source.py` reads every file Arduino compiles —
`SOURCE_SUFFIXES = {.ino, .h, .hpp, .c, .cpp}` in the sketch directory plus
`src/` recursively — so the 23 record assertions in
`test_characterization_record.py` and the `static_assert(sizeof(AutoRecord) == 72,`
assertion at `test_autonomous_accounting.py:302` keep finding the struct after it
moves into `record_format.h`. That is the property the module was built for.

**Two of the requested binary-compatibility tests were blocked, then unblocked
within the stint — see the golden-record section below.** They needed real record
bytes, which `LOGGER STORAGE DUMP` does not print directly. A dump line was then
supplied from the board, and it turned out to be sufficient: the dump prints every
field except `magic` and `version` (fixed for any valid record), and prints the
snapshot fields scaled but at exactly microunit resolution, so all 72 bytes are
recoverable and the printed `crc=` checks the recovery. Both tests now exist.

### Golden record from Experiment 3 — the 72-byte layout and the CRC convention are now PROVEN

A real `LOGGER STORAGE DUMP` line was captured from the deployed board and is now
a test fixture. This is the most durable result of the stint.

```text
[STORAGE] #3033 seq=4445 boot=26 exp=3 elapsed_ms=58629900 interval_ms=60004
V=13.051367 I_mA=-0.616 P_mW=8.025 T_C=18.695 dQ_uAh=-10 dE_uWh=129
Qsum_uAh=380771 Esum_uWh=5602351 time=UNKNOWN epoch=0 flags=0x0[none]
crc=0xFB25DA73
```

Rebuilt from `FROZEN_LAYOUT` as little-endian packed bytes, the 68 covered bytes are:

```text
a5b501005d11000063cf0500000000002f7c550000000000030000001a0000000c9f7e03
00000000 64ea0000 e725c700 98fdffff 591f0000 07490000 f6ffffff 81000000
```

and the full 72 bytes end `...8100000073da25fb`, the stored CRC little-endian at
offset 68.

**`zlib.crc32` of those 68 bytes is `0xFB25DA73` — exactly what the board stored.**
It matched on the first attempt, with no search over layout variants.

**Why one number settles so much.** The CRC covers all 68 preceding bytes, so it
reproduces only if every field's offset, width, signedness and byte order matches
the firmware that wrote it, the struct is genuinely packed with no padding, and the
covered range really is bytes 0..67. Any one of those being wrong changes the
checksum. Source reading could establish the *declared* layout; this establishes
the *deployed* one.

**The CRC convention is settled, and the documentation's claim was right.**
`esp_rom_crc32_le(0, buf, len)` is standard IEEE 802.3 CRC-32 — reflected
polynomial `0xEDB88320`, initial value `0xFFFFFFFF`, final XOR `0xFFFFFFFF` —
which is `zlib.crc32`. The ROM function pre-inverts its seed internally, which is
why a `0` seed there corresponds to no seed in zlib. Three other plausible
conventions were computed and all three disagree with the board:

| Convention over bytes 0..67 | Result |
| --- | --- |
| reflected 0xEDB88320, init 0xFFFFFFFF, xor 0xFFFFFFFF (= `zlib.crc32`) | **0xFB25DA73 — matches** |
| init 0, xor 0 (no inversion) | 0xEBF2B4DE |
| init 0xFFFFFFFF, xor 0 | 0x04DA258C |
| init 0, xor 0xFFFFFFFF | 0x140D4B21 |

The previous entry in this stint listed "IEEE 802.3" as an unverified claim
inherited from the docs. It is now verified, and the distinction mattered: three
of the four candidates are wrong.

**Tests added** to `tests/test_characterization_record.py`, host-only, no firmware
code moved: the 72-byte length, the golden CRC, CRC stored little-endian at offset
68, magic/version against the frozen constants, **all 68 covered bytes individually
mutated and each one breaking the CRC**, a flipped stored CRC failing validation,
a guard that the CRC does *not* cover its own field, the snapshot fields traced
back to the printed transcript so the fixture is auditable rather than fitted, and
a check that the two genuinely-negative fields are negative.

That last one matters: a signed field flipped to unsigned packs identically for
positive values, so a golden record of all-positive numbers would not catch it.
`avg_current_uA = -616` and `interval_charge_uAh = -10` on the real board, so the
CRC test does catch it.

**Flag-name decoding cannot move mechanically.** `printAutoRecord()`
[solar-logger.ino:3320](../Arduino/solar-logger/solar-logger.ino#L3320) interleaves
the flag tests with `Serial.print()` and comma bookkeeping, so there is no
decode step to lift out. Extracting the vocabulary means rewriting it into a
buffer-returning helper, which risks the output vocabulary and order the
extraction is supposed to preserve. The clean split is struct, constants,
`autoRecordCrc()`, `autoRecordValid()` and `autoRecordSnapshotUnread()` into
`record_format`, leaving `printAutoRecord()` in the sketch as the console concern
it is.

## 2026-09-23: Telemetry extracted into a module - NOT hardware validated

**No hardware was touched.** Nothing was uploaded or committed, Experiment 3 was
not reset, storage was not cleared, and no serial port was opened. Every result
below is a host test, a source audit, or a compile. **This image has not run on
the board.**

The fourth modularization stage, and stage 5 of the order in
[BACKLOG.md](BACKLOG.md). The machine-readable CSV formatting moved into
`Arduino/solar-logger/telemetry.h` and `telemetry.cpp`. Runtime behavior is
intended to be unchanged, and nothing below found a change. The boundary is
D-051: the module owns how a line is spelled, and never when one is emitted.

### What moved, and what deliberately did not

Six telemetry responsibilities were found in the sketch. Five moved whole, each
renamed to say which line it builds. One was split, because it mixed
measurement policy and acquisition with the row construction:

| Split | Moved to the module | Stayed in the sketch |
| --- | --- | --- |
| `printLiveSample()` | the `CSV_SAMPLE` row construction, as `telemetryPrintSample()` | the `sleepPowerTestRunning` suppression (D-012), the `readSensor()` call and its error line, and the derivation of `elapsed_seconds` from `completedInterval` and `millis()` |

| Was | Is now |
| --- | --- |
| `printCsvHeader()` | `telemetryPrintHeader()` |
| `printCsvRow()` | `telemetryPrintInterval()` |
| `printExperimentStartEvent()` | `telemetryPrintExperimentStart()` |
| `printExperimentResumeEvent()` | `telemetryPrintExperimentResume()` |
| `printSleepTestEvent()` | `telemetryPrintSleepTestEvent()` |

`CSV_HEADER` moved with `CSV_DATA`, although the module table gave the row only
the three data lines: the header names the data row's fields and the two are one
fact. The blank line and the `[CSV] Machine-readable interval logging enabled.`
line that have always preceded it moved with it, so both call sites emit the
same three lines as before.

Nothing else moved. The interval close, the experiment lifecycle, the power-test
state machine, the accounting-suspension predicate, and the command protocol all
stayed. `CMD_ACK`, `CMD_RESULT` and the bounded protocol writer were not touched,
and the 100 ms protocol deadline and `Serial.setTxTimeoutMs(0)` are unchanged.

### Four hidden globals became parameters

`printCsvRow()` read `experimentId`, `runningCharge_mAh` and
`runningEnergy_mWh` out of the sketch. All three event printers read
`experimentId`, and `printExperimentResumeEvent()` also read
`completedInterval`. Those four globals are all passed in now. No global was
exported, and no `extern` was added. This is the D-050 rule applied again.

The two row types, `TelemetrySample` and `TelemetryInterval`, list their members
in wire order. They repeat the four measurement fields rather than taking a
`SensorReading`, which keeps the module's only dependency on Arduino, as the
module table requires. The alternative was thirteen positional arguments, seven
of them `double`.

### The move was audited as a move

Same method as the three earlier stages, over the tokenizer in
`tests/firmware_source.py`, comments stripped:

- The sketch's tokens equal `HEAD`'s with one 388-token run deleted - exactly
  the five function definitions and nothing else - plus the `CSV_SAMPLE` print
  chain inside `printLiveSample()`, and 10 call sites renamed with their new
  explicit arguments. The only insertion that is not an argument is
  `#include "telemetry.h"`.
- **Four of the five moved functions have token-identical bodies**:
  `telemetryPrintHeader`, `telemetryPrintExperimentStart`,
  `telemetryPrintExperimentResume` and `telemetryPrintSleepTestEvent`. The last
  is identical despite gaining a parameter, because the body already printed
  `experimentId` in that position.
- **`telemetryPrintInterval` is identical after substituting the struct field
  for the former global or loose parameter**, and nothing else.
- **Every emitted `Serial` call matches, in order, with its precision
  argument**: 3, 2, 4, 6 and 26 calls across the five, and 12 for the
  `CSV_SAMPLE` chain. The one difference in the whole comparison is a name: the
  sketch's local `experimentElapsedSeconds` is the struct's `elapsedSeconds`.
  Same position, same precision, same value, still computed in the sketch.

The audit script was a scratch file for this stint and is not in the repository.

### The tests

`tests/test_characterization_telemetry.py`, 23 tests, freezing the wire format.
It compiles the module's real source on the host against a recording `Serial`,
runs it, and asserts the exact lines for one fixed set of inputs; then it feeds
those same lines to `app/solar_logger.py`'s own `parse_sample()`,
`parse_interval()` and `parse_event()`.

**The golden lines were captured from the monolith before the move.** The suite
was written first, run green against unmodified `HEAD` source, and then run
green again after the extraction with `GOLDEN` and `INPUTS` untouched. Three
things in the file did change with the move, and all three are plumbing rather
than contract: which function names the harness extracts, how the driver calls
them, and one constant, `TELEMETRY_SOURCE`, naming the file every CSV line is
built in. A fourth change is an assertion that legitimately follows the code -
the interval close now builds a `TelemetryInterval` before emitting it, and the
test pins that ordering against the running totals and the NVS checkpoint.

One limit is stated in the file rather than left implicit: the stand-in
`Serial` carries a copy of `Print::printFloat` from the ESP32 core 3.3.11,
because Arduino does not format a double the way `printf` does - it adds half of
the last requested place and truncates digit by digit. The copy differs from the
device only where `unsigned long` width matters, which is past the `ovf` cutoff
both apply at 4294967040.0, and every asserted value is far inside it.

Telemetry had **no test coverage of any kind** before this stint: no test in the
suite mentioned a CSV prefix or any of the six functions.

**The existing suite was not edited.** 226 passed and 1 xfailed before the move
and after it; the run with the new module is 249 passed, 1 xfailed. The xfail is
the unrelated overrun defect.

### The gate

`tools/check.sh` reported ALL OK before the move and after it.

```text
pytest             249 passed, 1 xfailed        (226 + 23 new)
pyright            0 errors, 0 warnings, 0 informations
py_compile         PASS
firmware compile   clean, --warnings all, no warnings
intellisense       5 translation units, all verified
shell syntax       PASS
whitespace         PASS
```

**The editor found the new module by itself**, the second time the D-048
contract has been exercised by a module created after it was written.
`git diff tools/ .vscode/` is empty.

```text
[INTELLISENSE] Project translation units found (5):
[INTELLISENSE]   connection.cpp
[INTELLISENSE]   ina228.cpp
[INTELLISENSE]   nvs_persistence.cpp
[INTELLISENSE]   solar-logger.ino
[INTELLISENSE]   telemetry.cpp
[INTELLISENSE]   telemetry.cpp: compiles cleanly: ALL OK
                 (direct includes: telemetry.h, Arduino.h)
```

### Where the 118 bytes went

Measured with `size -A` and `nm -S` on both images, built from a clean worktree
at `d017f7d` and from the current tree. Flash 1,102,337 -> 1,102,455.

**Global variables are unchanged at 36,332 bytes**, which is what "the module
owns no mutable state" looks like in the link map. `.flash.rodata` is unchanged
too, so no diagnostic string was duplicated. `.flash.text` +118 is the whole
delta; every other changed section is debug info, which is not flashed.

`.flash.text`, per symbol. This build has no LTO, so a call that used to be
inside one translation unit can no longer be inlined:

| Group | Delta |
| --- | ---: |
| the four functions that moved whole and unchanged | 0 |
| `printCsvRow` 458 -> `telemetryPrintInterval` 360 | -98 |
| `printLiveSample` 346 -> 216, plus `telemetryPrintSample` 180 | +50 |
| call sites now passing what they used to leave implicit | +166 |
| **total** | **+118** |

- `telemetryPrintHeader` (56), `telemetryPrintExperimentStart` (50),
  `telemetryPrintExperimentResume` (80) and `telemetryPrintSleepTestEvent` (108)
  are each **byte-for-byte the same size** as the function they replaced.
- **`telemetryPrintInterval` got 98 bytes smaller.** Reading thirteen fields
  through one struct pointer beats three globals at absolute addresses plus
  seven loose parameters.
- `closeMeasurementInterval()` +128 is that struct being filled on the stack
  before the call, which is where those 98 bytes went and a little more.
- The remaining +38 is six call sites passing `experimentId` or
  `completedInterval` explicitly instead of the callee loading the global:
  `setup()` +12, `stopAllPowerTests()` +8, `enterSleepPowerTestDeepSleep()` +8,
  `armSleepPowerTest()` +8, `resetExperiment()` +4, `armWifiPowerTest()` -2.

### Firmware identity unchanged

```text
[FIRMWARE] Version:  0.3.0-dev
[FIRMWARE] Build ID: solar-logger-protocol-ack-v3
```

A move changes no command, record, cadence rule or protocol, so the version
policy calls for no bump. The revision that `tools/upload.sh` injects will
differ, and that is what identifies this source.

### Hardware acceptance - PENDING, nothing below has been run

This stage changes what reaches `app/solar_logger.py`, so the check is whether
the host still parses what the board sends. After a deliberate
`tools/upload.sh`, send each command on its own and expect exit 0 from each.
Everything after "PREDICTED" is read from the source, not observed.

1. The smoke test in [BACKLOG.md](BACKLOG.md). PREDICTED: a real revision hash,
   `Tail status: INTACT` with at least as many records as before, and
   `CMD_RESULT,...,OK` for HOLD, KEEPALIVE and RELEASE.
2. Stage 5's own check, with `uv run python app/solar_logger.py` attached.
   PREDICTED: `CSV_HEADER` at boot with its thirteen field names unchanged, one
   `CSV_SAMPLE` per second parsed without a field-count warning, and one
   `CSV_DATA` at the interval close. A `[WARNING] CSV_... field count is wrong`
   from the host is the failure this stage would produce, and it would be loud.
3. `data/samples.csv` and `data/intervals.csv` gain rows under their **existing**
   headers. PREDICTED: no header-mismatch exit from `open_csv_file()`, which
   fails closed on a changed schema (D-005). That check is the host's own and
   was not modified.
4. One `CSV_EVENT`. PREDICTED: `EXPERIMENT_RESUME` at boot carrying the current
   experiment id and completed-interval count, written to `data/events.csv` with
   the interval number in the `detail` column.
5. Compare one captured `CSV_DATA` row against a row captured before the upload.
   PREDICTED: same field count, same column order, same decimal places in each
   column - 3 for elapsed seconds, 6 for V/mA/mW and the averages, 4 for
   temperature, 9 for the charge and energy columns.

## 2026-09-23: Documentation audit and supplied hardware validation addendum

**Evidence, not a new hardware run.** This audit read the attachments in
[Audit BMW Logger Project](chatgpt-conversation://6a972711-ff64-83e8-ad38-d78bc4c0e22a)
and compared them with repository revision `d017f7d`, current source, tests and
tooling. No serial port was opened, no upload was performed, Experiment 3 was
not reset and storage was not cleared. Older entries below retain their
original end-of-stint status; “pending” there is historical and is superseded
only by the specific observations recorded here. Discovery-time source line
links can move during modularization; named functions remain the lookup key.

### Observed in supplied hardware transcripts

- INA228 image: clean `4a096d9`; this supplies transcript evidence for the
  earlier reported smoke-test addendum. Connection image: clean `8776ba0`,
  `0.3.0-dev`, build ID `solar-logger-protocol-ack-v3`. The connection trace
  shows NONE before claim, USB claimed on HOLD, session status, successful
  KEEPALIVE and RELEASE, and USB release before sleep.
- NVS image: clean `d017f7d`, same version/build ID. After upload, `STATUS`
  restored Experiment 3, completed interval 52, charge **6.068727 mAh**, energy
  **83.561586 mWh**, with accounting ACTIVE.
- Its storage snapshot: **3,272 valid 72-byte records**, log **235,584 bytes**,
  sequences **1412–4683**, **0 trailing bytes**, tail **INTACT**. Filesystem:
  **1,441,792 total / 245,760 used / 1,196,032 free bytes**. The displayed
  16,611-record / 11-day remainder is a free-space estimate, not a fill test or
  a live reading. Storage was not full at this observation.
- Follow-up POWER TEST STATUS: neither test armed; INA228 continuous conversion.
  HOLD, KEEPALIVE and RELEASE each received machine ACK and `CMD_RESULT,...,OK`.
  RELEASE closed a real **1.757 s** interval and wrote schema **2**, experiment
  **3**, interval **53**, charge **6.068421 mAh**, energy **83.565454 mWh**,
  followed by `NVS CHECKPOINT SAVED SUCCESSFULLY`.
- RELEASE armed the 250 ms grace, delivered its OK result, and reported
  **59,750 ms** remaining before sleep; the host classified the following
  disconnect as expected. This confirms the corrected D-046 RELEASE path on
  hardware. It is a firmware-reported commanded remainder, not an independent
  measurement of actual sleep duration or clock accuracy.
- Next autonomous status: ON, armed YES, running YES, cadence **60 s**, boot
  **29**, RTC valid YES, next sequence **4746**, reserved through **4804**, and
  new-record experiment context **3**. Tethered `STATUS` on that unclaimed
  timer wake printed zero experiment/interval/totals with accounting SUSPENDED.
  Source explains why: the early wake path reads experiment context separately
  and bypasses the tethered checkpoint load. Those zeroes do not establish NVS
  loss, nor does this status independently reread the new interval-53 checkpoint.
- Claimed-wake traces include measurement-work timings: **51.438 ms** on
  `8776ba0` and **42.376 ms** on the NVS follow-up. These are individual reported
  spans, not an unattended wake budget, a before/after performance comparison,
  or a breakdown of LittleFS costs.

The small negative charge change on interval 53 accompanies measured negative
current; monotonically increasing charge was an incorrect acceptance criterion.
Energy rose. The snapshot establishes preservation of Experiment 3 at that time,
not its current interval or totals while the device continues running.

### What remains unproven or unimplemented

No explicit no-keepalive lease-expiry trace was found in the reviewed
attachments. That path shares tested scheduler arithmetic, but the RELEASE
observation does not prove it independently. Pending failure-injection checks,
long-session timing, full storage, RTC drift, and full unattended wake/power
characterization remain open. The NVS restore/write smoke does not exercise NVS
failure handling or a cold-boot reread of the newly saved interval 53.

Sync, storage ACKs, acknowledged-sequence state, reclamation, ring storage and
SET_TIME are absent. The 10-second-cadence boundary/accumulator overrun issue
remains the one strict `xfail`. The two NVS read-default defects remain open.
A separate DIAG_ALRT ordering contradiction is recorded as a source question in
BACKLOG, not a proven hardware overflow failure.

### Local validation and documentation changes

Fresh host run in this audit: `PYTHONDONTWRITEBYTECODE=1 .venv/bin/python -B -m pytest -p no:cacheprovider` — **226 passed, 1 xfailed in 38.48 s**. This includes
the real IntelliSense scratch-sketch scenario; it does not open serial. No new
tests or runtime changes were made.

The supplied `d017f7d` transcript, rather than a new full gate run by this audit,
records `tools/check.sh` ALL OK: 226 passed / 1 xfailed, pyright 0 errors / 0
warnings, py_compile pass, clean Arduino compile with `--warnings all`, shell
checks and whitespace pass. IntelliSense discovered and compiled four project
units automatically: `connection.cpp`, `ina228.cpp`, `nvs_persistence.cpp`, and
`solar-logger.ino`. Check build: 1,102,337 bytes flash, 36,332 bytes globals;
revision-injected upload build: 1,102,281 bytes flash, same globals.

The canonical validation command remains `tools/check.sh`; uploads use
`tools/upload.sh`, serial commands use `tools/send.sh`, and editor staleness is
checked with `tools/intellisense.sh --check`. KEEPALIVE/RELEASE never wait;
explicit `--wait` on either is refused. A queued command through the running
logger has no completion result in the sender, even if its exit status is 0.

The audit corrects current status, old echo-based instructions, partition usage,
record-field semantics, storage-full wording and historical proposal labels in
INDEX, PROJECT, DECISIONS, BACKLOG, STORAGE_SYNC_DESIGN and README. Firmware
identity remains **0.3.0-dev / solar-logger-protocol-ack-v3**; documentation does
not remove the firmware's dev suffix. Telemetry extraction is in progress in a
separate task; this audit neither edits its code nor declares it complete.

## 2026-09-23: NVS persistence extracted into a module - NOT hardware validated

**No hardware was touched.** Nothing was uploaded or committed, Experiment 3
was not reset, storage was not cleared, and no serial port was opened. Every
result below is a host test, a source audit, or a compile. **This image has not
run on the board.**

The third modularization stage, and stage 1 of the order in
[BACKLOG.md](BACKLOG.md). The mechanics of ESP32 nonvolatile storage moved into
`Arduino/solar-logger/nvs_persistence.h` and `nvs_persistence.cpp`. Runtime
behavior is intended to be unchanged, and nothing below found a change.

The module is named for NVS rather than "persistence" because this board has
three durable stores with different promises - NVS, RTC-retained memory, and the
LittleFS record log - and only the first one moved. The boundary is D-050.

### What moved, and what deliberately did not

Fifteen NVS responsibilities were found in the sketch. Thirteen functions moved
whole. Two were split, because each mixed a typed NVS access with a decision
that is not the module's to make:

| Split | Moved to the module | Stayed in the sketch |
| --- | --- | --- |
| `loadAutonomousSettings()` | the two-key read, as `loadAutonomousConfig()` | the cadence range check, with `AUTO_INTERVAL_SECONDS_MIN` / `_MAX` (D-018) |
| `reserveSequenceBlock()` | the write, as `saveSequenceHighWater()` | `AUTO_SEQ_BLOCK`, and the RTC mirror `rtcAutoSeqHighWater` |

`ensureSequenceReservation()` stayed whole: it decides *whether* a reservation
is needed. Nothing about which of the durable log tail and the NVS reservation
is authoritative moved (D-023).

### One semantic difference, found by the audit and guarded

`loadAutonomousSettings()` used to `return true` early when the namespace would
not open, which **skipped** the range check below it. That early return is now
inside `loadAutonomousConfig()`, so it comes back to the caller and the range
check runs on the default instead of being skipped.

The two are identical only while the default cadence is itself in range. It is,
60 against 10-3600, so no behavior changes - but a later cadence change could
break it silently, printing "out of range" at every boot. A `static_assert` in
the sketch now fails the build instead. This is the only place where the
extraction is not behavior-preserving by construction.

### Two known defects were preserved, not fixed

Both are recorded in [BACKLOG.md](BACKLOG.md) under "NVS load failures become
plausible defaults with no signal", and both are unchanged by this move:
`loadAutonomousConfig()` still reports success after a failed open, and
`loadSequenceHighWater()` still returns 0, which reads the same as "nothing was
ever reserved". Fixing either changes behavior and needs its own change. They
are now stated in `nvs_persistence.h` where a caller will see them.

### The move was audited as a move

Same method as the two earlier stages, over the tokenizer in
`tests/firmware_source.py`, comments stripped:

- The sketch's tokens equal `HEAD`'s with 2,215 tokens deleted in 17 runs and
  90 inserted. Every insertion is an explicit argument or result at a former
  hidden dependency, plus `#include "nvs_persistence.h"` and the
  `static_assert` above.
- **Eight functions have byte-for-byte identical bodies and parameter lists**:
  `loadExperimentIdOnly`, `saveAutonomousTestArmed`, `saveAutonomousInterval`,
  `loadSequenceHighWater`, `nextBootId`, and the three power-test savers.
- **Five are identical after substituting the sketch global for its new out
  parameter**, and nothing else: `saveCheckpoint`, `loadCheckpoint`, and the
  three power-test loaders.
- **Both split functions recompose exactly.** Inlining `saveSequenceHighWater()`
  back into `reserveSequenceBlock()`, and `loadAutonomousConfig()` back into
  `loadAutonomousSettings()`, reproduces each `HEAD` body token for token.
- The namespace string, all seven key constants, `NVS_SCHEMA_VERSION` and the
  `Preferences` object are identical, with `static` added.

The audit script was a scratch file for this stint and is not in the repository.

### The tests

`tests/test_characterization_nvs.py`, 43 tests, freezing what is stored: the
`solarlog` namespace, all twelve key names and the 15-character ESP32 limit,
the five checkpoint keys with their writer, reader and checked width, the
`LoggerCheckpoint` field types, failure propagation on both checkpoint paths,
the power-test defaults, the sequence key, and the rule that the RTC floor
rises only after the NVS write succeeded.

Two of them are deliberately file-specific, because they are the boundary
rather than the shape of a function: exactly one file may use `preferences`,
and the sketch may not name a key, the namespace, or the object.

Not duplicated: that a failed experiment-id read cannot become experiment 0.
`tests/test_autonomous_accounting.py` already pins it (D-024), and it still
passes unchanged after the move.

**Nine mutations were applied one at a time and all nine were caught**: the
namespace renamed, a checkpoint key renamed, `charge` written with `putUInt`
instead of `putDouble`, a failed key write abandoning the remaining keys, an
unsupported schema returning true, the RTC floor raised before the NVS write,
the Wi-Fi flag defaulting to armed, the sketch naming a key again, and the
reservation written to the `boot_id` key.

**The existing suite was not edited.** 183 passed and 1 xfailed before the move
and after it; the run with the new module is 226 passed, 1 xfailed. The xfail is
the unrelated overrun defect.

### The gate

`tools/check.sh` reported ALL OK before the move and after it.

```text
pytest             226 passed, 1 xfailed        (183 + 43 new)
pyright            0 errors, 0 warnings, 0 informations
py_compile         PASS
firmware compile   clean, --warnings all, no warnings
intellisense       4 translation units, all verified
shell syntax       PASS
whitespace         PASS
```

**The editor found the new module by itself.** `nvs_persistence.cpp` got a
verified entry with no edit to `tools/intellisense.py`, `tools/check.sh`, or any
VS Code setting, which is the D-048 contract and the first time it has been
exercised by a module created after it was written. `git diff tools/ .vscode/`
is empty.

```text
[INTELLISENSE]   nvs_persistence.cpp: compiles cleanly: ALL OK
                 (direct includes: nvs_persistence.h, Arduino.h, Preferences.h)
```

### Where the 820 bytes went

Measured with `nm`, `size -A` and `objdump -h` on both images, and on the object
files of both builds. Flash 1,101,517 -> 1,102,337. **Global variables are
unchanged at 36,332 bytes**: the `Preferences` object is the same 8 bytes under
a new name, `_ZL11preferences`.

The whole delta is accounted for:

| Section | Delta |
| --- | ---: |
| `.flash.text` | +248 |
| `.flash.rodata` | +416 |
| `.eh_frame` | +152 |
| `.flash.init_array` | +4 |
| **total** | **+820** |

`.flash.text`, per symbol. This build has no LTO, so a call that used to be
inside one translation unit can no longer be inlined:

- The three checkpoint call sites carry the struct now: `setup()` +232,
  `closeMeasurementInterval()` +58, `resetExperiment()` +14.
- **The moved functions themselves got smaller**, because writing through a
  reference beat writing four separate globals: `loadCheckpoint` 1,122 -> 1,034
  and `saveCheckpoint` 618 -> 574. The three power-test loaders lost 2 bytes
  each.
- The two splits cost +54 and +16 for the extra call.
- Static initialization is now emitted in two translation units instead of one,
  +12.

`.flash.rodata` +416 is the second object file's own read-only fragments and
their alignment; at object level it is +459, so the linker's string merging
reclaimed 43 of it. **No diagnostic string was duplicated** - the set of
`[NVS]`, `[ERROR]` and `[AUTO]` literals in the two images is identical.
`.eh_frame` +152 is unwind data for the new function set. The 4 bytes of
`.flash.init_array` are one more static constructor slot.

### Firmware identity unchanged

```text
[FIRMWARE] Version:  0.3.0-dev
[FIRMWARE] Build ID: solar-logger-protocol-ack-v3
```

A move changes no command, record, cadence rule or protocol, so the version
policy calls for no bump. The revision that `tools/upload.sh` injects will
differ, and that is what identifies this source.

### Hardware acceptance - PENDING, nothing below has been run

This stage touches the store that holds Experiment 3, so the first check is
whether the board comes back as the same experiment. After a deliberate
`tools/upload.sh`, send each command on its own and expect exit 0 from each.
Everything after "PREDICTED" is read from the source, not observed.

1. The smoke test in [BACKLOG.md](BACKLOG.md). PREDICTED: a real revision hash,
   `Tail status: INTACT` with at least as many records as before, and
   `CMD_RESULT,...,OK` for HOLD, KEEPALIVE and RELEASE.
2. Stage 1's own check, and the one that matters most here: the boot log's
   `[NVS]` block. PREDICTED: `Stored schema = 2`, `experiment = 3`, and the
   same interval number and running charge/energy the board reported before the
   upload. An `experiment = 0` or a zeroed interval means the checkpoint was
   not read and the board must not be left running.
3. `tools/send.sh LOGGER AUTONOMOUS STATUS`. PREDICTED: the same armed state and
   the same 60-second cadence as before the upload, both read from NVS, and
   `New records will carry experiment id: 3`.
4. `tools/send.sh POWER TEST STATUS`. PREDICTED: both tests not armed, which is
   the persisted state, and no `[NVS] ... unavailable` line at boot.
5. One closed interval, tethered: PREDICTED `[NVS] CHECKPOINT REQUIRED` followed
   by the five `[NVS] Writing` lines and
   `*** NVS CHECKPOINT SAVED SUCCESSFULLY ***`, with the interval number one
   higher than step 2 reported.
6. A cold boot with autonomous mode armed. PREDICTED: `boot_id` increments by
   one across the reboot, and `[STORAGE] Sequence reservation already covers
   <n>` rather than a fresh block, since the existing reservation still covers
   the next sequence.

## 2026-09-18: Connection bookkeeping extracted, and the editor database finds every module - NOT hardware validated

**No hardware was touched.** Nothing was uploaded or committed, Experiment 3
was not reset, and storage was not cleared. Every result below is a host test,
a source audit, or a compile. **This image has not run on the board.**

Two changes, in this order: the IntelliSense tooling now configures every
project module by discovery (D-048), and then the second modularization stage
moved the transport bookkeeping into `Arduino/solar-logger/connection.h` and
`connection.cpp` (D-049). Runtime behavior is intended to be unchanged, and
nothing below found a change.

### Why the editor could not find Arduino.h in ina228.cpp

Read out of the generated database, not inferred. Arduino CLI compiles copies
of the sketch files under `<build>/sketch/`, and its compilation database
names the copies. The only entry for the driver was for
`build/intellisense/sketch/ina228.cpp`, and its ESP-IDF include path was still
behind the `@response` / `-iprefix` indirection D-039 describes. Nothing named
`Arduino/solar-logger/ina228.cpp`, and cpptools matches entries by path, so the
file a person edits had no configuration at all. `tools/intellisense.py` added
an editor entry for the `.ino` only.

### A second defect found in the same tool: the "previous configuration" was gone

Observed in a scratch copy of the sketch with the tool as it was at `HEAD`. When
verification failed, it printed:

```text
[INTELLISENSE] ERROR: The sketch does NOT compile under the flags the editor is
about to be given (exit 1, output above). The database has NOT been written, so
the previous configuration is still in place.
```

The database file then held 80 entries and no entry for the `.ino`. Arduino CLI
writes its raw database to its build path, and the build path was the directory
the editor reads from, so the previous editor database had been overwritten
before verification ran. PROJECT.md made the same claim. Arduino CLI now
builds into `build/intellisense/arduino-cli/`; see D-048.

### Arduino CLI's behavior, measured on arduino-cli 1.5.1

A scratch copy of the sketch with a probe file of each kind:

- The database has an entry for `.c`, `.cpp`, `.cc`, `.cxx` and `.S` files in
  the sketch root and anywhere under `src/`. A `.cpp` in any other
  subdirectory is copied into the build and gets no entry.
- `.c` and `.S` are compiled with `riscv32-esp-elf-gcc`, the rest with `g++`.
- Deleting a module removes both its build copy and its database entry on the
  next run. Arduino CLI leaves no stale entry behind.
- `--only-compilation-database` took 9.0 s on a new build path, 8.4 s after a
  file changed, and 1.5 s with nothing changed.
- 2 of the 335 expanded include directories do not exist in the installed SDK
  (`esp_system/port/soc` and an `espressif__esp_matter` path). The core lists
  them anyway, so the tool cannot require every include directory to exist.

### What the tooling does now

- The project's translation units are read out of Arduino CLI's database:
  every entry for a copy under `<build>/sketch/`, mapped back to the real file.
  No module is named anywhere. A scan of the sketch root and `src/` must agree.
- Each one gets exactly one entry naming the real file, with every response
  file and `-iprefix` expanded, and it replaces the build copy's entry. The
  `.ino` also gets `-x c++ -include Arduino.h`; a `.cpp` gets neither.
- Before writing, every entry must resolve `Arduino.h` and the four ESP-IDF
  headers from D-039, and every file is compiled `-fsyntax-only` with exactly
  its entry's flags, in parallel.
- `tools/check.sh` runs `tools/intellisense.sh` as a step. Adding a module and
  running the gate is the whole procedure.
- `--check` reports a stale entry for a deleted file, a missing entry for a new
  one, and any change to a source or header, and names the command to run.

In a scratch copy with `.c`, `.cc`, `.cxx`, `.S`, a nested `src/sub/` module and
a `.cpp` outside `src/`, the tool configured and verified the six C and C++
units, printed a NOTE that the `.S` file gets no editor entry, and left the
other subdirectory alone.

### The generator's output for this repository

After `connection.cpp` was created, with no configuration edit of any kind:

```text
[INTELLISENSE] Project translation units found (3):
[INTELLISENSE]   connection.cpp
[INTELLISENSE]   ina228.cpp
[INTELLISENSE]   solar-logger.ino
[INTELLISENSE] Every project entry resolves Arduino.h, freertos/FreeRTOS.h, esp_sleep.h, soc/soc_caps.h, esp_rom_crc.h: ALL OK
[INTELLISENSE]   connection.cpp: compiles cleanly: ALL OK (direct includes: connection.h, Arduino.h)
[INTELLISENSE]   ina228.cpp: compiles cleanly: ALL OK (direct includes: ina228.h, Arduino.h, Wire.h)
[INTELLISENSE]   solar-logger.ino: compiles cleanly: ALL OK (direct includes: ... ina228.h, connection.h)
```

Regeneration took 12.5 s on a new build path and 2.6 s on a warm one.
`--check` took 0.07 s.

**Not observed: what VS Code shows.** The database is proven by compiling every
entry. Whether cpptools applies it to `ina228.cpp` and `connection.cpp` has to
be seen in the editor. The clang diagnostics Claude Code displayed for
`connection.cpp` while it was being written came from a clangd process that
Claude Code itself started, not from VS Code, so they say nothing about what
cpptools shows.

### What moved into connection

- `activeTransports`, now `static` in `connection.cpp`. Only
  `connectionClaim()` and `connectionRelease()` write it.
- `CONNECTION_NONE`, `CONNECTION_USB`, `CONNECTION_WIFI`, `CONNECTION_BLE`.
  Only `CONNECTION_USB` is in the header, because nothing else outside the
  module uses the others (D-047).
- `anyHostConnected()`, `printActiveTransports()`, `connectionClaim()`,
  `connectionRelease()`, exported, and `transportName()`, now `static`.
- The two forward declarations the sketch kept for `anyHostConnected()` and
  `printActiveTransports()`. `connection.h` declares them now, so the block is
  seventeen entries.

What stayed in the sketch, deliberately (D-049):

- Everything about the lease: HOLD, KEEPALIVE, RELEASE, expiry, the lease
  globals, `hostClaimedRendezvous`, the deferred sleep.
- `printUsbPresence()` and the rendezvous's `USB plugged` / `CDC connected`
  lines. They report electrical presence, which is not connection state.
- Every call site. HOLD claims USB, RELEASE and lease expiry release it,
  `LOGGER AUTONOMOUS OFF` releases it only with no session held, and sleep
  policy asks `anyHostConnected()`. All unchanged.

`solar-logger.ino` went from 7,949 to 7,836 lines by `wc -l`: 118 removed and 5
added. `connection.h` is 50 lines and `connection.cpp` 120.

### Validation performed

| Check | Result |
| --- | --- |
| `tools/check.sh` before any change | `ALL OK`: 153 passed, 1 xfailed; pyright 0 errors, 0 warnings, 0 informations; compile clean |
| `tools/check.sh` after the tooling change, before the move | `ALL OK`, seven steps including the new `intellisense` step: 183 passed, 1 xfailed; pyright 0/0/0; compile clean; image unchanged |
| `tools/check.sh` after the move | `ALL OK`, seven steps: 183 passed, 1 xfailed, the same overrun `xfail`; pyright 0/0/0; compile clean with `--warnings all`, no warnings; intellisense covers all three translation units |
| firmware image | 1,101,475 → 1,101,517 bytes (84%, +42) |
| globals | 36,332 → 36,332 bytes (11%, unchanged) |
| untracked files | `connection.h`, `connection.cpp` and both new test files: no trailing whitespace and no space before a tab |

The 30 new tests are in two files. `tests/test_characterization_connection.py`
was written and passed against the monolith before the move, then passed
unchanged after it. `tests/test_intellisense.py` holds one scenario test that
runs the real generator, Arduino CLI and toolchain against a scratch copy of the
sketch, and nineteen fast tests of the validator, the copy-to-source mapping and
the fingerprint. The scenario took 26.6 s, and it is why pytest went from 2.3 s
to 30.2 s.

### The tests were verified to fail

- **Connection, 10 of 10 mutations caught**, run once against the monolith and
  once after the move: release clearing every bit, `anyHostConnected()`
  asking about USB only, HOLD no longer claiming, the `Host claimed` wording,
  `LOGGER AUTONOMOUS OFF` releasing a held session's USB, the `+` separator,
  the maintenance window trusting `Serial.isConnected()`, booting with USB
  claimed, the claim line's wording, and the BLE bit colliding with Wi-Fi.
  Reformatting every brace K&R and editing comments left the suite green.
- **IntelliSense, both defects restored and caught** by the scenario test:
  only the `.ino` getting an entry, and the database written before
  verification. The second one first passed. The refused database held the
  same bytes as the previous one, so an unchanged file also fit a rewrite. The
  test now marks the previous file with trailing whitespace first, which the
  generator never writes.

### The move was audited as a move

Same method as the INA228 stage, over the tokenizer in
`tests/firmware_source.py`, comments stripped:

- The sketch's tokens equal `HEAD`'s with four runs deleted, 350 tokens in
  total, and `#include "connection.h"` inserted. Nothing else changed.
- All 340 moved tokens are in the new files. The 46 added tokens are
  `#pragma once`, three includes, two `static`, and the four declarations in
  `connection.h`.
- All five functions have identical bodies and parameter lists. All four
  constants and the `activeTransports` definition are identical, with
  `static` added to the state.

The audit script was a scratch file for this stint and is not in the repository.

### Where the 42 bytes went

Measured with `nm`, `size -A` and `objdump` on both images. `.flash.text`
+38 and `.eh_frame` +4; the debug sections do not reach flash.

- `anyHostConnected()` had no symbol before: it was inlined into every caller
  in the same translation unit. It is now a 4-instruction, 14-byte function,
  called three times from `setup()` and once each from the rendezvous, the
  maintenance window and `printHostSessionStatus()`. Those last three became
  one instruction shorter, 4 bytes each. `setup()` kept 789 instructions and
  grew 2 bytes; that was not examined further.
- `transportName()` was a separate 58-byte function called by claim and
  release. As a `static` it was inlined into both: `connectionClaim()` went
  from 34 to 48 instructions and `connectionRelease()` from 52 to 66, 46 bytes
  each.
- `hostSessionHold()`, `hostSessionRelease()`, `serviceHostLease()` and
  `stopAutonomousTest()` have the same size and instruction count, and call the
  same connection functions as before.
- The 4 bytes of `.eh_frame` were not examined.

### Firmware identity unchanged

```text
[FIRMWARE] Version:  0.3.0-dev
[FIRMWARE] Build ID: solar-logger-protocol-ack-v3
```

A move changes no command, record, cadence rule or protocol, so the version
policy calls for no bump. The revision that `tools/upload.sh` injects will
differ, and that is what identifies this source.

### Hardware acceptance - PENDING, nothing below has been run

After a deliberate `tools/upload.sh`, send each command on its own and expect
exit 0 from each. Everything after "PREDICTED" is read from the source, not
observed.

1. The smoke test in [BACKLOG.md](BACKLOG.md). PREDICTED: a real revision hash,
   `Tail status: INTACT` with at least as many records as before, and
   `CMD_RESULT,...,OK` for HOLD, KEEPALIVE and RELEASE.
2. Stage 2's own check, run during the HOLD from step 1: `tools/send.sh LOGGER
   SESSION STATUS`. PREDICTED: `[CONNECTION] Active transports: USB` and
   `[CONNECTION] Any host connected: YES`. HOLD's own output PREDICTED:
   `[CONNECTION] USB transport CLAIMED by an explicit host lease.`
3. RELEASE's output. PREDICTED: `[CONNECTION] USB transport RELEASED.`,
   `[CONNECTION] Active transports: NONE`, `[CONNECTION] Any host connected:
   NO`, then the result, then the transport disappearing.
4. An unclaimed rendezvous, read with `tools/watch-port.sh` or a terminal on
   the port. PREDICTED, once per second: `[CONNECTION] Active transports: NONE`
   and `[CONNECTION] Host claimed: NO`, next to whatever `USB plugged` and
   `CDC connected` report.
5. Lease expiry, optional: HOLD and send nothing. PREDICTED: `[CONNECTION] USB
   transport RELEASED due to lease expiry.` and the same three lines as
   step 3.

## 2026-09-18: INA228 driver extracted into a module - NOT hardware validated

### Addendum, reported later the same day: the INA228 image was smoke-tested

**Reported in the connection stint's brief, and recorded here from it. Not
observed by the agent that wrote this addendum.** The brief states that the
image built from `4a096d9` was uploaded and checked on hardware, and gives
these results:

- `VERSION`: `0.3.0-dev`, revision `4a096d9` with no `-dirty`,
  `solar-logger-protocol-ack-v3`.
- `LOGGER STORAGE INFO`: `Tail status: INTACT`, more than 2,000 valid 72-byte
  records, about 12 days free at the 60-second cadence.
- `LOGGER AUTONOMOUS STATUS`: on, armed, running, 60-second interval, RTC state
  valid.
- `LOGGER SESSION HOLD`, `KEEPALIVE` and `RELEASE`: `CMD_RESULT,...,OK` for
  each. RELEASE closed the tethered interval, saved the NVS checkpoint, armed
  the deferred sleep with about 59,750 ms remaining, and the transport
  disappeared after the RESULT.
- `STATUS` after the next wake: valid live voltage, current and power.
- `POWER TEST STATUS`: the INA228 in continuous conversion.
- Recent autonomous records: `interval_ms` of 60,004, consecutive sequences,
  cumulative charge and energy that reconcile, and no invalid records.

That covers steps 1 to 3 of the pending list below, and part of step 4: the
brief does not mention the records' flags or a nonzero `dQ_uAh`. Step 5 is not
mentioned. The RELEASE figure is also the first check listed under the
scheduler entry below, which predicted a remainder just under 59,750 ms.

**Original extraction-stint status (before the smoke-test addendum above):**
no hardware was touched, nothing was uploaded or committed, Experiment 3 was
not reset and storage was not cleared. The extraction results below are host
tests, a source audit and a compile; the image had not yet run on the board at
the time they were recorded.

The first modularization stage. The INA228 driver moved out of
`solar-logger.ino` into `Arduino/solar-logger/ina228.h` and `ina228.cpp`.
Runtime behavior is intended to be unchanged, and nothing below found a change.
The boundary rules are [DECISIONS.md](DECISIONS.md) D-047. The plan's status,
and where this stage departs from it, are in [BACKLOG.md](BACKLOG.md).

### What moved

- **23 functions:** register reads and writes, sign extension, identity,
  configuration, the ADC_CONFIG MODE decode, shutdown and continuous mode,
  `resetInaAccumulators()`, `readSensor()`, `readAccumulatedCharge_mAh()` and
  `readAccumulatedEnergy_mWh()`. Bodies unchanged. The 11 that nothing outside
  the driver calls are now `static`.
- **33 `constexpr` constants.** The 15 that the sketch still uses are in
  `ina228.h`. The 18 that only the driver uses are private to `ina228.cpp`.
- **`struct SensorReading`**, into the header, because `readSensor()` fills it.

What stayed in the sketch:

- `validateInaForWake()` and the wake cycle's DIAG_ALRT read. BACKLOG assigns
  both to `auto_orchestrator`. They reach the part through `readRegister16()`,
  which the header exports for them.
- `Wire.begin()` and `Wire.setClock()` in `setup()` and
  `runAutonomousWakeCycle()`. Bus bring-up is part of boot and wake ordering.
  The header states it as a precondition.
- `inaShutdownActive`. The power test writes it, and STATUS and the heartbeat
  read it. The driver does neither.
- Every decision about when to read, reset, or reconfigure.

`solar-logger.ino` went from 9,126 to 7,949 lines by `wc -l`: 1,184 lines moved
out, 4 added for the include, and one 4-line comment rewritten as 7 because the
move made it false. `ina228.h` is 224 lines and `ina228.cpp` 1,048. Git's
default diff misaligns this change; `git diff --diff-algorithm=histogram` shows
it as 1,188 deletions and 11 additions.

### Validation performed

| Check | Result |
| --- | --- |
| `tools/check.sh` before the move | `ALL OK`: 153 passed, 1 xfailed; pyright 0 errors, 0 warnings; compile clean |
| `tools/check.sh` after the move | `ALL OK`: 153 passed, 1 xfailed, the same overrun `xfail`; pyright 0 errors, 0 warnings, 0 informations; compile clean with `--warnings all`, no warnings |
| firmware image | 1,102,133 → 1,101,475 bytes (84%, −658) |
| globals | 36,332 → 36,332 bytes (11%, unchanged) |
| `ina228.h`, `ina228.cpp` | untracked, so `git diff HEAD --check` does not cover them; checked separately, no trailing whitespace and no space before a tab |
| `tools/intellisense.sh` | the raw `.ino`, which now includes `ina228.h`, compiles standalone with the editor's flags: ALL OK; 81 entries |

No test was edited. The source tests read every sketch file (D-043), so they
found the moved code without changes.

### The move was audited as a move

With the tokenizer from `tests/firmware_source.py`, which drops comments, so
code is compared and prose is not:

- The sketch's tokens equal the committed sketch's with three runs deleted and
  `#include "ina228.h"` inserted. No remaining line of code changed.
- No token of the committed sketch is missing from the three files. The only
  tokens added are `#pragma once`, five includes, eleven `static`, and the
  twelve declarations.
- All 23 functions have identical bodies and parameter lists. Each header
  declaration matches its definition.
- All 33 constants have identical definitions. Every constant in `ina228.h` is
  used by the sketch, and none private to `ina228.cpp` is referenced by it.

The audit script was a scratch file for this stint and is not in the repository.

### Where the 658 bytes went

Measured with `nm` and `objdump` on both images: `.flash.text` −454 and
`.eh_frame` −204.

- The build has no LTO, so sketch code can no longer inline driver functions
  across the file boundary: `closeMeasurementInterval()` −182,
  `runAutonomousWakeCycle()` −90, `setup()` −72.
- Five helpers that are now `static` no longer exist as separate functions,
  because the compiler inlined them into their callers inside `ina228.cpp`:
  `readRegister20Unsigned`, `readRegister24Unsigned`, `readRegister40Signed`,
  `signExtend20` and `inaModeIsShutdown`. `readSensor()` grew 60 bytes and now
  calls `readRegisterBytes()` where it used to call the first two. Its
  soft-float library calls are the same operations in the same counts before
  and after. `resetInaAccumulators()` and `readAccumulatedCharge_mAh()`, the
  two callers of `readRegister40Signed`, grew 12 bytes each.
- `inaModeFromAdcConfig()` had been inlined at every call. It now also exists
  once as a 4-byte function.
- The other moved functions shrank by 2 to 6 bytes or did not change.
  `verifyInaIdentity()` was disassembled: the same 84 instructions, with
  different string addresses and branch offsets.
- Seven unrelated functions grew 2 bytes each. `connectionClaim()` and
  `hostLeaseRemainingMs()` were disassembled: the same instructions, with
  different addresses and branch offsets. The other five were not examined.
- `printHeartbeat()` grew 18 bytes and `printLiveSample()` shrank 14. In both,
  the return after a failed `readSensor()` is laid out differently. Each calls
  the same set of functions before and after.

### Found, not fixed

**The editor database has no entry for `ina228.cpp` itself.** Arduino CLI's
entry names the build copy, `build/intellisense/sketch/ina228.cpp`, and
`tools/intellisense.py` adds an editor entry only for the `.ino`. BACKLOG said
`.cpp` modules would get correct entries for free, and they do not. Predicted,
not observed in the editor: cpptools will not apply the ESP32 include paths to
`ina228.cpp`. The real build is unaffected. Recorded in
[BACKLOG.md](BACKLOG.md).

### The hardware baseline this stint relied on is not recorded here

The stint brief says the monolith (0.3.0-dev, `solar-logger-protocol-ack-v3`)
was checked on hardware before this extraction. It quotes an autonomous
`interval_ms` of about 60,004, 2,022 records read with 0 invalid, a consecutive
tail, and a first sleep after RELEASE of about 59,750 ms. No entry in this file
records that run, and the entries below still list their acceptance as pending.
The figures are quoted from the brief. They are not a recorded observation.

### Firmware identity unchanged

```text
[FIRMWARE] Version:  0.3.0-dev
[FIRMWARE] Build ID: solar-logger-protocol-ack-v3
```

A move changes no command, record, cadence rule or protocol, so the version
policy calls for no bump. The revision that `tools/upload.sh` injects will
differ, and that is what identifies this source.

### Hardware acceptance - PENDING, nothing below has been run

After a deliberate `tools/upload.sh`, send each command on its own and expect
exit 0 from each. Everything after "PREDICTED" is read from the source, not
observed.

1. The smoke test in [BACKLOG.md](BACKLOG.md): `VERSION`,
   `LOGGER STORAGE INFO`, `LOGGER AUTONOMOUS STATUS`, then `LOGGER SESSION
   HOLD`, `KEEPALIVE` and `RELEASE`. PREDICTED: a real revision hash, a record
   count at least as high as before the upload with `Tail status: INTACT`, and
   `CMD_RESULT,...,OK` for all three session commands.
2. `tools/send.sh STATUS`. PREDICTED: `[STATUS] Voltage`, `Current` and `Power`
   lines with live values, and `CMD_RESULT,STATUS,OK`.
3. `tools/send.sh POWER TEST STATUS`. PREDICTED:
   `[POWER TEST] INA228 mode right now: continuous conversion`.
4. After at least two unclaimed timer wakes, `tools/send.sh LOGGER STORAGE
   DUMP`. PREDICTED: the records written since the upload have `interval_ms`
   near 60,000, a nonzero `dQ_uAh`, and none of `ACCUM_SUSPECT`, `INA_MATHOF`
   or `INA_ACCUM_OF`. The first carries `FIRST_AFTER_BOOT`, because the upload
   was a cold boot. `ACCUM_SUSPECT` is what a failed `validateInaForWake()`,
   accumulator read or DIAG_ALRT read would set.
5. Only if a host is reading the port during the cold boot that follows the
   upload. PREDICTED: `[INA228] Identity check: PASS` and
   `[INA228] CONFIG / ADC_CONFIG / SHUNT_CAL readback: PASS`. Output with
   nobody reading is dropped (D-027), so its absence proves nothing.

## 2026-09-18: Scheduler double-count stint - no hardware touched

**No hardware was touched.** Experiment 3 was not reset, storage was not
cleared, and nothing was uploaded or committed. Every result below is a host
test, a source read, or a compile. No firmware behavior is claimed as observed.

Fixed the scheduler double-count that the RELEASE/HOLD stint recorded earlier
the same day. The finding and its resolution are in [BACKLOG.md](BACKLOG.md),
and the rule is [DECISIONS.md](DECISIONS.md) D-046.

- The scheduler's `AUTO_SLEEP_HOST_RELEASE` path adds only the time since the
  handoff, which the handoff now records in `hostHandoffAtMs`. RELEASE and lease
  expiry share that path.
- The handoff measures with `millis()`. Its `micros()` form wrapped after 71.6
  minutes and dropped 4,294,967 ms from the session clock per wrap.
- The handoff decides whether it continues the retained clock before the RTC
  rebuild can set the magic.
- The timing arithmetic is three pure functions, compiled and run on the host by
  `tests/test_autonomous_schedule.py`. These are the project's first tests that
  execute firmware code.

### Firmware identity unchanged

```text
[FIRMWARE] Version:  0.3.0-dev
[FIRMWARE] Build ID: solar-logger-protocol-ack-v3
```

`0.3.0-dev` has never been committed or uploaded, so this change joins it. The
reasoning is in D-046.

### Validation performed

| Check | Result |
| --- | --- |
| `uv run pytest` | 153 passed, 1 xfailed (was 101 passed, 0 xfailed); the xfail is the overrun finding below |
| `uvx pyright --pythonpath .venv/bin/python` on `app/`, `tools/*.py`, `tests/`, `main.py` | 0 errors, 0 warnings, 0 informations |
| `arduino-cli compile --clean --warnings all --fqbn esp32:esp32:XIAO_ESP32C3 Arduino/solar-logger` | passed, no warnings; 1,102,133 bytes (84%, +118), globals 36,332 bytes (11%, +8) |
| host compile of the three timing functions | Apple clang 21.0.0, `-std=c++20 -Wall -Wextra -Werror`: passed |
| `tools/intellisense.sh` | the raw `.ino` compiles standalone with the editor's flags: ALL OK |
| `git diff HEAD --check` | clean; the untracked test and tool files were checked separately for trailing whitespace and have none |
| `tools/check.sh` | `ALL OK`, all six steps PASS |

### The regression tests were verified to fail

- **Against the saved pre-fix firmware**, the four source tests failed by
  assertion. The executed tests could not build their harness, because the
  helper functions do not exist there, so they errored rather than passed.
- **With the defect restored inside the helper**, the executed tests failed by
  assertion with the pre-fix arithmetic: 31,750 ms of sleep for a RELEASE 28 s
  after `setup()` entry, 31,996 ms for the same lease expiry, and an overrun for
  a 75 s session. A cold-boot release 45 s after `setup()` entry computed
  14,750 ms.
- **17 cases in a scratch copy**: the pre-fix firmware, 14 single-point
  mutations of the fix and the timing functions, and 2 behavior-preserving
  edits. All 15 regressions failed
  the intended test, 14 by assertion. The fifteenth, a new sleep path with no
  clock chosen, failed the host compile on `-Wswitch`, which is its intended
  failure. Reformatting every brace, and moving the helpers, the scheduler and
  the handoff into a `.cpp`, both left the suite green.

### Found, not fixed

Recorded in [BACKLOG.md](BACKLOG.md) under "FOUND 2026-09-18 IN THE SCHEDULER
STINT". Confirmed by reading, the first also by running the timing functions.

- **An overrun moves the interval boundary without resetting the
  accumulators.** At `LOGGER INTERVAL 10` every unclaimed wake overruns, and
  each record then claims about 10 s for about 20 s of charge. A strict `xfail`
  records it. It is not reachable at 60 s.
- **The host-session timing line still uses `micros()`** and misreports
  sessions over 71.6 minutes. Diagnostic text only.
- **After a handoff, the new boundary is taken after the interval close**, not
  at its accumulator reset. Small, unmeasured, and older than this change.

The secondary finding from the RELEASE/HOLD stint, arming while tethered, is
still open. This fix shares no code with it.

### Hardware acceptance still required - PENDING, nothing below has been run

This satisfies the precondition of the RELEASE/HOLD entry below, "after the
scheduler defect is fixed". After a deliberate `tools/upload.sh`, run that
entry's list, and add:

1. **The first sleep after RELEASE.** On a claimed timer wake, HOLD, send a few
   KEEPALIVEs, and RELEASE about 30 s after the claim. PREDICTED:
   `[AUTO] Sleeping until interval deadline; remaining:` just under 59,750 ms.
   That is 60,000 minus the 250 ms grace, minus the output between the handoff
   and arming the grace. The pre-fix image would print about 60,000 minus the
   whole time awake. This is the 2026-09-16 check 3 below, with the number
   predicted.
2. **The record after it.** PREDICTED: `interval_ms` near 60,000, like an
   unclaimed record. Compare the `session_elapsed_ms` difference between the
   last record before the session and the first after it against the host
   clock between those two wakes. PREDICTED: they differ only by oscillator
   drift over the sleeps and a bootloader time per wake. Neither has been
   measured, and D-019 forbids assuming a drift figure. Pre-fix, the record
   clock would also run ahead by the whole session length, tens of seconds or
   more, which is the difference this check can see.
3. **Lease expiry.** Hold a session and stop the keepalives. PREDICTED:
   `remaining:` a few milliseconds under 60,000, then the same record checks as
   in 2.
4. **A session past 71.6 minutes**, optional because it is slow. Hold with
   `app/solar_logger.py` for over 72 minutes, then press Control-C. PREDICTED:
   the check in 2 still agrees. Pre-fix, the record clock would be 4,294,967 ms
   short per wrap, and the double count would add the session length on top.
5. **Unclaimed wakes unchanged.** The 2026-09-17 step 8 below:
   `interval_ms` near 60,000, and `remaining:` near 50,000 after a 10-second
   rendezvous.

## 2026-09-18: RELEASE/HOLD correctness stint - no hardware touched

**No hardware was touched.** Experiment 3 was not reset, storage was not
cleared, and nothing was uploaded. Every result below is a host test, a source
read, or a compile. No firmware behavior is claimed as observed.

Fixed the four findings the characterization gate recorded earlier the same
day. The findings and resolutions are in [BACKLOG.md](BACKLOG.md); the rules
are [DECISIONS.md](DECISIONS.md) D-044 (firmware) and D-045 (host).

- **RELEASE** answers `OK` only when it completed: session ended, and if armed,
  handoff prepared and deferred sleep armed. A failed handoff answers `ERROR`
  and the console names the stage.
- **HOLD during the deferred-sleep grace** is refused with `ERROR`. The pending
  sleep has one arm and one cancel. `LOGGER AUTONOMOUS ON` now enters
  `DEEP_SLEEP_PENDING` for its grace, and an explicit stop cancels a pending
  sleep before its NVS write.
- **The logger** reports RELEASE from the machine RESULT only.
  `SessionClient` had been ignoring the machine RESULT for HOLD, KEEPALIVE and
  RELEASE, because the human line printed before it cleared the expectation.
- **A RESULT whose ACK was lost** is accepted and always flagged. A late ACK
  proves an earlier result stale. `tools/send.sh` now exits 0 for such an
  `OK`, with a distinct line and a warning, where it used to exit 1.

### Firmware identity changed

```text
[FIRMWARE] Version:  0.3.0-dev
[FIRMWARE] Build ID: solar-logger-protocol-ack-v3   (unchanged)
```

MINOR under the version policy, because RELEASE and HOLD changed what they do
or report. The build ID is unchanged, a judgment call recorded in D-044. Step 1
of the pending 2026-09-17 acceptance sequence below now expects `0.3.0-dev`.

### Validation performed

| Check | Result |
| --- | --- |
| `uv run pytest` | 101 passed, 0 xfailed (was 78 passed, 1 xfailed) |
| `uvx pyright --pythonpath .venv/bin/python` on `app/`, `tools/*.py`, `tests/`, `main.py` | 0 errors, 0 warnings, 0 informations |
| `arduino-cli compile --clean --warnings all --fqbn esp32:esp32:XIAO_ESP32C3 Arduino/solar-logger` | passed, no warnings; 1,102,015 bytes (84%, +1,042), globals 36,324 bytes (11%, unchanged) |
| `tools/intellisense.sh` | the raw `.ino` compiles standalone with the editor's flags: ALL OK |
| `tools/check.sh` | `ALL OK`, including `git diff HEAD --check` |

The former strict xfail, `test_release_can_report_a_failed_handoff`, turned
into an XPASS failure as soon as the fix went in, which is what strict mode is
for. The marker came off in the same change.

### The new tests were verified to fail

In a scratch copy, 21 reverts of individual pieces of the fixes each failed the
intended test. They covered the firmware result mapping, each handoff return,
the HOLD refusal and its status word, each pending-sleep writer, the stop
ordering, the arm-time interval clock, each host rule in `SessionClient`,
`SerialDevice` and `send.sh`, and the logger delegation. Reformatting every
brace and moving the five changed functions into a `.cpp` left the suite green.

### Found, not fixed

Recorded in [BACKLOG.md](BACKLOG.md) under "FOUND 2026-09-18 IN THE
RELEASE/HOLD CORRECTNESS STINT". Confirmed by reading only.

- **After a host handoff, the scheduler counts the awake time twice.** The
  handoff already puts the awake time into the retained session clock, and the
  scheduler adds it again. Predicted from the code: the first sleep after a
  RELEASE or lease expiry is short by about the time spent awake, while the
  next record's `interval_ms` still claims a full cadence. **This blocks the
  next upload**: the 2026-09-16 acceptance check expecting a remainder "near
  60000 ms" after RELEASE is predicted to fail.
- **Arming while tethered discards the open tethered interval** without closing
  it or saying so. Low impact.

### Hardware acceptance still required - PENDING, nothing below has been run

After the scheduler defect is fixed and `tools/upload.sh` is run deliberately:
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
