afxjzs/solar-logger/docs/PROJECT.md

# Project

## Hardware acceptance history

**The newest acceptance is always named in [CURRENT_STATE.md](CURRENT_STATE.md).** As of 2026-10-02 that is `8faa0e3`, the D-063 retained-state extraction. Four acceptances have followed the September 29 one recorded below, so read this section as history rather than as current state.

### 2026-09-29

**Fresh healthy-log storage hardware smoke passed, 2026-09-29, on clean
1980d94** (`0.3.0-dev`, `solar-logger-protocol-ack-v3`). Experiment 3 retained;
full pre/post dumps preserve all 10,659 preflight record lines exactly, and
post-upload boot 36 adds 3 records, 12073–12075. Final dump: 10,664 records,
1412–12075, board invalid 0; observed INFO scans have trailing 0 and INTACT tails
with no storage errors. [Raw evidence, checksums and limits](../logs/evidence/2026-09-29/storage-hardware/README.md).
Damaged-log branches remain host/synthetic tested only. No standalone reset,
storage clear, whole-flash erase or corruption injection was performed.
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
