afxjzs/solar-logger/Arduino/solar-logger/solar-logger.ino

#include <Wire.h>
#include <WiFi.h>
#include "esp_sleep.h"

// Version, source revision, and protocol build ID. See the header for what
// each one answers and why they are three separate things.
#include "firmware_version.h"

// INA228 driver: register access, configuration, measurement reads, and the
// accumulator primitives. When to use them stays in this file.
#include "ina228.h"

// Which transport a host has claimed. Leases, sleep, and when autonomous mode
// resumes stay in this file, which calls down into it.
#include "connection.h"

// ESP32 nonvolatile storage: the namespace, the keys, and the typed reads and
// writes. WHEN a persisted value should change is decided in this file.
#include "nvs_persistence.h"

// The machine-readable CSV lines: how each one is spelled. WHAT happened, WHEN
// to emit a line, and which values it carries are decided in this file.
#include "telemetry.h"

// The durable autonomous record: its 72 packed bytes, the flag bit values and
// sentinels that give them meaning, and the CRC that seals them. WHEN a record
// is written, WHICH flags it carries, and WHERE it is stored are decided in this
// file.
#include "record_format.h"

// Durable storage: the LittleFS mount, the log path, the scan, the tail repair
// and the append. WHEN a record is stored, which sequence it carries and what
// an operator command prints are decided in this file.
#include "storage.h"

// Sequence authority: which sequence the next record gets, reconciled from the
// boot-recovery scan and the NVS reservation (D-023). Reading the reservation,
// reserving blocks and every write to the RTC mirror of the reservation stay in
// this file; the mirror's definition is in autonomous_retained_state.cpp.
#include "sequence_authority.h"

// RTC-retained autonomous state: the one definition of each value carried
// across deep sleep, and the magic that says whether it is valid. WHEN any of
// them changes is decided in this file; the module owns no transition.
#include "autonomous_retained_state.h"

// ============================================================================
// BMW SOLAR LOGGER
// Development firmware
//
// Hardware:
//   Seeed Studio XIAO ESP32-C3
//   Texas Instruments INA228 at I2C address 0x40

//
// Current development goals:
//   1. Keep the system highly observable through Serial.
//   2. Measure solar voltage/current/power once per 60-second interval.
//   3. Use the INA228 hardware CHARGE and ENERGY accumulators.
//   4. Maintain cumulative experiment totals.
//   5. Save experiment state to ESP32 nonvolatile storage (NVS).
//   6. Print machine-readable CSV rows that can later be graphed.
//
// Serial commands:
//   HELP
//   STATUS
//   WIFI ON
//   WIFI OFF
//   WIFI STATUS
//   POWER TEST WIFI
//   POWER TEST SLEEP
//   POWER TEST SLEEP INA OFF
//   POWER TEST STATUS
//   POWER TEST STOP
//   RESET
//   RESET YES
//
// These are bench power-characterization modes. Only ONE may be armed at a
// time. None of them touches the experiment ID, interval number, or running
// charge/energy totals.
//
// The two deep-sleep variants differ only in what the INA228 does during the
// ESP32's sleep phase:
//
//   POWER TEST SLEEP           INA228 stays in continuous conversion.
//                              Hardware CHARGE/ENERGY accumulation continues.
//
//   POWER TEST SLEEP INA OFF   INA228 enters its own documented shutdown
//                              mode first. No conversions, no accumulation.
//                              Solar measurement is sacrificed during sleep.
//
// Neither variant removes INA228 power or touches the XIAO 3V3 rail.
//
// RESET YES deliberately starts a NEW experiment.
// It:
//   - increments experiment_id
//   - resets interval number to 0
//   - resets running charge to 0
//   - resets running energy to 0
//   - resets the INA228 hardware CHARGE/ENERGY accumulators
//   - immediately writes the new zero state to NVS
//
// IMPORTANT TERMINOLOGY:
//
//   INA228 VIN
//       Logic power for the INA228 breakout.
//
//   INA228 VIN+ / VIN-
//       The high-current measurement path through the shunt.
//
// Those are completely different electrical connections.
// ============================================================================

// ============================================================================
// LOGGER TIMING
// ============================================================================

// Once per second we send an instantaneous sensor sample to the laptop.
//
// This does NOT:
//   - reset the INA228 accumulators
//   - increment the interval number
//   - change running charge/energy
//   - write NVS
//
// Its only purpose is high-resolution telemetry for live graphs and future
// analysis.
constexpr unsigned long LIVE_SAMPLE_INTERVAL_MS = 1UL * 1000UL;

// Once per minute we close the INA228 accumulation interval.
//
// This is where we calculate:
//   - interval charge
//   - interval energy
//   - average current
//   - average power
//   - running totals
//
// We also save the recovery checkpoint to NVS here.
constexpr unsigned long MEASUREMENT_INTERVAL_MS = 60UL * 1000UL;

// The human-readable heartbeat can stay at five seconds.
//
// The heartbeat exists mainly to tell us the firmware is alive and healthy.
// The new CSV_SAMPLE output serves a different purpose.
constexpr unsigned long HEARTBEAT_INTERVAL_MS = 5UL * 1000UL;

// We now save after EVERY completed interval.
//
// During development this makes recovery after a power failure easier to
// understand. Later we can revisit flash-write strategy if necessary.
constexpr uint32_t NVS_CHECKPOINT_EVERY_INTERVALS = 1;

// ============================================================================
// EXPERIMENT STATE
// ============================================================================
//
// The four values that make up one experiment. They are held here in RAM and
// checkpointed to ESP32 nonvolatile storage after every completed interval.
//
// The NVS namespace, the key names, the schema, and every typed read and write
// live in nvs_persistence.h / .cpp. This file owns WHEN they change: closing an
// interval, and RESET YES starting a new experiment. Nothing here names a key.
// ============================================================================

// The experiment ID lets CSV rows remain distinguishable even if one Serial
// capture file contains multiple experiments.
//
// Example:
//
//   experiment 1, interval 1
//   experiment 1, interval 2
//   experiment 1, interval 3
//
//   RESET YES
//
//   experiment 2, interval 1
//   experiment 2, interval 2
//
// Filtering experiment_id=2 therefore gives only the second experiment.
uint32_t experimentId = 0;

// Number of fully completed measurement intervals in THIS experiment.
uint32_t completedInterval = 0;

// Cumulative charge and energy for THIS experiment.
double runningCharge_mAh = 0.0;
double runningEnergy_mWh = 0.0;

// ============================================================================
// RUNTIME STATE
// ============================================================================

// millis() returns the number of milliseconds since this ESP32 booted.
//
// We save the millis() value at the beginning of each measurement interval and
// compare it against the current millis() later.
unsigned long intervalStartMs = 0;

unsigned long lastHeartbeatMs = 0;

// millis() timestamp for the most recent high-resolution CSV_SAMPLE sent to
// the laptop. This is independent of the 60-second accounting interval.
unsigned long lastLiveSampleMs = 0;

constexpr unsigned long WIFI_POWER_TEST_PHASE_MS = 30UL * 1000UL;

bool wifiPowerTestArmed = false;
bool wifiPowerTestRunning = false;
uint8_t wifiPowerTestPhase = 0;
unsigned long wifiPowerTestPhaseStartedMs = 0;

// ============================================================================
// DEEP-SLEEP POWER TEST
// ============================================================================
//
// PURPOSE
//
//   Measure XIAO ESP32-C3 supply current while the ESP32 is in TRUE deep
//   sleep and the INA228 breakout remains normally powered from XIAO 3V3.
//
//   The comparison we want is:
//
//     normal awake logger  (already measured at ~28.4 mA)
//     vs
//     ESP32 deep sleep + INA228 still powered
//
//   In this first test we deliberately do NOT power-gate the INA228. VIN,
//   GND, SDA, and SCL all stay connected. Isolating INA228 power is a
//   separate future experiment.
//
//
// PHASE SEQUENCE
//
//   Phase A:  awake for 30 seconds, Wi-Fi OFF, normal INA228 behavior
//   Phase B:  true deep sleep for 30 seconds
//   wake -> Phase A -> repeat
//
//
// WHY THIS IS NOT A NORMAL STATE MACHINE
//
//   ESP32 deep sleep does not resume after esp_deep_sleep_start(). The chip
//   reboots and setup() runs again from the top. There is therefore no
//   "phase B code" that runs during sleep, and no code path that returns
//   from sleep into loop().
//
//   Every wake is a fresh boot. The test state machine is consequently
//   split across the reset boundary:
//
//     setup()  decides "am I starting an awake phase, and why?"
//     loop()   decides "has the awake phase lasted long enough to sleep?"
//
constexpr unsigned long SLEEP_POWER_TEST_AWAKE_MS = 30UL * 1000UL;
constexpr uint64_t SLEEP_POWER_TEST_SLEEP_US = 30ULL * 1000000ULL;

// ----------------------------------------------------------------------------
// WHY THE CYCLE COUNTER LIVES IN RTC MEMORY INSTEAD OF NVS
// ----------------------------------------------------------------------------
//
// NVS is flash. Flash has finite erase endurance. This test sleeps every 30
// seconds, which is 2,880 write cycles per day. Writing a counter to flash
// that often would burn endurance for a value that has no long-term meaning.
//
// RTC slow memory has exactly the lifetime we want:
//
//   retained  across deep sleep  (which is the whole point)
//   lost      on power loss      (which ends the bench run anyway)
//
// So the split is deliberate:
//
//   NVS  ->  "is the deep-sleep test armed?"    (must survive power loss)
//   RTC  ->  "which cycle are we on?"           (only meaningful within one
//                                                continuous battery run)
//
// RTC memory contents are UNDEFINED after a power-on reset, so a magic value
// guards it. Without the guard we would read whatever bits happened to be in
// RAM and report a fabricated cycle number.
// ----------------------------------------------------------------------------

constexpr uint32_t SLEEP_POWER_TEST_RTC_MAGIC = 0x5A1EEB01;

RTC_DATA_ATTR uint32_t rtcSleepTestMagic = 0;
RTC_DATA_ATTR uint32_t rtcSleepTestCycle = 0;

bool sleepPowerTestArmed = false;
bool sleepPowerTestRunning = false;
unsigned long sleepPowerTestAwakeStartedMs = 0;

// Which variant of the deep-sleep test is armed. Only meaningful while
// sleepPowerTestArmed is true.
bool sleepPowerTestInaOff = false;

// True only between a verified INA228 shutdown and the deep sleep that
// follows it. Nothing may present INA228 register contents as fresh
// measurements while this is set, because no conversions are running.
//
// In practice deep sleep follows within microseconds, so this exists to make
// the invariant explicit rather than to depend on control flow being fast.
bool inaShutdownActive = false;

// ============================================================================
// AUTONOMOUS LOGGER BENCH TEST
// ============================================================================
//
// A BENCH TEST, not production behavior. It proves one cycle of the
// autonomous architecture designed in docs/STORAGE_SYNC_DESIGN.md:
//
//   INA228 keeps converting through ESP32 deep sleep
//     -> timer wake
//     -> READ accumulated CHARGE and ENERGY *before* anything can reset them
//     -> read a V/I/P/temperature snapshot
//     -> append one durable binary record to LittleFS
//     -> only then reset the accumulators for the next interval
//     -> deep sleep again
//
// What this test deliberately does NOT do: Bluetooth, Wi-Fi, sync, ACK,
// pruning, or a production ring buffer.
//
//
// ACCOUNTING ISOLATION — this is the important safety property.
//
// The running charge and energy totals written into these records are
// TEST-LOCAL. They live in RTC memory and in the durable log, and they are
// recovered from the log on a cold boot. They are NOT the NVS experiment
// totals.
//
// This path never calls saveCheckpoint() and never modifies experimentId,
// completedInterval, runningCharge_mAh, or runningEnergy_mWh. The record
// carries experimentId only as read-only context, so a record can be
// attributed to the experiment that was current when it was written.
//
// Design decision B from the task brief: isolated test accounting, existing
// experiment totals frozen. Modifying live experiment accounting from a bench
// test would risk double-counting or erasing real charge, and the test does
// not need it.
// ============================================================================

// The single authority for autonomous cadence. Everything derives from this;
// no other 60-second constant exists in the autonomous path.
constexpr uint32_t AUTO_INTERVAL_SECONDS_DEFAULT = 60;
constexpr uint32_t AUTO_INTERVAL_SECONDS_MIN = 10;
constexpr uint32_t AUTO_INTERVAL_SECONDS_MAX = 3600;

// The one assumption the NVS extraction made, stated so it cannot lapse.
//
// Before the extraction, loadAutonomousSettings() returned early when the
// namespace would not open, which SKIPPED the range check below it. The read
// is now loadAutonomousConfig() in nvs_persistence.cpp, so that early return
// comes back here and the range check runs on the default instead of being
// skipped. Identical behavior only while the default is itself in range - and
// it is the sort of thing a later cadence change would silently break, so it
// fails the build rather than quietly printing "out of range" at every boot.
static_assert(AUTO_INTERVAL_SECONDS_DEFAULT >= AUTO_INTERVAL_SECONDS_MIN &&
									AUTO_INTERVAL_SECONDS_DEFAULT <= AUTO_INTERVAL_SECONDS_MAX,
							"the default cadence must pass the range check in "
							"loadAutonomousSettings(); see nvs_persistence.h");

uint32_t autonomousIntervalSeconds = AUTO_INTERVAL_SECONDS_DEFAULT;

// Sequence numbers are reserved from NVS in blocks so that a crash costs a
// gap rather than a reuse. Gaps are visible and harmless; duplicates would
// silently corrupt a host's record of what happened.
constexpr uint32_t AUTO_SEQ_BLOCK = 64;

// ----------------------------------------------------------------------------
// Cold-boot maintenance window
// ----------------------------------------------------------------------------
//
// Discovered on hardware 2026-09-11. An armed autonomous board is very hard to
// stop over USB, because the only Serial command parser runs in loop(), and an
// armed cold boot returns straight from setup() into deep sleep without ever
// reaching loop(). A perfectly timed LOGGER TEST STOP was therefore never
// parsed, and tools/send.sh reported success for bytes the firmware never read.
//
// This window is the guaranteed recovery mechanism: on a true cold boot the
// board stays awake, parsing commands, for a known length of time before it
// resumes autonomous sleeping.
//
// It deliberately does NOT apply to a normal timer wake. Timer wakes stay as
// short as possible, because awake time dominates the power budget.
//
// Development value. Shorten it once a management transport exists.
// ----------------------------------------------------------------------------
constexpr uint32_t AUTONOMOUS_COLD_BOOT_MAINTENANCE_MS = 15000;

// How often the window prints that it is open and how much is left.
constexpr uint32_t AUTONOMOUS_MAINTENANCE_TICK_MS = 5000;

// ----------------------------------------------------------------------------
// USB rendezvous and host session lease
// ----------------------------------------------------------------------------
//
// The timer wake itself was proved working on hardware: durable records grew
// from 65 to 99 while the board was unreachable over USB. What was missing was
// any opportunity for a host to take the board over. The optimized wake was
// short enough that macOS could not reliably enumerate the USB device, open it,
// and send a command before the board slept again.
//
// So every successful timer wake now offers a short rendezvous window. A host
// that gets in claims the wake with LOGGER SESSION HOLD and the board stays
// awake as an ordinary tethered logger until the host releases or stops
// renewing its lease.
//
//   SLEEP -> TIMER WAKE -> MEASURE/STORE -> USB RENDEZVOUS
//                                             -> no claim -> SLEEP
//                                             -> HOLD -> HOST SESSION
//                                                          -> KEEPALIVE...
//                                                          -> RELEASE
//                                                          -> or lease expiry
//                                                          -> SLEEP
//
// DEVELOPMENT VALUES. A 3-second rendezvous on every 60-second wake is a large
// fraction of the duty cycle and will cost real power. That is accepted while
// the behavior is being proved. Making it configurable, less frequent than
// every wake, or absent in a deployment mode all come later.
// ----------------------------------------------------------------------------
//
// TEN SECONDS, deliberately. The blocking question is whether a timer wake
// makes the USB device usable to macOS at all, with no reset, no BOOT button,
// no power cycle and no replug. A window long enough to be unmissable answers
// that; a window tuned for power would confuse "USB never came up" with "USB
// came up too briefly". Power optimization comes after the behavior is proved.
constexpr uint32_t AUTONOMOUS_USB_RENDEZVOUS_MS = 10000;

// How long a host session survives without a KEEPALIVE. Chosen against the
// logger's 5-second keepalive cadence: three missed keepalives end the session,
// so a brief host stall does not drop it but a crashed or unplugged host cannot
// hold the board awake indefinitely.
constexpr uint32_t AUTONOMOUS_HOST_LEASE_MS = 15000;

// Machine protocol lines get a short retry window because HWCDC writes with
// setTxTimeoutMs(0) can report a short write when its ring is full. This is a
// hard cap for protocol bytes only; ordinary diagnostics remain nonblocking.
constexpr uint32_t COMMAND_PROTOCOL_WRITE_TIMEOUT_MS = 100;

// RELEASE tears down the USB transport it uses for its own acknowledgement.
// Give the HWCDC endpoint a short, hard-bounded opportunity to deliver the
// echo and outcome before entering deep sleep. This is deliberately not a
// Serial timeout or an unbounded flush, so lease and state-machine deadlines
// remain independent of host availability.
constexpr uint32_t SESSION_RELEASE_ACK_GRACE_MS = 250;

// Rendezvous progress line cadence. Frequent enough to show the window is open,
// rare enough not to flood a host that is still enumerating.
constexpr uint32_t AUTONOMOUS_RENDEZVOUS_TICK_MS = 1000;

// Where the autonomous logger currently is. Printed on every transition,
// because a state machine that changes silently is one nobody can debug.
enum AutoState : uint8_t
{
	AUTO_STATE_IDLE,									 // not armed; ordinary tethered logger
	AUTO_STATE_COLD_BOOT_MAINTENANCE,	 // armed, cold-boot recovery window open
	AUTO_STATE_TIMER_WAKE_MEASUREMENT, // armed, measuring and storing
	AUTO_STATE_USB_RENDEZVOUS,				 // armed, offering the wake to a host
	AUTO_STATE_HOST_SESSION,					 // armed, but a host holds the board awake
	AUTO_STATE_HOST_SESSION_RELEASED,	 // host let go; returning to autonomous
	AUTO_STATE_HOST_LEASE_EXPIRED,		 // host stopped renewing; returning
	AUTO_STATE_DEEP_SLEEP_PENDING,		 // about to sleep
};

// Which path is about to enter deep sleep. Only the timer-wake path produces
// a number that may be compared against other timer wakes; the others include
// full initialization and are labeled so they are never read as wake timings.
enum AutoSleepPath : uint8_t
{
	AUTO_SLEEP_TIMER_WAKE,	 // the optimized path: setup() -> wake cycle -> sleep
	AUTO_SLEEP_COLD_BOOT,		 // power-on/reset resume, includes init + window
	AUTO_SLEEP_ARM_COMMAND,	 // operator typed LOGGER TEST AUTONOMOUS
	AUTO_SLEEP_RTC_LOST,		 // timer wake whose RTC session state was gone
	AUTO_SLEEP_HOST_RELEASE, // a host session ended and handed the board back
};

// How the host-session -> autonomous handoff ended. Each failure names the
// stage that failed, so RELEASE and lease expiry can say which one (D-044).
enum HandoffResult : uint8_t
{
	HANDOFF_PREPARED,						 // interval closed, autonomous state valid, baseline set
	HANDOFF_INTERVAL_NOT_CLOSED, // closeMeasurementInterval() failed
	HANDOFF_STORAGE_UNAVAILABLE, // RTC state needed rebuilding; storage would not mount
};

// How LOGGER SESSION HOLD ended. Two different refusals, because a host has to
// act differently on them (D-044):
//
//   HOLD_NOT_ARMED      autonomous mode is off; the board stays awake anyway
//                       and no lease is needed. Answered REFUSED.
//   HOLD_SLEEP_PENDING  the board is already committed to a deferred autonomous
//                       sleep; claim it at the next rendezvous. Answered ERROR.
enum HoldResult : uint8_t
{
	HOLD_GRANTED,
	HOLD_NOT_ARMED,
	HOLD_SLEEP_PENDING,
};

// What the deadline scheduler decided (D-032), from planAutonomousSleep().
// Declared up here because the Arduino preprocessor puts generated prototypes
// ahead of the first function definition, and one of them returns this.
struct AutoSleepPlan
{
	uint32_t sleepMs;					// the commanded deep sleep
	uint32_t intervalStartMs; // the boundary to keep; moves only on an overrun
	uint32_t wakeElapsedMs;		// the retained session clock for the next wake
	uint32_t overrunMs;				// how far past the deadline, when overran
	bool overran;
};

// AutoLogScan used to be declared here for the same reason, and no longer needs
// to be: it arrives from storage.h with the includes, as AutoRecord arrives
// from record_format.h.

// The RTC-retained autonomous state, the ten rtcAuto* values and
// AUTO_RTC_MAGIC, used to be defined here. It arrives from
// autonomous_retained_state.h with the includes, which defines nothing: the one
// definition of each is in autonomous_retained_state.cpp. Every function that
// writes them is still in this file.

bool autonomousTestArmed = false;
bool autonomousTestRunning = false;

// Set as soon as a stop is ASKED FOR, before it is known to have worked.
//
// stopAutonomousTest() clears autonomousTestArmed only after the NVS write
// succeeds, which is correct. But that leaves the two cases "no stop was sent"
// and "a stop was sent and could not be persisted" looking identical to the
// maintenance window, and it would resume sleeping in both. Deep sleep after
// an explicit stop request is the same class of bug this window exists to fix.
//
// Plain RAM, so a boot clears it. The persisted flag is the only thing that
// survives, and it is still the authority on whether the test is armed.
bool autonomousStopRequested = false;

// ----------------------------------------------------------------------------
// Host session lease
// ----------------------------------------------------------------------------
//
// An explicit software lease, deliberately NOT Serial.isConnected() or
// isPlugged(). Those were audited on 2026-09-11: isPlugged() is a SOF watchdog
// the ESP32 core's own source says "is known to flap even on a healthy link",
// and isConnected() reads false whenever no terminal holds the port open even
// with USB attached. Neither can decide whether the board may sleep.
//
// A lease is a positive claim from software that is actually talking to us, and
// it expires on its own, so a crashed host, a yanked cable, or a laptop going
// to sleep all resolve without any cooperation from the host.
//
// Plain RAM. A host session is by definition a property of one awake period.
// ----------------------------------------------------------------------------
bool hostSessionHeld = false;
uint32_t hostLeaseDeadlineMs = 0;
uint32_t hostSessionStartedMs = 0;
uint32_t hostKeepaliveCount = 0;

// When the lease was last taken or renewed, so STATUS can report how long the
// host has been quiet rather than only how long is left.
uint32_t hostLeaseRenewedMs = 0;

// True once HOLD has established the tethered measurement baseline, so the
// ordinary initialization further down setup() does not reset the accumulators
// a second time and throw the session's charge away.
bool hostSessionBaselineEstablished = false;

// How many ordinary 60-second intervals actually closed during this session.
//
// Counted directly rather than derived from completedInterval, and that is the
// whole point. The first version captured completedInterval at the claim and
// subtracted later. But HOLD runs during the USB rendezvous, which is BEFORE
// loadCheckpoint() restores completedInterval from NVS, so the baseline was
// always 0 and the difference was simply the restored interval number: a
// 25-second session reported 2350 intervals closed.
//
// That is the same class of defect as D-024, introduced while fixing D-024.
// A counter incremented at the actual event cannot be wrong about ordering.
uint32_t hostSessionIntervalCloses = 0;

// Set by LOGGER SESSION HOLD during the rendezvous window so the wake cycle
// knows to stay awake instead of sleeping.
bool hostClaimedRendezvous = false;

// Deferred autonomous deep sleep, so a command that destroys its own transport
// can deliver CMD_RESULT before the transport disappears (D-035).
//
// Two commands need it and they are not the same command, which is why the path
// travels with the deadline rather than being assumed:
//
//   LOGGER SESSION RELEASE   completes the accounting handoff, then sleeps
//   LOGGER AUTONOMOUS ON     arms, then sleeps into the first interval
//
// Named for the mechanism rather than for RELEASE, because a value whose name
// says one thing while it carries another is how the next reader gets it wrong.
bool pendingAutonomousSleep = false;
uint32_t pendingAutonomousSleepDeadlineMs = 0;
AutoSleepPath pendingAutonomousSleepPath = AUTO_SLEEP_HOST_RELEASE;

AutoState autonomousState = AUTO_STATE_IDLE;

// Set when a power test ends but the INA228 accumulators could not be cleared.
// Accounting must stay suspended in that case: the accumulators hold charge
// from an unaccounted window of unknown length, and folding it into the next
// interval would produce a wrong average current and average power that look
// exactly like right ones.
//
// This is ordinary RAM, not RTC memory or NVS, so a reset clears it. That is
// intended: setup() clears the accumulators on every boot.
bool intervalAccountingBlocked = false;

// Captured once, at the very top of setup(), before anything else can run.
esp_sleep_wakeup_cause_t bootWakeupCause = ESP_SLEEP_WAKEUP_UNDEFINED;

// micros() sampled on the first line of setup(). Every "total duration" figure
// the autonomous path prints is measured from here, so it covers the whole
// awake period rather than starting partway through it.
//
// It does NOT include the bootloader: micros() is already non-zero when setup()
// begins, and that offset is printed alongside the total rather than hidden.
uint32_t setupEntryMicros = 0;

// millis() at the moment the host handoff set rtcAutoSessionElapsedMs to the
// session time of that moment. The scheduler adds only the time since then on
// the AUTO_SLEEP_HOST_RELEASE path (D-046). Only the handoff writes it, and it
// is meaningful only on the boot that wrote it, so plain RAM is right.
uint32_t hostHandoffAtMs = 0;

// ============================================================================
// WHICH POWER TEST IS ARMED
// ============================================================================
//
// The Wi-Fi test and the deep-sleep test are mutually exclusive. They are
// stored under two separate NVS keys rather than one shared mode key so that
// the existing, already-deployed wifi_test_armed key keeps working exactly as
// documented in DECISIONS.md D-006.
//
// Two independent flags make one invalid combination representable: both
// armed at once. That state is never created by this firmware, but if it ever
// appears we refuse to guess which test the user meant.
// ============================================================================

enum PowerTestMode : uint8_t
{
	POWER_TEST_NONE = 0,
	POWER_TEST_WIFI = 1,
	POWER_TEST_SLEEP = 2,
	POWER_TEST_CONFLICT = 3,
};

// armedPowerTestMode() and intervalAccountingSuspended() are defined further
// down, alongside the other power-test functions.
//
// That placement used to be load-bearing. The Arduino sketch preprocessor
// inserts its generated function prototypes immediately before the FIRST
// function definition in the file, and a function defined here would have
// pushed that insertion point above "struct SensorReading", which the sketch
// then defined further down. SensorReading now comes from ina228.h, included
// at the top, and every type the sketch defines is above this line, so the
// hazard is gone. The functions were left where they are rather than moved
// as part of the INA228 extraction.

// This is OUR command-building buffer.
//
// Serial data does not arrive as a complete String.
//
// If you type:
//
//   STATUS<Enter>
//
// the ESP32 receives individual characters:
//
//   'S'
//   'T'
//   'A'
//   'T'
//   'U'
//   'S'
//   '\n'
//
// We append the ordinary characters to this String.
//
// When '\n' or '\r' arrives, we know the command is complete and send the
// finished String to processCommand().
String serialCommandBuffer;

bool writeProtocolLine(const String &line, uint32_t timeoutMs);

// ============================================================================
// FORWARD DECLARATIONS
// ============================================================================
//
// These sixteen functions are called above the line where they are defined.
// The build works without this block only because Arduino CLI synthesizes
// prototypes into the generated .ino.cpp it actually compiles - which means
// the file a person edits is not, by itself, a valid C++ translation unit.
//
// That gap is not free. An editor reading solar-logger.ino directly reports
// every one of these calls as an undeclared identifier, and no amount of
// include-path configuration fixes it, because the declarations genuinely are
// not there. Declaring them here makes the sketch stand on its own as ordinary
// C++, so the source, the compiler, and the editor all see the same thing.
//
// These are declarations only. They emit no code and change no behavior.
//
// tools/intellisense.sh compiles this file standalone and fails loudly if a
// new forward reference is added without a declaration here, so the list
// cannot quietly fall behind.
//
// Keep them sorted, and delete each one as its owner moves into a real module
// with a real header - see the modularization plan in docs/BACKLOG.md.

bool armAutonomousTest();
const char *autoStateName(AutoState state);
bool autonomousUsbRendezvous(bool cycleOk);
bool clearStorage();
bool dumpStorage();
HoldResult hostSessionHold();
void hostSessionKeepalive();
bool hostSessionRelease();
void printAutonomousStatus();
void printDeprecatedCommand(const char *oldName, const char *newName);
void printHostSessionStatus();
bool printStorageInfo();
void printUsbPresence(const char *label);
void setAutoState(AutoState next, const char *reason);
bool stopAllPowerTests();
bool stopAutonomousTest();

// ============================================================================
// HIGH-RESOLUTION LIVE SAMPLE
// ============================================================================
//
// This creates one instantaneous telemetry point for the laptop.
//
// CSV_SAMPLE is different from CSV_DATA:
//
//   CSV_SAMPLE
//       High-resolution instantaneous measurement.
//       Currently generated once per second.
//
//   CSV_DATA
//       Authoritative 60-second interval summary.
//       Includes accumulated charge, energy, averages, and running totals.
//
// Reading the live VBUS/CURRENT/POWER registers does NOT reset or interfere
// with the INA228 CHARGE or ENERGY accumulators.
//
void printLiveSample()
{
	// CSV_SAMPLE carries elapsed_seconds, which is derived from
	// completedInterval and millis(). Both are meaningless during the
	// deep-sleep test: completedInterval is frozen because accounting is
	// suspended, and millis() restarts at zero on every wake. Emitting rows
	// anyway would write a sawtooth elapsed_seconds into the live experiment's
	// samples.csv under an unchanged experiment_id.
	//
	// Suppressing the machine-readable row is the honest option. The
	// human-readable heartbeat keeps printing real INA228 values every five
	// seconds, so Serial observability is unaffected.
	//
	// Note that this checks sleepPowerTestRunning, NOT the broader
	// intervalAccountingSuspended(). The difference is deliberate: in the
	// accounting-blocked state the board is awake continuously, so
	// elapsed_seconds still advances monotonically and the samples are real.
	// Only repeated deep sleep makes the value jump backwards.
	if (sleepPowerTestRunning)
	{
		return;
	}

	SensorReading reading;

	// readSensor() fills the SensorReading struct with the latest values
	// currently available from the INA228.
	//
	// false means:
	//   Do not print the verbose VSHUNT diagnostic block for every 1-second
	//   sample. That would create a huge amount of Serial output.
	if (!readSensor(reading, false))
	{
		Serial.println(
				"[ERROR] LIVE SAMPLE failed because INA228 read failed.");
		return;
	}

	// We do not yet have a real wall-clock timestamp.
	//
	// Instead, create an elapsed time within the experiment.
	//
	// completedInterval:
	//   Number of complete 60-second intervals already finished.
	//
	// millis() - intervalStartMs:
	//   Number of milliseconds elapsed in the CURRENT interval.
	//
	// Example:
	//
	//   3 complete intervals = 180 seconds
	//   17.2 seconds into interval 4
	//
	//   experimentElapsedSeconds = 197.2 seconds
	//
	double experimentElapsedSeconds =
			completedInterval * 60.0 +
			(millis() - intervalStartMs) / 1000.0;

	// How the row is spelled is telemetry.cpp's. What is in it is decided
	// here: this experiment, this moment, and the reading just taken.
	const TelemetrySample sample = {
			experimentId,
			experimentElapsedSeconds,
			reading.voltage_V,
			reading.current_mA,
			reading.power_mW,
			reading.temperature_C};

	telemetryPrintSample(sample);
}

// One place decides how a sleep-test variant is named, so the banner, STATUS,
// and stop messages cannot drift apart.
const char *sleepPowerTestVariantName()
{
	return sleepPowerTestInaOff ? "INA shutdown" : "INA continuous";
}

// ============================================================================
// SERIAL COMMAND HELP
// ============================================================================

const char *wifiModeName(wifi_mode_t mode)
{
	switch (mode)
	{
	case WIFI_OFF:
		return "OFF";
	case WIFI_STA:
		return "STA";
	case WIFI_AP:
		return "AP";
	case WIFI_AP_STA:
		return "STA+AP";
	default:
		return "UNKNOWN";
	}
}

void printWifiStatus()
{
	wifi_mode_t mode = WiFi.getMode();

	Serial.print("[WIFI] State: ");
	Serial.println(mode == WIFI_OFF ? "DISABLED" : "ENABLED");

	Serial.print("[WIFI] Mode: ");
	Serial.println(wifiModeName(mode));
}

bool enableWifi()
{
	Serial.println("[WIFI] Enabling Wi-Fi...");

	// STA means station mode: the ESP32 behaves like a client radio, but this
	// command deliberately does not join an access point. Enabling the radio
	// without a network connection lets bench measurements isolate Wi-Fi power.
	if (!WiFi.mode(WIFI_STA))
	{
		Serial.println("[WIFI] ERROR: Could not set station mode.");
		return false;
	}

	if (!WiFi.disconnect(false, false))
	{
		Serial.println("[WIFI] ERROR: Could not keep Wi-Fi disconnected.");
		return false;
	}

	Serial.println("[WIFI] Mode: STA");
	Serial.println("[WIFI] Wi-Fi enabled: ALL OK");
	return true;
}

bool disableWifi()
{
	Serial.println("[WIFI] Disabling Wi-Fi...");

	// WIFI_OFF is the Arduino ESP32 core's explicit radio-off mode.
	if (!WiFi.mode(WIFI_OFF))
	{
		Serial.println("[WIFI] ERROR: Could not disable Wi-Fi.");
		return false;
	}

	Serial.println("[WIFI] Wi-Fi disabled: ALL OK");
	return true;
}

void initializeWifiOff()
{
	// Set the baseline explicitly instead of relying on framework defaults,
	// which can vary after resets or across Arduino core versions.
	Serial.println("[WIFI] Boot default: OFF");
	disableWifi();
}

void startWifiPowerTestPhase(uint8_t phase)
{
	wifiPowerTestPhase = phase;
	wifiPowerTestPhaseStartedMs = millis();

	if (phase == 1)
	{
		// Explicitly turn the radio OFF for each OFF phase, including adjacent
		// OFF phases at the boundary between repeated cycles.
		disableWifi();
		Serial.println("[POWER TEST] Phase 1/3: WIFI OFF for 30 seconds");
	}
	else if (phase == 2)
	{
		enableWifi();
		Serial.println("[POWER TEST] Phase 2/3: WIFI ON for 30 seconds");
	}
	else if (phase == 3)
	{
		disableWifi();
		Serial.println("[POWER TEST] Phase 3/3: WIFI OFF for 30 seconds");
	}
	else
	{
		Serial.print("[POWER TEST] ERROR: Invalid phase: ");
		Serial.println(phase);
	}
}

void updateWifiPowerTest(unsigned long now)
{
	if (!wifiPowerTestRunning ||
			now - wifiPowerTestPhaseStartedMs < WIFI_POWER_TEST_PHASE_MS)
	{
		return;
	}

	if (wifiPowerTestPhase == 1)
	{
		startWifiPowerTestPhase(2);
	}
	else if (wifiPowerTestPhase == 2)
	{
		startWifiPowerTestPhase(3);
	}
	else if (wifiPowerTestPhase == 3)
	{
		Serial.println("[POWER TEST] Cycle complete. Repeating...");
		startWifiPowerTestPhase(1);
	}
	else
	{
		Serial.println("[POWER TEST] ERROR: Stopping due to invalid phase.");
		wifiPowerTestRunning = false;
	}
}

bool armWifiPowerTest()
{
	if (autonomousTestArmed || autonomousTestRunning)
	{
		Serial.println(
				"[POWER TEST] ERROR: The autonomous logger bench test is armed.");
		Serial.println("[POWER TEST] Send LOGGER TEST STOP first.");
		return false;
	}

	// Only one power test may be armed at a time. Silently replacing an armed
	// test would change what the DMM is measuring without saying so.
	if (sleepPowerTestArmed || sleepPowerTestRunning)
	{
		Serial.println(
				"[POWER TEST] ERROR: The deep-sleep power test is already armed.");
		Serial.println(
				"[POWER TEST] Send POWER TEST STOP first, then POWER TEST WIFI.");
		return false;
	}

	if (!saveWifiPowerTestArmed(true))
	{
		Serial.println("[POWER TEST] ERROR: Test was not armed.");
		return false;
	}

	wifiPowerTestArmed = true;
	wifiPowerTestRunning = true;
	Serial.println("[POWER TEST] Wi-Fi power test ARMED");
	startWifiPowerTestPhase(1);
	return true;
}

// NOTE: The former stopWifiPowerTest() was removed when POWER TEST STOP began
// handling both power tests. Its logic now lives in stopAllPowerTests(), which
// is the single stop path. Two stop functions would eventually diverge.

void printWifiPowerTestStatus()
{
	Serial.print("[POWER TEST] Wi-Fi test armed: ");
	Serial.println(wifiPowerTestArmed ? "YES" : "NO");

	Serial.print("[POWER TEST] Wi-Fi test running: ");
	Serial.println(wifiPowerTestRunning ? "YES" : "NO");

	if (!wifiPowerTestRunning)
	{
		Serial.println("[POWER TEST] Wi-Fi test phase: NONE");
		return;
	}

	Serial.print("[POWER TEST] Wi-Fi test phase: ");
	Serial.print(wifiPowerTestPhase);
	Serial.println("/3");

	Serial.print("[POWER TEST] Elapsed in phase: ");
	Serial.print((millis() - wifiPowerTestPhaseStartedMs) / 1000UL);
	Serial.println(" seconds");
}

// ============================================================================
// WHICH POWER TEST IS ARMED
// ============================================================================

PowerTestMode armedPowerTestMode()
{
	// The autonomous bench test is not a power test, but it owns deep sleep and
	// the INA228 accumulators, so it is mutually exclusive with both of them.
	// Reporting it as a conflict here is what stops a power test from being
	// armed on top of it.
	if (autonomousTestArmed && (wifiPowerTestArmed || sleepPowerTestArmed))
	{
		return POWER_TEST_CONFLICT;
	}

	if (wifiPowerTestArmed && sleepPowerTestArmed)
	{
		return POWER_TEST_CONFLICT;
	}

	if (wifiPowerTestArmed)
	{
		return POWER_TEST_WIFI;
	}

	if (sleepPowerTestArmed)
	{
		return POWER_TEST_SLEEP;
	}

	return POWER_TEST_NONE;
}

// ============================================================================
// INTERVAL ACCOUNTING SUSPENSION
// ============================================================================
//
// The 60-second accounting interval cannot survive repeated deep sleep:
//
//   1. millis() restarts at zero on every wake, so the interval timer never
//      reaches 60 seconds during a 30-second awake phase.
//   2. setup() calls resetInaAccumulators() on every boot, so INA228 hardware
//      accumulation from the previous awake phase is discarded on each wake.
//   3. The board is not awake during sleep, so there is no honest way to
//      report 60 seconds of elapsed interval time.
//
// Rather than emit intervals whose elapsed time, average current, and average
// power would all be wrong, accounting is explicitly SUSPENDED for the whole
// duration of the deep-sleep test. Running charge, running energy, interval
// number, and experiment ID are left exactly as they were.
//
// This is a single derived predicate so no second flag can drift out of sync
// with the test state. It has two honest causes:
//
//   sleepPowerTestRunning     the deep-sleep test is in progress
//   intervalAccountingBlocked a test ended but the accumulators are dirty
//
// The second one exists because "the test stopped" and "accounting is safe to
// resume" are different facts. Without it, a failed accumulator reset would
// print that accounting stays suspended while this predicate said it was
// active, and loop() would go on closing intervals with stale accumulation.
// ============================================================================

// True only while the autonomous cycle actually owns the board.
//
// Deliberately NOT autonomousTestArmed, and no longer autonomousTestRunning:
// during a HOST SESSION the board is armed but awake and tethered, and normal
// interval accounting has to run. Suspending it there would silently stop the
// CSV telemetry the host connected to collect.
bool autonomousOwnsBoard()
{
	return autonomousState == AUTO_STATE_TIMER_WAKE_MEASUREMENT ||
				 autonomousState == AUTO_STATE_USB_RENDEZVOUS ||
				 autonomousState == AUTO_STATE_DEEP_SLEEP_PENDING;
}

bool intervalAccountingSuspended()
{
	return sleepPowerTestRunning || autonomousOwnsBoard() ||
				 intervalAccountingBlocked;
}

const char *intervalAccountingSuspendReason()
{
	if (autonomousOwnsBoard())
	{
		return "autonomous logger owns the board";
	}

	if (sleepPowerTestRunning)
	{
		return "deep-sleep power test in progress";
	}

	if (intervalAccountingBlocked)
	{
		return "INA228 accumulators could not be cleared; reset the board";
	}

	return "not suspended";
}

// ============================================================================
// DEEP-SLEEP WAKE DIAGNOSTICS
// ============================================================================
//
// Every value here comes from esp_sleep_get_wakeup_cause(). Nothing is
// inferred from timing, from the armed flag, or from RTC memory contents.
// ============================================================================

const char *wakeupCauseName(esp_sleep_wakeup_cause_t cause)
{
	switch (cause)
	{
	case ESP_SLEEP_WAKEUP_UNDEFINED:
		return "POWER ON / RESET";
	case ESP_SLEEP_WAKEUP_TIMER:
		return "DEEP SLEEP TIMER";
	case ESP_SLEEP_WAKEUP_EXT0:
		return "EXT0";
	case ESP_SLEEP_WAKEUP_EXT1:
		return "EXT1";
	case ESP_SLEEP_WAKEUP_TOUCHPAD:
		return "TOUCHPAD";
	case ESP_SLEEP_WAKEUP_ULP:
		return "ULP";
	case ESP_SLEEP_WAKEUP_GPIO:
		return "GPIO";
	case ESP_SLEEP_WAKEUP_UART:
		return "UART";
	default:
		return "UNRECOGNIZED";
	}
}

void printBootWakeReason()
{
	Serial.print("[BOOT] Wake reason: ");
	Serial.println(wakeupCauseName(bootWakeupCause));

	// Print the raw enum value too. If the name above ever says UNRECOGNIZED,
	// this is what makes the cause diagnosable instead of a dead end.
	Serial.print("[BOOT] Wake cause code: ");
	Serial.println(static_cast<int>(bootWakeupCause));
}

// ============================================================================
// DEEP-SLEEP POWER TEST: AWAKE PHASE
// ============================================================================

void startSleepPowerTestAwakePhase()
{
	sleepPowerTestRunning = true;
	sleepPowerTestAwakeStartedMs = millis();

	Serial.println();

	if (sleepPowerTestInaOff)
	{
		Serial.println("[POWER TEST] INA-OFF sleep test");
	}

	Serial.print("[POWER TEST] Sleep test variant: ");
	Serial.println(sleepPowerTestVariantName());

	Serial.println("[POWER TEST] Sleep test: AWAKE phase");

	Serial.print("[POWER TEST] Awake duration: ");
	Serial.print(SLEEP_POWER_TEST_AWAKE_MS / 1000UL);
	Serial.println(" seconds");

	// Report the Wi-Fi state the radio is ACTUALLY in rather than asserting
	// that it is off. If something left it on, this line has to say so.
	wifi_mode_t mode = WiFi.getMode();

	Serial.print("[POWER TEST] Wi-Fi: ");
	Serial.println(mode == WIFI_OFF ? "OFF" : wifiModeName(mode));

	if (mode != WIFI_OFF)
	{
		Serial.println(
				"[POWER TEST] ERROR: Wi-Fi must be OFF during the sleep test.");
		Serial.println(
				"[POWER TEST] Disabling Wi-Fi now so the measurement stays valid.");

		disableWifi();

		if (WiFi.getMode() != WIFI_OFF)
		{
			Serial.println(
					"[POWER TEST] ERROR: Wi-Fi is STILL ON. Sleep-current readings "
					"from this cycle include the radio.");
		}
	}

	Serial.print("[POWER TEST] Cycle: ");
	Serial.println(rtcSleepTestCycle);

	Serial.print("[POWER TEST] Boot-to-awake-phase time: ");
	Serial.print(millis() / 1000.0, 2);
	Serial.println(" seconds");

	Serial.println(
			"[POWER TEST] Interval accounting: SUSPENDED for this test.");
	Serial.println(
			"[POWER TEST] CSV_SAMPLE and CSV_DATA output: SUSPENDED for this test.");
	Serial.println(
			"[POWER TEST] Heartbeat continues every 5 seconds.");

	if (sleepPowerTestInaOff)
	{
		Serial.println(
				"[POWER TEST] During each deep sleep the INA228 will be in its own "
				"shutdown mode.");
		Serial.println(
				"[POWER TEST] Solar measurement is therefore SUSPENDED during sleep: "
				"no conversions and no CHARGE/ENERGY accumulation.");
		Serial.println(
				"[POWER TEST] The INA228 measures normally during this awake phase.");
	}
	else
	{
		Serial.println(
				"[POWER TEST] The INA228 stays in continuous conversion through the "
				"deep sleep.");
	}
}

// ============================================================================
// DEEP-SLEEP POWER TEST: ENTER SLEEP
// ============================================================================
//
// This function does not return in the success case. The chip powers down
// here and the next thing that runs is setup().
// ============================================================================

void enterSleepPowerTestDeepSleep()
{
	Serial.println();

	if (sleepPowerTestInaOff)
	{
		Serial.println("[POWER TEST] INA-OFF sleep test");

		// The INA228 is shut down BEFORE the wake timer is armed, so a shutdown
		// failure costs nothing: the board simply never sleeps this cycle.
		if (!enterInaShutdownMode())
		{
			Serial.println(
					"[POWER TEST] ERROR: INA228 shutdown could not be verified.");
			Serial.println("[POWER TEST] Deep sleep NOT entered.");
			Serial.println(
					"[POWER TEST] Sleeping now would measure an unknown INA228 state "
					"and the reading would be meaningless.");

			stopAllPowerTests();
			return;
		}

		inaShutdownActive = true;
	}

	Serial.print("[POWER TEST] Entering ESP32 DEEP SLEEP for ");
	Serial.print(static_cast<unsigned long>(SLEEP_POWER_TEST_SLEEP_US / 1000000ULL));
	Serial.println(" seconds...");

	// Reports the cycle whose awake phase just finished.
	telemetryPrintSleepTestEvent(
			sleepPowerTestInaOff ? "SLEEP_TEST_SLEEP_INA_OFF" : "SLEEP_TEST_SLEEP",
			experimentId,
			rtcSleepTestCycle);

	esp_err_t timerResult =
			esp_sleep_enable_timer_wakeup(SLEEP_POWER_TEST_SLEEP_US);

	if (timerResult != ESP_OK)
	{
		// Sleeping without a wake source would put the board into a sleep it
		// never returns from. The DMM would show sleep current forever and the
		// test would look like it was working. Refuse, loudly, and disarm.
		Serial.print(
				"[POWER TEST] ERROR: Could not enable the deep-sleep wake timer. "
				"esp_err_t = ");
		Serial.println(static_cast<int>(timerResult));

		Serial.println("[POWER TEST] Deep sleep NOT entered.");
		Serial.println(
				"[POWER TEST] Stopping the sleep test rather than sleeping without "
				"a wake source.");

		stopAllPowerTests();
		return;
	}

	Serial.println("[POWER TEST] Wake timer armed: ALL OK");

	// Stamp RTC memory only now, once sleep is actually going to happen. If the
	// counter were advanced before the timer check above, a failed check would
	// leave a cycle count that claims a sleep the board never took.
	//
	// After the wake this stamp is the only evidence that the previous boot was
	// ours and ended deliberately.
	rtcSleepTestMagic = SLEEP_POWER_TEST_RTC_MAGIC;
	rtcSleepTestCycle++;

	// Let Serial finish transmitting before most of the chip powers down.
	Serial.flush();

	esp_deep_sleep_start();

	// esp_deep_sleep_start() is declared noreturn, so reaching this line means
	// something is deeply wrong with the platform. Say so rather than falling
	// through into a loop() that believes it is still in an awake phase.
	Serial.println(
			"[POWER TEST] ERROR: esp_deep_sleep_start() returned. Deep sleep did "
			"not happen.");
	Serial.println(
			"[POWER TEST] Stopping the sleep test; this cycle measured nothing.");

	stopAllPowerTests();
}

void updateSleepPowerTest(unsigned long now)
{
	if (!sleepPowerTestRunning)
	{
		return;
	}

	if (now - sleepPowerTestAwakeStartedMs < SLEEP_POWER_TEST_AWAKE_MS)
	{
		return;
	}

	enterSleepPowerTestDeepSleep();
}

bool armSleepPowerTest(bool inaOff)
{
	if (autonomousTestArmed || autonomousTestRunning)
	{
		Serial.println(
				"[POWER TEST] ERROR: The autonomous logger bench test is armed.");
		Serial.println("[POWER TEST] Send LOGGER TEST STOP first.");
		return false;
	}

	if (wifiPowerTestArmed || wifiPowerTestRunning)
	{
		Serial.println(
				"[POWER TEST] ERROR: The Wi-Fi power test is already armed.");
		Serial.println(
				"[POWER TEST] Send POWER TEST STOP first, then arm the sleep test.");
		return false;
	}

	if (sleepPowerTestArmed)
	{
		if (sleepPowerTestInaOff == inaOff)
		{
			// Idempotent success: this exact variant is already armed.
			Serial.print(
					"[POWER TEST] Deep-sleep power test is already armed in this "
					"variant: ");
			Serial.println(sleepPowerTestVariantName());
			Serial.println("[POWER TEST] No change made.");
			return true;
		}

		// Switching variants silently would change what the DMM is measuring
		// without saying so, which is exactly the failure this refuses.
		Serial.print(
				"[POWER TEST] ERROR: The deep-sleep test is already armed in the "
				"other variant: ");
		Serial.println(sleepPowerTestVariantName());
		Serial.println(
				"[POWER TEST] Send POWER TEST STOP first, then arm the variant you "
				"want.");
		return false;
	}

	// Write the variant BEFORE the armed flag. If the variant write fails the
	// test is not armed at all, so a reboot can never resume a test whose
	// variant is unknown.
	if (!saveSleepPowerTestInaOff(inaOff))
	{
		Serial.println(
				"[POWER TEST] ERROR: Deep-sleep variant was NOT saved, so the test "
				"was not armed.");
		return false;
	}

	sleepPowerTestInaOff = inaOff;

	if (!saveSleepPowerTestArmed(true))
	{
		Serial.println(
				"[POWER TEST] ERROR: Deep-sleep test was NOT armed. It would not "
				"survive the USB disconnect, so it is not being started either.");
		return false;
	}

	sleepPowerTestArmed = true;

	// A freshly armed test starts its cycle count at zero.
	rtcSleepTestMagic = SLEEP_POWER_TEST_RTC_MAGIC;
	rtcSleepTestCycle = 0;

	Serial.println();
	Serial.print("[POWER TEST] Deep-sleep power test ARMED, variant: ");
	Serial.println(sleepPowerTestVariantName());
	Serial.println(
			"[POWER TEST] The armed flag and the variant are persisted in NVS, so "
			"this test survives USB disconnect and external power cycling.");
	Serial.println(
			"[POWER TEST] INA228 stays electrically powered from XIAO 3V3 in both "
			"variants. Nothing power-gates the INA228.");

	if (inaOff)
	{
		Serial.println(
				"[POWER TEST] The INA228 ADC will be placed in its documented "
				"shutdown mode before each deep sleep.");
		Serial.println(
				"[POWER TEST] Solar measurement is SACRIFICED during each sleep "
				"phase. That is the purpose of this variant.");
	}

	// Wi-Fi must be off for the whole test, including this first awake phase.
	disableWifi();

	telemetryPrintSleepTestEvent(
			inaOff ? "SLEEP_TEST_ARMED_INA_OFF" : "SLEEP_TEST_ARMED",
			experimentId,
			rtcSleepTestCycle);

	startSleepPowerTestAwakePhase();
	return true;
}

// ============================================================================
// RESUME NORMAL INTERVAL ACCOUNTING
// ============================================================================
//
// Called when a deep-sleep test ends. The INA228 has been accumulating charge
// through a window we deliberately did not account for, and that window is
// not 60 seconds long. Folding it into the next interval would corrupt that
// interval's average current and average power.
//
// So the accumulators are cleared and the interval timer restarts now. The
// charge measured during the suspended window is discarded on purpose; the
// running totals from before the test are untouched.
// ============================================================================

bool resumeIntervalAccounting()
{
	Serial.println(
			"[POWER TEST] Resuming normal 60-second interval accounting.");

	if (!resetInaAccumulators())
	{
		// Fail closed. Resuming with stale accumulation would produce a wrong
		// interval that looks exactly like a right one.
		intervalAccountingBlocked = true;

		Serial.println(
				"[ERROR] Could not clear INA228 accumulators after the power test.");
		Serial.println(
				"[ERROR] Interval accounting stays SUSPENDED so a partial "
				"accumulation window cannot be reported as a 60-second interval.");
		Serial.println(
				"[ERROR] Running charge and running energy are preserved unchanged.");
		Serial.println(
				"[ERROR] Reset the board once Serial access is available.");
		return false;
	}

	intervalAccountingBlocked = false;

	intervalStartMs = millis();
	lastHeartbeatMs = intervalStartMs;
	lastLiveSampleMs = intervalStartMs;

	Serial.print("[POWER TEST] Experiment ");
	Serial.print(experimentId);
	Serial.print(" continues at interval ");
	Serial.print(completedInterval);
	Serial.println(" with totals unchanged.");

	Serial.println("[POWER TEST] Interval accounting: ACTIVE");
	return true;
}

// ============================================================================
// STOP WHICHEVER POWER TEST IS ACTIVE
// ============================================================================

bool stopAllPowerTests()
{
	// REFUSE while the autonomous cycle owns the board.
	//
	// The rendezvous and the cold-boot window both pump the command parser, so
	// this function is reachable mid-wake. It used to run to completion there and
	// call resumeIntervalAccounting(), which resets the INA228 accumulators - the
	// ones the wake cycle had just reset to open a fresh autonomous interval,
	// while rtcAutoIntervalStartMs was left untouched. The next record then
	// reported a full cadence in interval_ms against charge accumulated only
	// since the command: under-counted, CRC-valid, and unflagged.
	//
	// A power test and autonomous mode are already mutually exclusive at arming
	// time, so there is nothing legitimate to stop here. RESET YES takes the same
	// shape for the same reason.
	//
	// The cold-boot maintenance window is deliberately NOT covered by
	// autonomousOwnsBoard(), so the recovery path for a board that somehow holds
	// both flags is still reset-then-stop inside that window.
	if (autonomousOwnsBoard())
	{
		Serial.println();
		Serial.println(
				"[POWER TEST] ERROR: The autonomous cycle currently owns the board.");
		Serial.print("[POWER TEST] State: ");
		Serial.println(autoStateName(autonomousState));
		Serial.println(
				"[POWER TEST] Stopping a power test here would reset the INA228 "
				"accumulators in the middle of an autonomous interval and silently "
				"under-count it. No change was made.");
		Serial.println(
				"[POWER TEST] Reset the board and send POWER TEST STOP inside the "
				"cold-boot maintenance window instead.");
		return false;
	}

	bool wifiTestWasActive = wifiPowerTestArmed || wifiPowerTestRunning;
	bool sleepTestWasActive = sleepPowerTestArmed || sleepPowerTestRunning;

	// Only the suspensions this function is actually clearing may be resumed by
	// it. intervalAccountingSuspended() also answers true for autonomous
	// ownership, which this function does not own and must not resume - that was
	// the second half of the same defect, and it fired even when no power test
	// was armed at all.
	bool accountingWasSuspended =
			sleepPowerTestRunning || intervalAccountingBlocked;

	Serial.println();

	if (!wifiTestWasActive && !sleepTestWasActive)
	{
		Serial.println("[POWER TEST] No power test was armed or running.");

		if (!accountingWasSuspended)
		{
			Serial.println(
					"[POWER TEST] Nothing to stop. The INA228 accumulators and the "
					"interval timer are left alone.");
		}
	}

	// Clear RAM state first so nothing else acts on a half-stopped test.
	wifiPowerTestRunning = false;
	wifiPowerTestPhase = 0;
	sleepPowerTestRunning = false;

	// Wi-Fi must end OFF no matter which test was running.
	disableWifi();

	// The INA228 must end in normal continuous conversion no matter which test
	// was running. This matters on the INA-OFF failure path, where shutdown
	// succeeded but the ESP32 then did not sleep: without this, the logger
	// would resume with a device that is not converting.
	bool inaRestored = restoreInaContinuousMode();

	if (inaRestored)
	{
		inaShutdownActive = false;
	}
	else
	{
		Serial.println(
				"[POWER TEST] ERROR: INA228 is not confirmed to be measuring. "
				"Readings must not be trusted until this is resolved.");
	}

	if (WiFi.getMode() != WIFI_OFF)
	{
		Serial.println(
				"[POWER TEST] ERROR: Wi-Fi did not turn off. Radio state is unknown.");
	}

	bool persistedStateCleared = true;

	if (wifiPowerTestArmed)
	{
		if (saveWifiPowerTestArmed(false))
		{
			wifiPowerTestArmed = false;
			Serial.println("[POWER TEST] Wi-Fi test flag cleared.");
		}
		else
		{
			Serial.println(
					"[POWER TEST] ERROR: Could not clear the persisted Wi-Fi test flag. "
					"It will still be armed after the next reboot.");
			persistedStateCleared = false;
		}
	}

	if (!inaRestored)
	{
		persistedStateCleared = false;
	}

	if (sleepPowerTestArmed)
	{
		Serial.print("[POWER TEST] Stopping deep-sleep test variant: ");
		Serial.println(sleepPowerTestVariantName());

		if (saveSleepPowerTestArmed(false))
		{
			sleepPowerTestArmed = false;
			Serial.println("[POWER TEST] Deep-sleep test flag cleared.");
		}
		else
		{
			Serial.println(
					"[POWER TEST] ERROR: Could not clear the persisted deep-sleep test "
					"flag. It will still be armed after the next reboot.");
			persistedStateCleared = false;
		}

		// Clear the variant selector too, so a later bare POWER TEST SLEEP can
		// never inherit INA-OFF behavior from a test that was already stopped.
		if (sleepPowerTestInaOff)
		{
			if (saveSleepPowerTestInaOff(false))
			{
				sleepPowerTestInaOff = false;
				Serial.println("[POWER TEST] Deep-sleep variant flag cleared.");
			}
			else
			{
				Serial.println(
						"[POWER TEST] ERROR: Could not clear the persisted deep-sleep "
						"variant flag.");
				persistedStateCleared = false;
			}
		}
	}

	if (sleepTestWasActive)
	{
		telemetryPrintSleepTestEvent("SLEEP_TEST_STOPPED", experimentId,
																	rtcSleepTestCycle);

		Serial.print("[POWER TEST] Completed sleep cycles this power-on: ");
		Serial.println(rtcSleepTestCycle);

		// The counter only describes one continuous battery run, so clear it
		// along with the test rather than letting it leak into the next one.
		rtcSleepTestMagic = 0;
		rtcSleepTestCycle = 0;
	}

	if (accountingWasSuspended)
	{
		if (!resumeIntervalAccounting())
		{
			persistedStateCleared = false;
		}
	}

	if (persistedStateCleared)
	{
		Serial.println("[POWER TEST] Power test stopped: ALL OK");
		Serial.println("[POWER TEST] Normal continuous logging resumed.");
	}
	else
	{
		Serial.println(
				"[POWER TEST] NOT ALL OK - power test stop did not fully succeed.");
	}

	return persistedStateCleared;
}

// ============================================================================
// COMBINED POWER-TEST STATUS
// ============================================================================

void printPowerTestStatus()
{
	Serial.println();

	Serial.print("[POWER TEST] Active test: ");

	switch (armedPowerTestMode())
	{
	case POWER_TEST_NONE:
		Serial.println("NONE");
		break;
	case POWER_TEST_WIFI:
		Serial.println("WIFI");
		break;
	case POWER_TEST_SLEEP:
		// Naming the variant here is the whole point: "SLEEP" alone would not
		// tell you whether the INA228 is converting through the sleep phase.
		Serial.print("SLEEP (");
		Serial.print(sleepPowerTestVariantName());
		Serial.println(")");
		break;
	case POWER_TEST_CONFLICT:
		Serial.println("CONFLICT");
		Serial.println(
				"[POWER TEST] ERROR: Both power-test flags are armed. No test is "
				"running. Send POWER TEST STOP to clear both.");
		break;
	}

	printWifiPowerTestStatus();

	Serial.print("[POWER TEST] Sleep test armed: ");
	Serial.println(sleepPowerTestArmed ? "YES" : "NO");

	if (sleepPowerTestArmed)
	{
		Serial.print("[POWER TEST] Sleep test variant: ");
		Serial.println(sleepPowerTestVariantName());

		Serial.print("[POWER TEST] INA228 during sleep phase: ");
		Serial.println(
				sleepPowerTestInaOff
						? "SHUTDOWN, measurement suspended"
						: "continuous conversion, measurement active");
	}

	Serial.print("[POWER TEST] Sleep test running: ");
	Serial.println(sleepPowerTestRunning ? "YES" : "NO");

	// Report what the INA228 says about itself, not what we intended.
	Serial.print("[POWER TEST] INA228 mode right now: ");

	if (inaIsInContinuousMode(false))
	{
		Serial.println("continuous conversion");
	}
	else
	{
		Serial.println("NOT continuous conversion");
		printPowerTestInaModeDetail();
	}

	if (sleepPowerTestRunning)
	{
		Serial.print("[POWER TEST] Sleep test cycle: ");
		Serial.println(rtcSleepTestCycle);

		Serial.print("[POWER TEST] Elapsed in awake phase: ");
		Serial.print((millis() - sleepPowerTestAwakeStartedMs) / 1000.0, 1);
		Serial.println(" seconds");

		Serial.print("[POWER TEST] Awake phase length: ");
		Serial.print(SLEEP_POWER_TEST_AWAKE_MS / 1000UL);
		Serial.println(" seconds");

		Serial.print("[POWER TEST] Deep sleep length: ");
		Serial.print(
				static_cast<unsigned long>(SLEEP_POWER_TEST_SLEEP_US / 1000000ULL));
		Serial.println(" seconds");
	}

	Serial.print("[POWER TEST] Interval accounting: ");

	if (intervalAccountingSuspended())
	{
		Serial.print("SUSPENDED: ");
		Serial.println(intervalAccountingSuspendReason());
	}
	else
	{
		Serial.println("ACTIVE");
	}

	printBootWakeReason();
}

void printHelp()
{
	Serial.println();

	Serial.println("[COMMAND] Available commands:");

	Serial.println(
			"  HELP       - show this list");

	Serial.println(
			"  STATUS     - print current experiment state and live sensor reading");

	Serial.println(
			"  VERSION    - print firmware version, source revision, and build ID");

	Serial.println(
			"  WIFI ON    - enable Wi-Fi station mode without connecting");

	Serial.println(
			"  WIFI OFF   - disable the Wi-Fi subsystem");

	Serial.println(
			"  WIFI STATUS - print Wi-Fi state and mode");

	Serial.println(
			"  POWER TEST WIFI   - arm the repeating Wi-Fi power test");

	Serial.println(
			"  POWER TEST SLEEP  - arm the deep-sleep power test, INA228 stays in "
			"continuous conversion");

	Serial.println(
			"  POWER TEST SLEEP INA OFF - arm the deep-sleep power test, INA228 "
			"enters its own shutdown mode before each sleep");

	Serial.println(
			"  POWER TEST STOP   - stop whichever power test is active");

	Serial.println(
			"  POWER TEST STATUS - print power-test state");

	Serial.println(
			"  LOGGER AUTONOMOUS ON     - enable autonomous sleep/wake/store mode");

	Serial.println(
			"  LOGGER AUTONOMOUS OFF    - disable it (only parsed while awake: "
			"during a USB rendezvous, a host session, or the cold-boot maintenance "
			"window)");

	Serial.println(
			"  LOGGER AUTONOMOUS STATUS - mode, cadence, storage, session state");

	Serial.println(
			"  LOGGER TEST AUTONOMOUS / STOP / STATUS - DEPRECATED aliases for the "
			"three above");

	Serial.println(
			"  LOGGER SESSION HOLD - claim this wake; stay awake while a host is "
			"attached (autonomous mode stays ARMED)");

	Serial.println(
			"  LOGGER SESSION KEEPALIVE - renew the host lease");

	Serial.println(
			"  LOGGER SESSION RELEASE - hand the board back to autonomous sleep "
			"(does NOT disarm autonomous mode)");

	Serial.println(
			"  LOGGER SESSION STATUS - print state, lease, and rendezvous info");

	Serial.println(
			"  LOGGER INTERVAL <seconds> - set the autonomous cadence");

	Serial.println(
			"  LOGGER STORAGE INFO - filesystem and durable-log summary");

	Serial.println(
			"  LOGGER STORAGE DUMP - decode stored records to Serial");

	Serial.println(
			"  LOGGER STORAGE CLEAR YES - erase stored records (NOT experiment state)");

	Serial.println(
			"  RESET      - explain reset confirmation");

	Serial.println(
			"  RESET YES  - start a NEW experiment");

	Serial.println();
}

// ============================================================================
// FIRMWARE IDENTITY
// ============================================================================
//
// Printed at boot, inside STATUS, and on demand via the VERSION command, so
// "what is actually on this board?" can be answered without a reset and
// without a full STATUS block.
//
// The three lines are always printed together. A revision without a version
// says nothing about intent, and a version without a revision cannot be tied
// back to source.

void printFirmwareIdentity()
{
	Serial.print("[FIRMWARE] Version:  ");
	Serial.println(FIRMWARE_VERSION);

	Serial.print("[FIRMWARE] Revision: ");

	if (FIRMWARE_GIT_REV[0] == '\0')
	{
		// Never a blank, never a plausible-looking placeholder. An image whose
		// source cannot be identified has to say that it cannot be identified.
		Serial.println(
				"UNKNOWN - not injected by this build (use tools/upload.sh)");
	}
	else
	{
		Serial.println(FIRMWARE_GIT_REV);
	}

	Serial.print("[FIRMWARE] Build ID: ");
	Serial.println(FIRMWARE_BUILD_ID);
}

// ============================================================================
// STATUS COMMAND
// ============================================================================

bool printStatus()
{
	Serial.println();

	Serial.println("[STATUS] Current logger state:");
	printFirmwareIdentity();

	Serial.print("[STATUS] Experiment ID      = ");
	Serial.println(experimentId);

	Serial.print("[STATUS] Completed interval = ");
	Serial.println(completedInterval);

	Serial.print("[STATUS] Running charge     = ");
	Serial.print(runningCharge_mAh, 6);
	Serial.println(" mAh");

	Serial.print("[STATUS] Running energy     = ");
	Serial.print(runningEnergy_mWh, 6);
	Serial.println(" mWh");

	// Without this line, the interval number above reads like a live counter
	// while it is actually frozen.
	if (intervalAccountingSuspended())
	{
		Serial.print("[STATUS] Interval accounting = SUSPENDED: ");
		Serial.println(intervalAccountingSuspendReason());
		Serial.println(
				"[STATUS] The interval and totals above are frozen, not advancing.");
	}
	else
	{
		Serial.println("[STATUS] Interval accounting = ACTIVE");
	}

	if (inaShutdownActive)
	{
		// Not a failure. The INA-OFF power-test variant shuts the part down on
		// purpose, and refusing to print stale registers is the correct behavior
		// (D-016), so the command did exactly what it should.
		Serial.println(
				"[STATUS] INA228               = SHUTDOWN, measurement suspended");
		Serial.println(
				"[STATUS] Voltage/current/power are NOT being updated and are not "
				"reported.");
		return true;
	}

	SensorReading reading;

	if (readSensor(reading, false))
	{
		Serial.print("[STATUS] Voltage            = ");
		Serial.print(reading.voltage_V, 4);
		Serial.println(" V");

		Serial.print("[STATUS] Current            = ");
		Serial.print(reading.current_mA, 3);
		Serial.println(" mA");

		Serial.print("[STATUS] Power              = ");
		Serial.print(reading.power_mW, 3);
		Serial.println(" mW");
	}
	else
	{
		Serial.println(
				"[ERROR] STATUS could not read INA228.");
		return false;
	}

	return true;
}

// ============================================================================
// START A NEW EXPERIMENT
// ============================================================================

bool resetExperiment()
{
	// A new experiment created while accounting is suspended would be frozen
	// from the moment it was born, and its first interval would never close.
	// Refuse instead of creating an experiment that silently does nothing.
	if (intervalAccountingSuspended())
	{
		Serial.println();
		Serial.print("[RESET] ERROR: Interval accounting is SUSPENDED: ");
		Serial.println(intervalAccountingSuspendReason());
		Serial.println(
				"[RESET] A new experiment would be created and then immediately "
				"frozen. Its first interval would never close.");
		Serial.println(
				"[RESET] Clear the suspension first, then send RESET YES again.");
		Serial.println("[RESET] No experiment was created.");
		return false;
	}

	intervalStartMs = millis();
	lastHeartbeatMs = intervalStartMs;
	lastLiveSampleMs = intervalStartMs;

	Serial.println();

	Serial.println(
			"============================================================");

	Serial.println("[RESET] RESET YES received.");

	Serial.println(
			"[RESET] Starting a NEW experiment.");

	if (experimentId == UINT32_MAX)
	{
		Serial.println(
				"[FATAL] experiment_id overflow. Cannot safely create another ID.");

		return false;
	}

	// First clear the INA228's physical hardware accumulators.
	//
	// We do this before changing our software totals so an INA failure cannot
	// silently give us a supposedly-clean experiment that actually contains old
	// hardware accumulation.
	if (!resetInaAccumulators())
	{
		Serial.println(
				"[ERROR] Experiment reset aborted because INA228 reset failed.");

		Serial.println(
				"============================================================");

		return false;
	}

	// Now establish the new software experiment.
	experimentId++;

	completedInterval = 0;
	runningCharge_mAh = 0.0;
	runningEnergy_mWh = 0.0;

	// Immediately save the new experiment ID and zero totals.
	//
	// This means a power failure one second later still boots into the NEW
	// experiment rather than bringing the previous experiment back.
	const LoggerCheckpoint newExperiment = {experimentId, completedInterval,
																					runningCharge_mAh, runningEnergy_mWh};

	if (!saveCheckpoint(newExperiment))
	{
		Serial.println(
				"[ERROR] New experiment exists in RAM, but its zero checkpoint "
				"could not be saved.");

		Serial.println(
				"[ERROR] Do not trust power-loss recovery until NVS succeeds.");

		return false;
	}

	// Start timing interval #1 NOW.
	intervalStartMs = millis();
	lastHeartbeatMs = intervalStartMs;
	lastLiveSampleMs = intervalStartMs;

	Serial.print("[RESET] experiment_id = ");
	Serial.println(experimentId);

	Serial.println("[RESET] interval = 0");

	Serial.println(
			"[RESET] running charge = 0.000000 mAh");

	Serial.println(
			"[RESET] running energy = 0.000000 mWh");

	Serial.println(
			"[RESET] New 60-second interval started NOW.");

	Serial.println(
			"[RESET] RESET COMPLETE: ALL OK");

	Serial.println(
			"============================================================");

	// Machine-readable marker.
	telemetryPrintExperimentStart(experimentId);

	telemetryPrintHeader();

	return true;
}

// ============================================================================
// PROCESS ONE COMPLETE SERIAL COMMAND
// ============================================================================

bool writeProtocolLine(const String &line, uint32_t timeoutMs)
{
	String framed = line;
	framed += '\n';

	const uint32_t deadline = millis() + timeoutMs;
	size_t offset = 0;

	while (offset < framed.length())
	{
		const size_t written = Serial.write(
				reinterpret_cast<const uint8_t *>(framed.c_str()) + offset,
				framed.length() - offset);
		offset += written;

		if (offset == framed.length())
		{
			return true;
		}

		if ((int32_t)(deadline - millis()) <= 0)
		{
			return false;
		}

		delay(1);
	}

	return true;
}

bool emitCommandAck(const String &command)
{
	String line = "CMD_ACK,";
	line += command;
	return writeProtocolLine(line, COMMAND_PROTOCOL_WRITE_TIMEOUT_MS);
}

bool emitCommandResult(const String &command, const char *status)
{
	String line = "CMD_RESULT,";
	line += command;
	line += ',';
	line += status;
	return writeProtocolLine(line, COMMAND_PROTOCOL_WRITE_TIMEOUT_MS);
}

void processCommand(String command)
{
	// Remove leading/trailing whitespace.
	command.trim();

	// Make command matching case-insensitive.
	//
	// status
	// STATUS
	// Status
	//
	// all become:
	//
	// STATUS
	command.toUpperCase();

	if (command.length() == 0)
	{
		return;
	}

	// CMD_ACK means PARSED AND ACCEPTED FOR EXECUTION, and nothing more. It is
	// emitted before dispatch, so it is deliberately still emitted for a command
	// that is about to be refused (D-030).
	if (!emitCommandAck(command))
	{
		// The bounded writer missed its 100 ms deadline, so the host will not see
		// an ACK and will treat this command as unheard even though it is about to
		// run. Saying so locally is the only place this is observable.
		Serial.println(
				"[COMMAND] ERROR: CMD_ACK was not fully written within the protocol "
				"deadline. The host cannot see that this command was parsed.");
	}

	Serial.print("[COMMAND] Received: ");
	Serial.println(command);

	// --------------------------------------------------------------------------
	// COMMAND RESULT CONTRACT
	// --------------------------------------------------------------------------
	//
	//   CMD_ACK,<command>            parsed and accepted for execution
	//   CMD_RESULT,<command>,OK      the command actually COMPLETED
	//   CMD_RESULT,<command>,ERROR   parsed, but did not complete successfully
	//
	// `commandOk` used to be `recognized`, which answered only "did the dispatcher
	// match a branch". That reported OK for a LOGGER AUTONOMOUS OFF whose NVS
	// write failed, for a LOGGER INTERVAL that was rejected as out of range, for a
	// RESET YES that was refused, and for a POWER TEST STOP that could not clear a
	// persisted flag. tools/send.sh printed ALL OK and exited 0 for every one of
	// them - the same class of defect as the 2026-09-11 failure that produced
	// D-022, reproduced inside the machine protocol built to prevent it.
	//
	// Every handler with a meaningful failure mode now returns bool and that
	// return lands here. Handlers that cannot fail stay void and leave commandOk
	// true. Refusals count as failures: a command that was declined did not do
	// what was asked.
	//
	// Two deliberate exceptions, both idempotent successes rather than no-ops:
	// arming something already armed, and disarming something already off. The
	// requested end state holds and nothing failed.
	bool resultEmitted = false;
	bool recognized = true;
	bool commandOk = true;

	if (command == "HELP")
	{

		printHelp();
	}
	else if (command == "STATUS")
	{

		commandOk = printStatus();
	}
	else if (command == "VERSION")
	{

		// Separate from STATUS on purpose. "Which image is on the board?" is
		// asked far more often than the full state block, and it has to be
		// answerable inside a short rendezvous window.
		printFirmwareIdentity();
	}
	else if (command == "WIFI ON")
	{

		commandOk = enableWifi();
	}
	else if (command == "WIFI OFF")
	{

		commandOk = disableWifi();
	}
	else if (command == "WIFI STATUS")
	{

		printWifiStatus();
	}
	else if (command == "POWER TEST WIFI")
	{

		commandOk = armWifiPowerTest();
	}
	else if (command == "POWER TEST SLEEP")
	{

		commandOk = armSleepPowerTest(false);
	}
	else if (command == "POWER TEST SLEEP INA OFF")
	{

		commandOk = armSleepPowerTest(true);
	}
	else if (command == "POWER TEST STOP")
	{

		commandOk = stopAllPowerTests();
	}
	else if (command == "POWER TEST STATUS")
	{

		printPowerTestStatus();
	}
	else if (command == "LOGGER AUTONOMOUS ON")
	{

		commandOk = armAutonomousTest();
	}
	else if (command == "LOGGER AUTONOMOUS OFF")
	{

		commandOk = stopAutonomousTest();
	}
	else if (command == "LOGGER AUTONOMOUS STATUS")
	{

		printAutonomousStatus();
	}
	else if (command == "LOGGER TEST AUTONOMOUS")
	{

		printDeprecatedCommand("LOGGER TEST AUTONOMOUS", "LOGGER AUTONOMOUS ON");
		commandOk = armAutonomousTest();
	}
	else if (command == "LOGGER TEST STATUS")
	{

		printDeprecatedCommand("LOGGER TEST STATUS", "LOGGER AUTONOMOUS STATUS");
		printAutonomousStatus();
	}
	else if (command == "LOGGER TEST STOP")
	{

		printDeprecatedCommand("LOGGER TEST STOP", "LOGGER AUTONOMOUS OFF");
		commandOk = stopAutonomousTest();
	}
	else if (command == "LOGGER SESSION HOLD")
	{

		// REFUSED: autonomous mode is off, so no lease is needed. ERROR: the board
		// is already committed to a deferred autonomous sleep (D-044).
		const HoldResult hold = hostSessionHold();
		emitCommandResult(
				command,
				hold == HOLD_GRANTED
						? "OK"
						: (hold == HOLD_NOT_ARMED ? "REFUSED" : "ERROR"));
		resultEmitted = true;
	}
	else if (command == "LOGGER SESSION KEEPALIVE")
	{

		const uint32_t keepalivesBefore = hostKeepaliveCount;
		hostSessionKeepalive();
		emitCommandResult(
				command,
				hostKeepaliveCount > keepalivesBefore ? "OK" : "FAILED");
		resultEmitted = true;
	}
	else if (command == "LOGGER SESSION RELEASE")
	{

		// OK only when the release COMPLETED (D-044): the session ended and, with
		// autonomous mode armed, the handoff was prepared and the deferred sleep
		// armed. It used to be keyed on wasHeld alone, so a handoff that failed and
		// left the board awake still answered OK.
		Serial.println("[SESSION] RELEASE parsed");
		const bool wasHeld = hostSessionHeld;
		const bool released = hostSessionRelease();
		const bool resultQueued = emitCommandResult(
				command, wasHeld ? (released ? "OK" : "ERROR") : "NOT_HELD");
		Serial.println(
				resultQueued ? "[SESSION] RELEASE result queued"
										 : "[SESSION] ERROR: RELEASE result not fully queued");
		resultEmitted = true;
	}
	else if (command == "LOGGER SESSION STATUS")
	{

		printHostSessionStatus();
	}
	else if (command == "LOGGER STORAGE INFO")
	{

		commandOk = printStorageInfo();
	}
	else if (command == "LOGGER STORAGE DUMP")
	{

		commandOk = dumpStorage();
	}
	else if (command == "LOGGER STORAGE CLEAR")
	{

		Serial.println(
				"[STORAGE] Clearing storage requires confirmation.");
		Serial.println(
				"[STORAGE] Type exactly: LOGGER STORAGE CLEAR YES");
	}
	else if (command == "LOGGER STORAGE CLEAR YES")
	{

		commandOk = clearStorage();
	}
	else if (command.startsWith("LOGGER INTERVAL "))
	{

		// The one authoritative cadence setting. Everything in the autonomous
		// path derives from it, so this is the only place it changes.
		String argument = command.substring(16);
		argument.trim();

		long seconds = argument.toInt();

		if (seconds <= 0)
		{
			Serial.print("[AUTO] ERROR: Not a valid interval: ");
			Serial.println(argument);
			commandOk = false;
		}
		else if (seconds < static_cast<long>(AUTO_INTERVAL_SECONDS_MIN) ||
						 seconds > static_cast<long>(AUTO_INTERVAL_SECONDS_MAX))
		{

			Serial.print("[AUTO] ERROR: Interval must be between ");
			Serial.print(AUTO_INTERVAL_SECONDS_MIN);
			Serial.print(" and ");
			Serial.print(AUTO_INTERVAL_SECONDS_MAX);
			Serial.print(" seconds. Got ");
			Serial.println(seconds);
			commandOk = false;
		}
		else if (autonomousTestArmed || autonomousTestRunning)
		{
			Serial.println(
					"[AUTO] ERROR: Cannot change the interval while the test is armed.");
			Serial.println(
					"[AUTO] Send LOGGER TEST STOP first, so stored records are not "
					"split across two cadences without an explicit boundary.");
			commandOk = false;
		}
		else if (saveAutonomousInterval(static_cast<uint32_t>(seconds)))
		{
			autonomousIntervalSeconds = static_cast<uint32_t>(seconds);
			Serial.print("[AUTO] Autonomous interval set to ");
			Serial.print(autonomousIntervalSeconds);
			Serial.println(" seconds: ALL OK");
		}
		else
		{
			Serial.println("[AUTO] ERROR: Interval was not saved.");
			commandOk = false;
		}
	}
	else if (command == "RESET")
	{

		Serial.println(
				"[COMMAND] RESET requires confirmation.");

		Serial.println(
				"[COMMAND] Type exactly: RESET YES");
	}
	else if (command == "RESET YES")
	{

		commandOk = resetExperiment();
	}
	else
	{
		recognized = false;

		Serial.print("[WARNING] Unknown command: ");
		Serial.println(command);

		Serial.println(
				"[WARNING] Type HELP for available commands.");
	}

	if (!resultEmitted)
	{
		// An unrecognized command never ran, so it cannot have completed. A
		// recognized one reports what its handler actually did.
		const bool succeeded = recognized && commandOk;

		if (!emitCommandResult(command, succeeded ? "OK" : "ERROR"))
		{
			Serial.println(
					"[COMMAND] ERROR: CMD_RESULT was not fully written within the "
					"protocol deadline. The host cannot see how this command ended.");
		}

		// The machine line is the protocol. This one is for a person reading the
		// console, and it exists so a failure is visible in the same place the
		// handler's own ERROR lines are.
		if (!succeeded)
		{
			Serial.print("[COMMAND] NOT ALL OK - ");
			Serial.print(command);
			Serial.println(recognized ? " did not complete successfully."
																: " is not a known command.");
		}
	}
}

// ============================================================================
// RECEIVE SERIAL COMMAND CHARACTERS
// ============================================================================
//
// There are TWO buffers involved.
//
// 1. Arduino/ESP32 Serial receive buffer
//
//    Managed for us by the framework.
//
//    Serial.available() tells us how many unread bytes are waiting there.
//
//
// 2. serialCommandBuffer
//
//    Managed by OUR firmware.
//
//    We move characters from the framework's receive buffer into our String
//    until Enter tells us that the command is complete.
// ============================================================================

void handleSerialCommands()
{
	// Several characters may have arrived since loop() last ran, so read all
	// currently waiting characters.
	while (Serial.available())
	{

		// Serial.read() removes ONE byte from the incoming receive buffer.
		//
		// It returns an integer, so we explicitly convert it to a char because
		// we're treating Serial input as text.
		char c =
				static_cast<char>(Serial.read());

		// Arduino Serial Monitor normally sends \n, \r, or both when Enter is
		// pressed.
		//
		// Either means:
		//
		//   "The command is complete."
		if (c == '\n' || c == '\r')
		{

			// Ignore blank lines.
			if (serialCommandBuffer.length() > 0)
			{

				processCommand(serialCommandBuffer);

				// Empty our command-building buffer so it is ready for the next
				// command.
				serialCommandBuffer = "";
			}

			continue;
		}

		// There is no legitimate BMW Solar Logger command anywhere near 80
		// characters long.
		//
		// This prevents an accidental paste or corrupted stream from allowing the
		// String to grow indefinitely.
		if (serialCommandBuffer.length() >= 80)
		{

			Serial.println(
					"[ERROR] Serial command exceeded 80 characters. Buffer cleared.");

			serialCommandBuffer = "";

			continue;
		}

		// Ordinary character:
		//
		// append it to the command currently being constructed.
		serialCommandBuffer += c;
	}
}

// ============================================================================
// HEARTBEAT
// ============================================================================

void printHeartbeat()
{
	// A shut-down INA228 still answers I2C reads, but the values it returns are
	// left over from before shutdown. Printing them next to "ALL OK" would be
	// presenting stale registers as a live measurement.
	if (inaShutdownActive)
	{
		Serial.println(
				"[HEARTBEAT] INA228 is in SHUTDOWN. No conversions are running and "
				"no values are being updated.");
		return;
	}

	SensorReading reading;

	if (!readSensor(reading, false))
	{
		Serial.println(
				"[HEARTBEAT] ERROR: INA228 read failed");
		return;
	}

	unsigned long elapsedMs =
			millis() - intervalStartMs;

	Serial.print("[HEARTBEAT] ALL OK");

	Serial.print(" | experiment ");
	Serial.print(experimentId);

	if (sleepPowerTestRunning)
	{
		// "next interval N" would be a lie here: no interval is going to close
		// while accounting is suspended. Report the sleep test's clock instead.
		Serial.print(" | SLEEP TEST cycle ");
		Serial.print(rtcSleepTestCycle);

		Serial.print(" | awake ");
		Serial.print(
				(millis() - sleepPowerTestAwakeStartedMs) / 1000.0, 1);
		Serial.print(" s of ");
		Serial.print(SLEEP_POWER_TEST_AWAKE_MS / 1000UL);

		Serial.print(" s | interval accounting SUSPENDED | ");
	}
	else if (intervalAccountingSuspended())
	{
		// The test is over but accounting could not safely resume. Saying
		// "next interval N" here would promise an interval that will not close.
		Serial.print(" | interval accounting SUSPENDED (");
		Serial.print(intervalAccountingSuspendReason());
		Serial.print(") | ");
	}
	else
	{
		Serial.print(" | next interval ");
		Serial.print(completedInterval + 1);

		Serial.print(" | elapsed ");
		Serial.print(elapsedMs / 1000.0, 1);
		Serial.print(" s | ");
	}

	Serial.print(reading.voltage_V, 4);
	Serial.print(" V | ");

	Serial.print(reading.current_mA, 3);
	Serial.print(" mA | ");

	Serial.print(reading.power_mW, 3);
	Serial.println(" mW");
}

// ============================================================================
// CLOSE ONE 60-SECOND MEASUREMENT INTERVAL
// ============================================================================

bool closeMeasurementInterval()
{
	unsigned long endMs =
			millis();

	unsigned long elapsedMs =
			endMs - intervalStartMs;

	double elapsedSeconds =
			elapsedMs / 1000.0;

	Serial.println();

	Serial.println(
			"============================================================");

	Serial.println(
			"[LOGGER] INTERVAL TIMER EXPIRED");

	Serial.print(
			"[LOGGER] Actual elapsed time = ");

	Serial.print(elapsedSeconds, 3);

	Serial.println(
			" seconds");

	// --------------------------------------------------------------------------
	// Capture instantaneous end-of-interval measurement.
	// --------------------------------------------------------------------------

	Serial.println();

	Serial.println(
			"[INA228] Capturing end-of-interval measurements...");

	SensorReading reading;

	if (!readSensor(reading, false))
	{
		Serial.println(
				"[ERROR] Could not close interval because end measurement failed.");

		return false;
	}

	// --------------------------------------------------------------------------
	// Read hardware accumulation BEFORE resetting it.
	// --------------------------------------------------------------------------

	Serial.println(
			"[INA228] Reading accumulated CHARGE...");

	double intervalCharge_mAh;

	if (!readAccumulatedCharge_mAh(intervalCharge_mAh))
	{
		Serial.println(
				"[ERROR] Could not read accumulated CHARGE.");

		return false;
	}

	Serial.println(
			"[INA228] Reading accumulated ENERGY...");

	double intervalEnergy_mWh;

	if (!readAccumulatedEnergy_mWh(intervalEnergy_mWh))
	{
		Serial.println(
				"[ERROR] Could not read accumulated ENERGY.");

		return false;
	}

	Serial.println(
			"[INA228] Closing completed interval.");

	// --------------------------------------------------------------------------
	// Reset INA accumulators so they begin measuring the NEXT interval.
	// --------------------------------------------------------------------------

	if (!resetInaAccumulators())
	{
		Serial.println(
				"[ERROR] New interval was NOT started because accumulator reset failed.");

		return false;
	}

	// Start the next software interval timer.
	intervalStartMs = millis();

	Serial.println(
			"[INA228] New accumulation interval started.");

	// --------------------------------------------------------------------------
	// Update software totals.
	// --------------------------------------------------------------------------

	completedInterval++;

	// Counted here, at the actual close, so the figure cannot depend on when any
	// global was initialized.
	if (hostSessionHeld)
	{
		hostSessionIntervalCloses++;
	}

	runningCharge_mAh += intervalCharge_mAh;

	runningEnergy_mWh += intervalEnergy_mWh;

	// CHARGE tells us the total current integrated over the interval.
	//
	// Rearranging that lets us calculate the average current during the minute.
	double averageCurrent_mA =
			intervalCharge_mAh *
			3600.0 /
			elapsedSeconds;

	// Same idea for ENERGY and average power.
	double averagePower_mW =
			intervalEnergy_mWh *
			3600.0 /
			elapsedSeconds;

	// --------------------------------------------------------------------------
	// Diagnostic shunt read.
	// --------------------------------------------------------------------------

	SensorReading diagnosticReading;

	if (!readSensor(diagnosticReading, true))
	{
		Serial.println(
				"[ERROR] Interval captured, but VSHUNT diagnostics failed.");

		diagnosticReading = reading;
	}

	double shuntPower_mW =
			(diagnosticReading.shuntVoltage_mV / 1000.0) *
			(diagnosticReading.current_mA / 1000.0) *
			1000.0;

	double shuntRangePercent =
			fabs(
					diagnosticReading.shuntVoltage_mV /
					1000.0) /
			VSHUNT_FULL_SCALE_V *
			100.0;

	// --------------------------------------------------------------------------
	// Human-readable interval output.
	// --------------------------------------------------------------------------

	Serial.println();

	Serial.println(
			"------------------------------------------------------------");

	Serial.print("EXPERIMENT #");
	Serial.println(experimentId);

	Serial.print("INTERVAL #");
	Serial.println(completedInterval);

	Serial.print("Actual interval:     ");
	Serial.print(elapsedSeconds, 3);
	Serial.println(" seconds");

	Serial.println();

	Serial.print("Ending voltage:      ");
	Serial.print(reading.voltage_V, 4);
	Serial.println(" V");

	Serial.print("Current right now:   ");
	Serial.print(reading.current_mA, 3);
	Serial.println(" mA");

	Serial.print("Power right now:     ");
	Serial.print(reading.power_mW, 3);
	Serial.println(" mW");

	Serial.print("Temperature:         ");
	Serial.print(reading.temperature_C, 2);
	Serial.println(" C");

	Serial.println();

	Serial.print("Raw VSHUNT counts:   ");
	Serial.println(diagnosticReading.rawVshuntCounts);

	Serial.print("Shunt voltage:       ");
	Serial.print(diagnosticReading.shuntVoltage_mV, 6);
	Serial.println(" mV");

	Serial.print("VSHUNT/R current:    ");
	Serial.print(diagnosticReading.currentFromShunt_mA, 3);
	Serial.println(" mA");

	Serial.print("CURRENT register:    ");
	Serial.print(diagnosticReading.current_mA, 3);
	Serial.println(" mA");

	Serial.print("Current difference:  ");
	Serial.print(
			diagnosticReading.current_mA -
					diagnosticReading.currentFromShunt_mA,
			3);
	Serial.println(" mA");

	Serial.println();

	Serial.print("Interval charge:     ");
	Serial.print(intervalCharge_mAh, 6);
	Serial.println(" mAh");

	Serial.print("Interval energy:     ");
	Serial.print(intervalEnergy_mWh, 6);
	Serial.println(" mWh");

	Serial.print("Average current:     ");
	Serial.print(averageCurrent_mA, 3);
	Serial.println(" mA");

	Serial.print("Average power:       ");
	Serial.print(averagePower_mW, 3);
	Serial.println(" mW");

	Serial.println();

	Serial.print("RUNNING charge:      ");
	Serial.print(runningCharge_mAh, 6);
	Serial.println(" mAh");

	Serial.print("RUNNING energy:      ");
	Serial.print(runningEnergy_mWh, 6);
	Serial.println(" mWh");

	Serial.print("Shunt power:         ");
	Serial.print(shuntPower_mW, 3);
	Serial.println(" mW");

	Serial.print("Shunt range used:    ");
	Serial.print(shuntRangePercent, 3);
	Serial.println(" %");

	Serial.println(
			"------------------------------------------------------------");

	// --------------------------------------------------------------------------
	// Machine-readable CSV data.
	// --------------------------------------------------------------------------

	// The interval's numbers are final here: the averages are computed, and the
	// running totals have already taken this interval in. The row is printed
	// before the checkpoint below, so it is emitted whether or not NVS accepts
	// the state it describes.
	const TelemetryInterval row = {
			experimentId,
			completedInterval,
			elapsedSeconds,
			reading.voltage_V,
			reading.current_mA,
			reading.power_mW,
			reading.temperature_C,
			intervalCharge_mAh,
			intervalEnergy_mWh,
			averageCurrent_mA,
			averagePower_mW,
			runningCharge_mAh,
			runningEnergy_mWh};

	telemetryPrintInterval(row);

	// --------------------------------------------------------------------------
	// Persist this completed interval.
	//
	// Currently this happens EVERY interval.
	// --------------------------------------------------------------------------

	Serial.println(
			"[NVS] CHECKPOINT REQUIRED");

	const LoggerCheckpoint checkpoint = {experimentId, completedInterval,
																			 runningCharge_mAh, runningEnergy_mWh};

	if (!saveCheckpoint(checkpoint))
	{
		Serial.println(
				"[ERROR] Measurement succeeded, but NVS checkpoint failed.");

		Serial.println(
				"[ERROR] CSV data above is valid, but power-loss recovery state "
				"is not guaranteed.");
	}

	return true;
}

// ============================================================================
// AUTONOMOUS BENCH TEST: SETTINGS AND SEQUENCE POLICY
// ============================================================================
//
// What these decide. The typed NVS reads and writes underneath them are in
// nvs_persistence.cpp, which names the keys and knows nothing about cadence
// limits, block widths, or which sequence authority wins.
// ============================================================================

// Read the persisted autonomous settings and decide whether the stored cadence
// is one this firmware will run at.
//
// The read itself is loadAutonomousConfig() in nvs_persistence.cpp. The range
// check stayed here, with AUTO_INTERVAL_SECONDS_MIN and _MAX: the supported
// range is cadence policy (D-018), the LOGGER INTERVAL handler tests the same
// two constants, and the persistence module has no business deciding which
// stored cadence is acceptable.
bool loadAutonomousSettings()
{
	// This cannot report failure today: a namespace that will not open still
	// yields "not armed" and the default cadence, and still reports success.
	// That is the defect recorded in docs/BACKLOG.md under "NVS load failures
	// become plausible defaults with no signal", preserved across the move
	// rather than fixed inside it. The return value is carried through so that
	// fixing it later reaches both call sites.
	const bool loaded = loadAutonomousConfig(autonomousTestArmed,
																					 autonomousIntervalSeconds,
																					 AUTO_INTERVAL_SECONDS_DEFAULT);

	// A stored value outside the supported range would silently change the
	// cadence the test believes it is running at.
	if (autonomousIntervalSeconds < AUTO_INTERVAL_SECONDS_MIN ||
			autonomousIntervalSeconds > AUTO_INTERVAL_SECONDS_MAX)
	{

		Serial.print("[ERROR] Stored autonomous interval is out of range: ");
		Serial.println(autonomousIntervalSeconds);
		Serial.print("[ERROR] Falling back to the default of ");
		Serial.print(AUTO_INTERVAL_SECONDS_DEFAULT);
		Serial.println(" seconds.");

		autonomousIntervalSeconds = AUTO_INTERVAL_SECONDS_DEFAULT;
	}

	return loaded;
}

// Reserve a block of sequence numbers before using any of them. A crash
// inside a reserved block abandons the block: the next boot starts past it,
// producing a visible GAP rather than a silent REUSE.
//
// How wide a block is, and every write to the RTC-retained mirror of the
// reservation, stay here; the mirror itself is defined in
// autonomous_retained_state.cpp, which owns its lifetime and none of its
// writes (D-063). saveSequenceHighWater() stores the number and reports whether the
// store worked; which of the log tail and the reservation is authoritative is
// D-023 policy and is decided in sequenceAuthorityNext().
//
// The RTC mirror advances only after the NVS write succeeds, exactly as
// before: a reservation that was not persisted must not raise the floor that
// makes duplicate sequence numbers impossible.
bool reserveSequenceBlock(uint32_t fromSeq)
{
	uint32_t newHighWater = fromSeq + AUTO_SEQ_BLOCK;

	if (!saveSequenceHighWater(newHighWater))
	{
		return false;
	}

	rtcAutoSeqHighWater = newHighWater;
	return true;
}

// Reserve only when the existing reservation does not already cover the
// sequence about to be used.
//
// The previous code called reserveSequenceBlock() unconditionally on every arm
// and every cold boot, so each restart burned a fresh 64-wide block whether or
// not the previous one had been used. Two cold boots after an eight-record run
// was enough to push the next sequence from 9 to 131.
// announceNoOp must be false on the timer-wake path. That path measures
// "total work excluding Serial", and a Serial.print() inside the measured
// region would inflate the number the whole bench test exists to produce.
bool ensureSequenceReservation(uint32_t nextSeq, bool announceNoOp)
{
	if (nextSeq < rtcAutoSeqHighWater)
	{
		if (announceNoOp)
		{
			Serial.print("[STORAGE] Sequence reservation already covers ");
			Serial.print(nextSeq);
			Serial.print("; reserved through ");
			Serial.print(rtcAutoSeqHighWater - 1);
			Serial.println(". No NVS write needed.");
		}
		return true;
	}

	return reserveSequenceBlock(nextSeq);
}

// ============================================================================
// AUTONOMOUS BENCH TEST: RECORD HELPERS
// ============================================================================

const char *autoTimeQualityName(uint8_t flags)
{
	switch (flags & AUTO_FLAG_TIME_QUALITY_MASK)
	{
	case AUTO_TIME_UNKNOWN:
		return "UNKNOWN";
	case AUTO_TIME_SYNCHRONIZED:
		return "SYNCHRONIZED";
	case AUTO_TIME_HOLDOVER:
		return "HOLDOVER";
	default:
		return "RESERVED";
	}
}

void printAutoRecord(const AutoRecord &record)
{
	Serial.print("seq=");
	Serial.print(record.seq);

	Serial.print(" boot=");
	Serial.print(record.boot_id);

	Serial.print(" exp=");
	if (record.flags & AUTO_FLAG_EXPERIMENT_UNKNOWN)
	{
		Serial.print("UNKNOWN");
	}
	else
	{
		Serial.print(record.experiment_id);
	}

	Serial.print(" elapsed_ms=");
	Serial.print(record.session_elapsed_ms);

	Serial.print(" interval_ms=");
	Serial.print(record.interval_ms);

	// The snapshot fields carry impossible sentinels when readSensor() failed
	// during the wake that wrote this record. Printing them as numbers would show
	// 4294.97 V and -2147 A, which is at least obviously wrong - but naming the
	// condition costs one branch and removes the need to recognize the values.
	if (autoRecordSnapshotUnread(record))
	{
		Serial.print(" V=SNAPSHOT_UNREAD I_mA=SNAPSHOT_UNREAD");
		Serial.print(" P_mW=SNAPSHOT_UNREAD T_C=SNAPSHOT_UNREAD");
	}
	else
	{
		Serial.print(" V=");
		Serial.print(record.bus_uV / 1000000.0, 6);

		Serial.print(" I_mA=");
		Serial.print(record.avg_current_uA / 1000.0, 3);

		Serial.print(" P_mW=");
		Serial.print(record.avg_power_uW / 1000.0, 3);

		Serial.print(" T_C=");
		Serial.print(record.temp_mC / 1000.0, 3);
	}

	Serial.print(" dQ_uAh=");
	Serial.print(record.interval_charge_uAh);

	Serial.print(" dE_uWh=");
	Serial.print(record.interval_energy_uWh);

	Serial.print(" Qsum_uAh=");
	Serial.print(static_cast<long long>(record.running_charge_uAh));

	Serial.print(" Esum_uWh=");
	Serial.print(static_cast<long long>(record.running_energy_uWh));

	Serial.print(" time=");
	Serial.print(autoTimeQualityName(record.flags));

	Serial.print(" epoch=");
	Serial.print(record.epoch_s);

	Serial.print(" flags=0x");
	Serial.print(record.flags, HEX);

	// Decoded inline so a dump is readable without a lookup table. Bits 1-0 are
	// the time-quality field and are already printed above as time=.
	Serial.print("[");

	bool firstName = true;

	if (record.flags & AUTO_FLAG_FIRST_AFTER_BOOT)
	{
		Serial.print("FIRST_AFTER_BOOT");
		firstName = false;
	}

	if (record.flags & AUTO_FLAG_ACCUM_SUSPECT)
	{
		if (!firstName)
			Serial.print(",");
		Serial.print("ACCUM_SUSPECT");
		firstName = false;
	}

	if (record.flags & AUTO_FLAG_INTERVAL_ODD)
	{
		if (!firstName)
			Serial.print(",");
		Serial.print("INTERVAL_ODD");
		firstName = false;
	}

	if (record.flags & AUTO_FLAG_INA_MATHOF)
	{
		if (!firstName)
			Serial.print(",");
		Serial.print("INA_MATHOF");
		firstName = false;
	}

	if (record.flags & AUTO_FLAG_INA_ACCUM_OF)
	{
		if (!firstName)
			Serial.print(",");
		Serial.print("INA_ACCUM_OF");
		firstName = false;
	}

	if (record.flags & AUTO_FLAG_EXPERIMENT_UNKNOWN)
	{
		if (!firstName)
			Serial.print(",");
		Serial.print("EXPERIMENT_UNKNOWN");
		firstName = false;
	}

	if (firstName)
	{
		Serial.print("none");
	}

	Serial.print("]");

	Serial.print(" crc=0x");
	Serial.println(record.crc32, HEX);
}

// ============================================================================
// AUTONOMOUS BENCH TEST: STORAGE
// ============================================================================
//
// The LittleFS mechanics moved to storage.h / storage.cpp on 2026-09-24: the
// mount that never formats, the log path, the full scan, the tail repair and
// the append. Which sequence number the next record carries moved to
// sequence_authority.h / .cpp on 2026-10-01: the D-023 reconciliation of the
// log against the NVS reservation. What is left here composes the two with the
// RTC-retained state neither module writes: the mirror of the reservation and
// the running totals (D-055). Their definitions moved to
// autonomous_retained_state.cpp on 2026-10-02; their writes did not (D-063).
// ============================================================================

// Boot recovery. Returns the sequence to use for the next record.
//
// Nothing here is silent: every discarded byte is counted and reported by
// autoStorageScanAndRepair(), which owns the scan, the reporting, and any
// repair the shape of the damage allows, and sequenceAuthorityNext() reports
// which of the log and the reservation it took the sequence from.
//
// retainedStateValid is whether rtcAutoMagic was valid at the call site BEFORE
// the call site set it. Every caller sets the magic immediately before calling,
// so by the time this runs the magic always reads valid and cannot answer the
// question; the caller captures the answer first and passes it in. It decides
// only what happens to the running totals when the log could not be read.
uint32_t autoStorageRecover(bool retainedStateValid)
{
	AutoLogScan scan = autoStorageScanAndRepair();

	// Cached so the reservation logic can see it without a second NVS read.
	rtcAutoSeqHighWater = loadSequenceHighWater();

	// Where the next sequence comes from: the D-023 reconciliation of this scan
	// against the reservation just read. sequence_authority.cpp decides it and
	// prints which of the two it used.
	uint32_t next = sequenceAuthorityNext(scan, rtcAutoSeqHighWater);

	// Test-local running totals continue from the last valid record so a
	// reboot does not restart them at zero.
	//
	// Only when the scan read the log to its end (D-060). After a failed open
	// the scan's totals are zero because nothing was read, and after a short
	// read they come from whichever record the scan reached last, which is not
	// provably the last one written. Neither is a recovery.
	//
	// What replaces them then depends on whether the retained state was valid,
	// which is the magic's job (D-011), not on what the bootloader is believed to
	// do to RTC memory on a reset. Valid: carry them, the best figure there is.
	// Not valid: they are not a figure at all, so restart at zero. Both say so.
	if (scan.openFailed || scan.readError)
	{
		Serial.print("[STORAGE] Running totals could NOT be recovered: ");
		Serial.println(scan.openFailed
											 ? "the log could not be opened, so none of it was read."
											 : "a short read stopped the scan before the end of the "
												 "log.");

		if (retainedStateValid)
		{
			Serial.println(
					"[STORAGE] Retained RTC state was valid before recovery, so its "
					"totals are the best figure available.");
			Serial.print("[STORAGE] Carrying the retained totals instead: Qsum_uAh=");
			Serial.print(static_cast<long long>(rtcAutoRunChargeUAh));
			Serial.print(" Esum_uWh=");
			Serial.print(static_cast<long long>(rtcAutoRunEnergyUWh));
			Serial.println(". These were NOT checked against the log.");
		}
		else
		{
			rtcAutoRunChargeUAh = 0;
			rtcAutoRunEnergyUWh = 0;

			Serial.println(
					"[STORAGE] Retained RTC state was NOT valid before recovery, so there "
					"are no totals to carry.");
			Serial.println(
					"[STORAGE] Restarting the running totals at Qsum_uAh=0 Esum_uWh=0. "
					"The next record does NOT continue the log's totals.");
		}
	}
	else
	{
		rtcAutoRunChargeUAh = scan.lastRunChargeUAh;
		rtcAutoRunEnergyUWh = scan.lastRunEnergyUWh;
	}

	return next;
}

// ============================================================================
// AUTONOMOUS BENCH TEST: NON-DESTRUCTIVE INA VALIDATION
// ============================================================================
//
// Timer-wake validation. This function performs READS ONLY.
//
// It must never write CONFIG, ADC_CONFIG, or SHUNT_CAL. The INA228 stayed
// powered and converting through the sleep, so it is already configured, and
// writing ADC_CONFIG would interrupt and restart the conversion in progress,
// discarding accumulation that has not yet been committed.
//
// Returns true when the device is present, correctly configured, and still in
// continuous conversion. On failure it prints the exact register values so
// the state is diagnosable rather than merely "wrong".
// ============================================================================

bool validateInaForWake(uint16_t &configOut,
												uint16_t &adcConfigOut,
												uint16_t &shuntCalOut)
{
	bool ok = true;

	uint16_t manufacturer;
	uint16_t device;

	if (!readRegister16(REG_MANUFACTURER_ID, manufacturer) ||
			!readRegister16(REG_DEVICE_ID, device))
	{
		Serial.println("[AUTO] ERROR: Could not read INA228 identity registers.");
		return false;
	}

	if (manufacturer != 0x5449)
	{
		Serial.print("[AUTO] ERROR: Unexpected MANUFACTURER_ID: 0x");
		Serial.println(manufacturer, HEX);
		ok = false;
	}

	if (!readRegister16(REG_CONFIG, configOut) ||
			!readRegister16(REG_ADC_CONFIG, adcConfigOut) ||
			!readRegister16(REG_SHUNT_CAL, shuntCalOut))
	{
		Serial.println("[AUTO] ERROR: Could not read INA228 configuration.");
		return false;
	}

	// ADCRANGE must still be 0 or every current value is scaled wrong.
	if ((configOut & 0x0010) != 0)
	{
		Serial.print("[AUTO] ERROR: ADCRANGE is not 0. CONFIG = 0x");
		Serial.println(configOut, HEX);
		ok = false;
	}

	uint16_t mode = inaModeFromAdcConfig(adcConfigOut);

	if (mode != INA_MODE_CONTINUOUS_ALL)
	{
		Serial.print(
				"[AUTO] ERROR: INA228 is not in continuous conversion. MODE = 0x");
		Serial.println(mode, HEX);
		Serial.println(
				"[AUTO] The interval that just elapsed cannot be trusted: the device "
				"was not converting for all of it.");
		ok = false;
	}

	if (adcConfigOut != ADC_CONFIG_VALUE)
	{
		Serial.print("[AUTO] WARNING: ADC_CONFIG differs from expected. Got 0x");
		Serial.print(adcConfigOut, HEX);
		Serial.print(", expected 0x");
		Serial.println(ADC_CONFIG_VALUE, HEX);
		ok = false;
	}

	if (shuntCalOut != SHUNT_CAL_VALUE)
	{
		Serial.print("[AUTO] ERROR: SHUNT_CAL differs from expected. Got ");
		Serial.print(shuntCalOut);
		Serial.print(", expected ");
		Serial.println(SHUNT_CAL_VALUE);
		Serial.println(
				"[AUTO] Accumulated charge cannot be scaled correctly with an "
				"unexpected calibration constant.");
		ok = false;
	}

	return ok;
}

// ============================================================================
// AUTONOMOUS BENCH TEST: ONE WAKE CYCLE
// ============================================================================
//
// Entered directly from setup() on a deep-sleep timer wake, BEFORE any of the
// normal cold-boot initialization runs. That ordering is the entire point:
// the normal path calls resetInaAccumulators() without ever reading ENERGY or
// CHARGE, which would destroy the interval this test exists to capture.
//
// This function does not return. It ends in deep sleep, or in an explicit
// error stop.
// ============================================================================

// Timing is measured from setupEntryMicros, not from a value captured at the
// call site, so the printed total covers the whole awake period. The path
// argument decides how the number is labeled: a cold-boot total and a
// timer-wake total are not the same measurement and must never look alike.
void autonomousDeepSleepAgain(AutoSleepPath path);
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
