afxjzs/solar-logger/(commit log)

2026-09-09 sorting out directory structure
    [bmw_solar_log.csv]
2026-09-09 updated structure and added uv
    [bmw_solar_log.csv]
2026-09-09 serial swap not working. saving changes
    [bmw_solar_log.csv, intervals.csv, samples.csv]
2026-09-09 before the wifi test
    [intervals-pre-timestamps.csv, samples-pre-timestamps.csv]
2026-09-10 updated to include full INA deep sleep test
    [bmw_solar_log.csv]
2026-09-17 Fix six correctness defects; CMD_RESULT means completed (D-041)
    [firmware_version.h, solar-logger.ino]
2026-09-17 Add 57 regression tests; fix two host defects found by them
    [device_session.py, device_tool.py, solar_logger.py]
2026-09-18 Fix autonomous scheduler handoff timing (D-046)
    [events.csv, intervals.csv, samples.csv]
2026-09-18 Extract INA228 driver module
2026-09-23 Fix INA228 accumulator overflow sampling order
    [ina228.h, solar-logger.ino]
2026-09-24 Extract record format and document current wiring
2026-09-24 Fix durable log recovery and reconcile project docs
    [solar-logger.ino]
2026-10-01 Preserve hardware acceptance evidence and its tooling under logs/
    [post-dump.txt, pre-dump.txt, storage-dump.txt]
2026-10-02 Preserve the 16a299d hardware acceptance and its sequence check
    [post-dump.txt, pre-dump-2.txt, pre-dump.txt]
2026-10-02 Track the agent instructions, checkpoint and stage brief
2026-10-02 Add the offline charger-transition and capture-gap report
2026-10-05 Record the D-063 hardware acceptance and its evidence
    [post-dump-continuity.txt, post-dump.txt, pre-dump.txt]
